astracore-ai/Astracore-Neo/09_synthesis/pnr_acc_bank.md

# pnr_acc_bank -- `acc_bank` placed and routed on ASAP7 through OpenROAD-flow-scripts

Generated by `07_ci/pnr/report.py` from the `pnr` job's logs (run 188 (workflow_dispatch on a3-physical at 2f2fb5b6f), started 2026-10-13 06:14:26 UTC; image `openroad/orfs:26Q4-124-g3451ca1f5`; make arguments `none`; ORFS targets `synth,floorplan,place,cts,route,do-finish`). Status: **complete**. The netlist is `synth.py`'s for the unit's subtree (acc_bank) at 1,250 ps on ASAP7 SS (ORFS CORNER = WC, the same NLDM files), the memory leaves as FakeRAM2.0 macros; ORFS's defaults otherwise (`07_ci/pnr/designs/neo_common.mk`, the block's `config.mk`). Timing is the final stage's: OpenRCX parasitics, the propagated clock tree. ASAP7 is a predictive academic PDK: the picoseconds and square microns are the library's, the ratios and the paths the design's.

| Figure | Value |
| --- | --- |
| die / core | 215.80 x 215.80 um / 213.73 x 213.57 um (46,571.4 / 45,646.7 um2) |
| utilization (cells and macros over the core, after routing) | 56.2 % |
| standard cells: synthesized (prep.py) / after placement / after routing | 19,220 / 24,323 / 24,729 (of these 4,898 timing-repair buffers, 173 tie cells, 2,880 taps; 82,987 fill cells beside them) |
| macros | 1 (22,822.5 um2) |
| cell area: synthesized / routed | 2,473.3 / 2,850.9 um2 |
| routed wire length / vias | 359,587 um / 246,356 |
| DRC violations after detailed routing (first iteration) / antenna-violating nets / diodes | 0 (5,607) / 0 / 0 |
| global-route congestion (usage, overflow H / V / total) | 13.49 %, 0 / 0 / 0 |
| setup WNS / TNS | **0.0 ps** / 0.0 ps (0 violating endpoints) |
| hold WNS / TNS | 34.8 / 0.0 ps (0 violating endpoints) |
| minimum period, register to register / with the I/O paths | 1,246.2 / 1,246.2 ps (802 MHz) |
| clock tree: sinks, buffers (TritonCTS), buffers on a path, levels | 2,286 (clk 1, clk_regs 2,285), 156, 2-5, 4; after routing 215 clock buffers + 65 clock inverters |
| clock skew, setup / hold (with the 8 % setup uncertainty in the setup figure) | 146.3 / 46.9 ps |
| power at the flow's default activity (internal / switching / leakage / total) | 5.680 / 1.680 / 0.1730 / **7.530 mW** |
| max slew / cap / fanout violations | 12 / 0 / 0 |

Power in this table: OpenSTA's default switching activity (0.1 transitions per cycle on the inputs, propagated; the flow sets none); the recorded activity's figure is in the section on power below when the block has one.

## Power: the default activity and the recorded activity

OpenSTA's report_power on the final database (OpenRCX parasitics, the propagated clock) at 1,250 ps, ASAP7 SS 0.63 V / 100 C (the WC corner's NLDM and power tables), in mW.

The recorded activity: `acc_bank.json.gz` -- cocotb core (16x8, NCHK = 4): C1 dense conv + C5 2:4 sparse conv, Verilator 5.020, scope `TOP.neo_core.u_dp.u_acc`, a window of 2,858 cycles at 500 ps in simulation (the activity is per cycle, applied at the period above); MAC utilization in the window 56.7 %. Of the block's 2,285 flops 622 took a recorded bit by name, 1,663 by the folded index (a wider unit than the one simulated: the bit of the same signal at the index modulo the recorded range), 0 kept the propagated default; input bits 87 / 2,057 / 0. Pins annotated in the database: 2285 of 2285, input ports 2144.

| activity | group | internal | switching | leakage | total |
| --- | --- | --- | --- | --- | --- |
| default | Sequential | 1.970 | 0.108 | 0.0145 | 2.090 |
| default | Combinational | 0.357 | 0.791 | 0.0272 | 1.180 |
| default | Clock | 1.210 | 0.776 | 0.0020 | 1.990 |
| default | Macro | 2.150 | 0.000 | 0.1290 | 2.280 |
| default | Total | 5.680 | 1.680 | 0.1730 | **7.530** |
| recorded | Sequential | 2.350 | 0.178 | 0.0147 | 2.550 |
| recorded | Combinational | 0.628 | 1.230 | 0.0294 | 1.890 |
| recorded | Clock | 1.210 | 0.776 | 0.0020 | 1.990 |
| recorded | Macro | 2.150 | 0.000 | 0.1290 | 2.280 |
| recorded | Total | 6.340 | 2.180 | 0.1750 | **8.700** |

Recorded / default: 1.155 (total), dynamic 1.158.

## The worst routed paths

Setup: `fwd1_reg` -> `u_mem/u_macro`, arrival 1,385.8 ps (launch clock latency included), required 1,389.6 ps, slack **3.8 ps**, 24 cells (`orfs/reports/6_finish.rpt`).

Hold: `idx1[8]_reg` -> `u_mem/u_macro`, slack 34.8 ps.

The ten worst endpoints (`orfs/reports/neo/paths_max.txt`): `u_mem/u_macro` 3.8, `u_mem/u_macro` 23.1, `u_mem/u_macro` 25.3, `u_mem/u_macro` 27.5, `new_q[95]_reg` 27.8, `new_q[863]_reg` 28.7, `u_mem/u_macro` 30.2, `u_abft.r_q[99]_reg` 30.6, `new_q[574]_reg` 31.9, `u_mem/u_macro` 32.6.

## Routed against synthesized

The synthesized estimate is the netlist ORFS placed (prep.py's) flat in OpenSTA with the same SDC, an ideal clock and no wires (`in/synth_sta/`); the routed figure is ORFS's final STA. A minimum period here is the period minus the worst slack of the paths named (the 8 % setup uncertainty and the setup time included on both sides). The routed netlist is not the synthesized one: the flow resizes and buffers it (timing repair in floorplan, CTS and global route), so the ratio carries both the wires and the repair.

| | synthesized | routed | routed / synthesized |
| --- | --- | --- | --- |
| setup WNS at 1,250 ps | 59.5 ps | 0.0 ps | |
| minimum period, register to register | 1,190.5 ps | 1,246.2 ps | 1.047 |
| minimum period with the I/O paths | 1,190.5 ps | 1,246.2 ps | 1.047 |

Setup WNS through the flow (repair_timing's own tables, before -> after its repair): CTS (placement parasitics, the propagated clock) -64.0 -> -9.0 ps; global route (its parasitics) -40.2 -> -15.1 ps; final (OpenRCX) 0.0 ps.

Synthesized worst path: `fwd1_reg` -> `u_mem/u_macro`, arrival 1,040.5 ps, slack 59.5 ps; register to register `fwd1_reg` -> `u_mem/u_macro`, slack 59.5 ps.

`synth.py`'s own figures for the units of the block (each unit with its children as extracted timing models, the synthesis job's per-unit view, 0.2 of the period on every unit's I/O):

| unit | instances in the block | cells (own) | WNS | minimum period | worst path |
| --- | --- | --- | --- | --- | --- |
| `acc_bank` | 1 | 18,131 | 59.5 ps | 1,190.5 ps | `fwd1_reg` -> `u_mem` |

The subtree's slowest unit by synth.py: `acc_bank` at 1,190.5 ps; routed register to register / that = 1.047.

## Macros (FakeRAM2.0, `07_ci/pnr/fakeram.py`)

| leaf (synth.py) | macro | words x bits, groups | pins | LEF size | LEF area | um2 / bit | synthesis model (memories.md) |
| --- | --- | --- | --- | --- | --- | --- | --- |
| `neo_mem_rf_w1056_d512_g1_rb1` | `fakeram7_512x1056_g1_1w1r` | 512 x 1056, G = 1 | 2133 | 136.99 x 166.60 um | 22,822.5 um2 | 0.0422 | 22,734.2 um2 (x1.0) |

Placed by ORFS's macro placer (lower-left corner, orientation): `u_mem/u_macro` at (1.1, 1.1) um R180.

## Runtime and peak memory

| ORFS step | elapsed | peak memory |
| --- | --- | --- |
| 1_1_yosys_canonicalize | 0.0 min | 27 MB |
| 1_2_yosys | 0.0 min | 26 MB |
| 1_synth | 0.0 min | 232 MB |
| 2_1_floorplan | 0.1 min | 286 MB |
| 2_2_floorplan_macro | 0.4 min | 264 MB |
| 2_3_floorplan_tapcell | 0.0 min | 205 MB |
| 2_4_floorplan_pdn | 0.0 min | 225 MB |
| 3_1_place_gp_skip_io | 0.1 min | 275 MB |
| 3_2_place_iop | 0.0 min | 219 MB |
| 3_3_place_gp | 1.6 min | 737 MB |
| 3_4_place_resized | 0.2 min | 304 MB |
| 3_5_place_dp | 0.2 min | 584 MB |
| 4_1_cts | 0.4 min | 598 MB |
| 5_1_grt | 2.4 min | 1,064 MB |
| 5_2_route | 13.9 min | 5,815 MB |
| 5_3_fillcell | 0.0 min | 502 MB |
| 6_1_fill | 0.0 min | 289 MB |
| 6_report | 0.5 min | 654 MB |
| 7_neo_report | 0.2 min | 477 MB |
| 4_rsz_lec (inside its stage's step) | 0.1 min | 159 MB |
| 6_final_lec (inside its stage's step) | 0.1 min | 158 MB |
| **all steps** | **20.3 min** | **5,815 MB** |

By stage: synth (netlist read) 0.0 min, 232 MB; floorplan 0.6 min, 286 MB; place 2.2 min, 737 MB; cts 0.4 min, 598 MB; route 16.4 min, 5,815 MB; finish 0.6 min, 654 MB; neo_report 0.2 min, 477 MB.

The job's own stages (`run.json`): fakeram exit 0 in 0.0 min; prep exit 0 in 0.0 min; synth_sta exit 0; activity exit 0 in 0.1 min; synth exit 0 in 0.1 min; floorplan exit 0 in 0.6 min; place exit 0 in 2.2 min; cts exit 0 in 0.4 min; route exit 0 in 16.4 min; do-finish exit 0 in 0.6 min; neo_report exit 0 in 0.2 min.
