astracore-ai/Astracore-Neo/09_synthesis/pnr_act_feeder.md

# pnr_act_feeder -- `act_feeder` placed and routed on ASAP7 through OpenROAD-flow-scripts

Generated by `07_ci/pnr/report.py` from the `pnr` job's logs (run 188 (workflow_dispatch on a3-physical at 2f2fb5b6f), started 2026-10-13 06:13:01 UTC; image `openroad/orfs:26Q4-124-g3451ca1f5`; make arguments `none`; ORFS targets `synth,floorplan,place,cts,route,do-finish`). Status: **complete**. The netlist is `synth.py`'s for the unit's subtree (act_feeder) at 1,250 ps on ASAP7 SS (ORFS CORNER = WC, the same NLDM files), the memory leaves as FakeRAM2.0 macros; ORFS's defaults otherwise (`07_ci/pnr/designs/neo_common.mk`, the block's `config.mk`). Timing is the final stage's: OpenRCX parasitics, the propagated clock tree. ASAP7 is a predictive academic PDK: the picoseconds and square microns are the library's, the ratios and the paths the design's.

| Figure | Value |
| --- | --- |
| die / core | 119.99 x 355.97 um / 117.94 x 353.70 um (42,712.1 / 41,714.0 um2) |
| utilization (cells and macros over the core, after routing) | 55.6 % |
| standard cells: synthesized (prep.py) / after placement / after routing | 9,084 / 13,183 / 13,245 (of these 1,856 timing-repair buffers, 435 tie cells, 3,389 taps; 67,358 fill cells beside them) |
| macros | 1 (22,064.7 um2) |
| cell area: synthesized / routed | 980.4 / 1,143.2 um2 |
| routed wire length / vias | 119,281 um / 91,446 |
| DRC violations after detailed routing (first iteration) / antenna-violating nets / diodes | 0 (2,048) / 0 / 0 |
| global-route congestion (usage, overflow H / V / total) | 5.08 %, 0 / 0 / 0 |
| setup WNS / TNS | **0.0 ps** / 0.0 ps (0 violating endpoints) |
| hold WNS / TNS | 73.6 / 0.0 ps (0 violating endpoints) |
| minimum period, register to register / with the I/O paths | 948.2 / 1,243.1 ps (804 MHz) |
| clock tree: sinks, buffers (TritonCTS), buffers on a path, levels | 436 (clk 1, clk_regs 435), 26, 2-3, 1; after routing 39 clock buffers + 12 clock inverters |
| clock skew, setup / hold (with the 8 % setup uncertainty in the setup figure) | 114.8 / 25.6 ps |
| power at the flow's default activity (internal / switching / leakage / total) | 4.850 / 2.340 / 0.1410 / **7.330 mW** |
| max slew / cap / fanout violations | 0 / 0 / 0 |

Power in this table: OpenSTA's default switching activity (0.1 transitions per cycle on the inputs, propagated; the flow sets none); the recorded activity's figure is in the section on power below when the block has one.

## Power: the default activity and the recorded activity

OpenSTA's report_power on the final database (OpenRCX parasitics, the propagated clock) at 1,250 ps, ASAP7 SS 0.63 V / 100 C (the WC corner's NLDM and power tables), in mW.

The recorded activity: `act_feeder.json.gz` -- cocotb core (16x8, NCHK = 4): C1 dense conv + C5 2:4 sparse conv, Verilator 5.020, scope `TOP.neo_core.u_dp.u_feeder`, a window of 2,858 cycles at 500 ps in simulation (the activity is per cycle, applied at the period above); MAC utilization in the window 56.7 %. Of the block's 435 flops 347 took a recorded bit by name, 66 by the folded index (a wider unit than the one simulated: the bit of the same signal at the index modulo the recorded range), 22 kept the propagated default; input bits 239 / 515 / 0. Pins annotated in the database: 413 of 413, input ports 754.

| activity | group | internal | switching | leakage | total |
| --- | --- | --- | --- | --- | --- |
| default | Sequential | 0.449 | 0.072 | 0.0010 | 0.522 |
| default | Combinational | 2.040 | 2.120 | 0.0108 | 4.180 |
| default | Clock | 0.210 | 0.139 | 0.0003 | 0.349 |
| default | Macro | 2.150 | 0.000 | 0.1290 | 2.280 |
| default | Total | 4.850 | 2.340 | 0.1410 | **7.330** |
| recorded | Sequential | 0.271 | 0.008 | 0.0012 | 0.280 |
| recorded | Combinational | 0.052 | 0.074 | 0.0149 | 0.141 |
| recorded | Clock | 0.210 | 0.139 | 0.0003 | 0.349 |
| recorded | Macro | 2.150 | 0.000 | 0.1290 | 2.280 |
| recorded | Total | 2.680 | 0.221 | 0.1450 | **3.050** |

Recorded / default: 0.416 (total), dynamic 0.403.

## The worst routed paths

Setup: `iy[16]_reg` -> `ctrl_err`, arrival 893.1 ps (launch clock latency included), required 900.0 ps, slack **6.9 ps**, 14 cells (`orfs/reports/6_finish.rpt`).

Register to register: `s2_d[4]_reg` -> `a_d[9]_reg`, slack 301.8 ps.

Hold: `m[8]_reg` -> `row_idx[8]_reg`, slack 73.6 ps.

The ten worst endpoints (`orfs/reports/neo/paths_max.txt`): `ctrl_err` 6.9, `x_vec[232]` 44.2, `x_vec[238]` 45.4, `x_vec[237]` 45.8, `x_vec[245]` 46.8, `x_vec[246]` 46.9, `x_vec[243]` 47.0, `x_vec[241]` 47.0, `x_vec[242]` 47.2, `x_vec[240]` 47.4.

## Routed against synthesized

The synthesized estimate is the netlist ORFS placed (prep.py's) flat in OpenSTA with the same SDC, an ideal clock and no wires (`in/synth_sta/`); the routed figure is ORFS's final STA. A minimum period here is the period minus the worst slack of the paths named (the 8 % setup uncertainty and the setup time included on both sides). The routed netlist is not the synthesized one: the flow resizes and buffers it (timing repair in floorplan, CTS and global route), so the ratio carries both the wires and the repair.

| | synthesized | routed | routed / synthesized |
| --- | --- | --- | --- |
| setup WNS at 1,250 ps | 146.9 ps | 0.0 ps | |
| minimum period, register to register | 892.0 ps | 948.2 ps | 1.063 |
| minimum period with the I/O paths | 1,103.1 ps | 1,243.1 ps | 1.127 |

Setup WNS through the flow (repair_timing's own tables, before -> after its repair): CTS (placement parasitics, the propagated clock) -74.1 -> -27.5 ps; global route (its parasitics) -49.8 -> -41.2 ps; final (OpenRCX) 0.0 ps.

Synthesized worst path: `cfg_ct[2]` -> `s1[10]_reg`, arrival 968.8 ps, slack 146.9 ps; register to register `c1_d[2]_reg` -> `a_d[9]_reg`, slack 358.0 ps.

`synth.py`'s own figures for the units of the block (each unit with its children as extracted timing models, the synthesis job's per-unit view, 0.2 of the period on every unit's I/O):

| unit | instances in the block | cells (own) | WNS | minimum period | worst path |
| --- | --- | --- | --- | --- | --- |
| `act_feeder` | 1 | 8,696 | 122.3 ps | 928.8 ps | `cfg_ct[2]` -> `s1[10]_reg` |

The subtree's slowest unit by synth.py: `act_feeder` at 928.8 ps; routed register to register / that = 1.021.

## Macros (FakeRAM2.0, `07_ci/pnr/fakeram.py`)

| leaf (synth.py) | macro | words x bits, groups | pins | LEF size | LEF area | um2 / bit | synthesis model (memories.md) |
| --- | --- | --- | --- | --- | --- | --- | --- |
| `neo_mem_rf_w512_d1024_g2_rb1` | `fakeram7_1024x512_g2_1w1r` | 1024 x 512, G = 2 | 1048 | 66.50 x 331.80 um | 22,064.7 um2 | 0.0421 | 22,045.3 um2 (x1.0) |

Placed by ORFS's macro placer (lower-left corner, orientation): `u_mem/u_macro` at (52.4, 1.1) um MX.

## Runtime and peak memory

| ORFS step | elapsed | peak memory |
| --- | --- | --- |
| 1_1_yosys_canonicalize | 0.0 min | 26 MB |
| 1_2_yosys | 0.0 min | 26 MB |
| 1_synth | 0.0 min | 202 MB |
| 2_1_floorplan | 0.0 min | 248 MB |
| 2_2_floorplan_macro | 0.2 min | 227 MB |
| 2_3_floorplan_tapcell | 0.0 min | 191 MB |
| 2_4_floorplan_pdn | 0.0 min | 209 MB |
| 3_1_place_gp_skip_io | 0.1 min | 256 MB |
| 3_2_place_iop | 0.0 min | 199 MB |
| 3_3_place_gp | 0.4 min | 715 MB |
| 3_4_place_resized | 0.1 min | 257 MB |
| 3_5_place_dp | 0.1 min | 398 MB |
| 4_1_cts | 0.1 min | 419 MB |
| 5_1_grt | 0.6 min | 851 MB |
| 5_2_route | 4.8 min | 4,116 MB |
| 5_3_fillcell | 0.0 min | 426 MB |
| 6_1_fill | 0.0 min | 247 MB |
| 6_report | 0.2 min | 412 MB |
| 7_neo_report | 0.1 min | 335 MB |
| 4_rsz_lec (inside its stage's step) | 0.0 min | 71 MB |
| 6_final_lec (inside its stage's step) | 0.0 min | 71 MB |
| **all steps** | **6.8 min** | **4,116 MB** |

By stage: synth (netlist read) 0.0 min, 202 MB; floorplan 0.2 min, 248 MB; place 0.7 min, 715 MB; cts 0.1 min, 419 MB; route 5.5 min, 4,116 MB; finish 0.2 min, 412 MB; neo_report 0.1 min, 335 MB.

The job's own stages (`run.json`): fakeram exit 0; prep exit 0 in 0.0 min; synth_sta exit 0; activity exit 0 in 0.1 min; synth exit 0 in 0.1 min; floorplan exit 0 in 0.3 min; place exit 0 in 0.8 min; cts exit 0 in 0.1 min; route exit 0 in 5.5 min; do-finish exit 0 in 0.2 min; neo_report exit 0 in 0.1 min.
