astracore-ai/Astracore-Neo/09_synthesis/pnr_bank_bist_wrap.md

# pnr_bank_bist_wrap -- `bank_bist_wrap` placed and routed on ASAP7 through OpenROAD-flow-scripts

Generated by `07_ci/pnr/report.py` from the `pnr` job's logs (run 194 (workflow_dispatch on a3-physical at 97c3b1c0e), started 2026-10-13 06:42:08 UTC; image `openroad/orfs:26Q4-124-g3451ca1f5`; make arguments `none`; ORFS targets `synth,floorplan,place,cts,route,do-finish`). Status: **complete**. The netlist is `synth.py`'s for the unit's subtree (sram_bank, mbist, bank_bist_wrap) at 1,250 ps on ASAP7 SS (ORFS CORNER = WC, the same NLDM files), the memory leaves as FakeRAM2.0 macros; ORFS's defaults otherwise (`07_ci/pnr/designs/neo_common.mk`, the block's `config.mk`). Timing is the final stage's: OpenRCX parasitics, the propagated clock tree. ASAP7 is a predictive academic PDK: the picoseconds and square microns are the library's, the ratios and the paths the design's.

| Figure | Value |
| --- | --- |
| die / core | 1201.53 x 1201.53 um / 1199.45 x 1199.34 um (1,443,660.0 / 1,438,550.0 um2) |
| utilization (cells and macros over the core, after routing) | 60.2 % |
| standard cells: synthesized (prep.py) / after placement / after routing | 7,205 / 75,407 / 76,204 (of these 4,398 timing-repair buffers, 135 tie cells, 65,000 taps; 1,754,792 fill cells beside them) |
| macros | 16 (862,508.0 um2) |
| cell area: synthesized / routed | 853.8 / 3,722.2 um2 |
| routed wire length / vias | 504,242 um / 163,613 |
| DRC violations after detailed routing (first iteration) / antenna-violating nets / diodes | 0 (9,130) / 0 / 0 |
| global-route congestion (usage, overflow H / V / total) | 0.69 %, 0 / 0 / 0 |
| setup WNS / TNS | **-1,756.6 ps** / -1,164,350.2 ps (1,570 violating endpoints) |
| hold WNS / TNS | 92.8 / 0.0 ps (0 violating endpoints) |
| minimum period, register to register / with the I/O paths | 2,838.6 / 3,006.6 ps (333 MHz) |
| clock tree: sinks, buffers (TritonCTS), buffers on a path, levels | 96 (clk 16, clk_regs 80), 36, 2-9, 3; after routing 93 clock buffers + 3 clock inverters |
| clock skew, setup / hold (with the 8 % setup uncertainty in the setup figure) | 290.6 / 201.1 ps |
| power at the flow's default activity (internal / switching / leakage / total) | 44.500 / 16.800 / 2.1000 / **63.500 mW** |
| max slew / cap / fanout violations | 415 / 0 / 0 |

Power in this table: OpenSTA's default switching activity (0.1 transitions per cycle on the inputs, propagated; the flow sets none); the recorded activity's figure is in the section on power below when the block has one.

## Power: the default activity and the recorded activity

OpenSTA's report_power on the final database (OpenRCX parasitics, the propagated clock) at 1,250 ps, ASAP7 SS 0.63 V / 100 C (the WC corner's NLDM and power tables), in mW.

The recorded activity: `bank_bist_wrap.json.gz` -- cocotb tile (2x2 mesh of 16x8 cores, 32 words per link flit): M1 + M18 + M19, tile (0,0), Verilator 5.020, scope `TOP.tile_mesh_cocotb.u_mesh.g_y[0].g_x[0].u_t.u_bank`, a window of 10,306 cycles at 500 ps in simulation (the activity is per cycle, applied at the period above); MAC utilization in the window 32.8 %. Of the block's 80 flops 45 took a recorded bit by name, 35 by the folded index (a wider unit than the one simulated: the bit of the same signal at the index modulo the recorded range), 0 kept the propagated default; input bits 652 / 28 / 0. Pins annotated in the database: 80 of 80, input ports 680.

| activity | group | internal | switching | leakage | total |
| --- | --- | --- | --- | --- | --- |
| default | Sequential | 0.088 | 0.037 | 0.0002 | 0.126 |
| default | Combinational | 9.170 | 16.400 | 0.0398 | 25.600 |
| default | Clock | 0.508 | 0.457 | 0.0008 | 0.966 |
| default | Macro | 34.800 | 0.000 | 2.0600 | 36.800 |
| default | Total | 44.500 | 16.800 | 2.1000 | **63.500** |
| recorded | Sequential | 0.051 | 0.000 | 0.0002 | 0.052 |
| recorded | Combinational | 0.029 | 0.043 | 0.0565 | 0.128 |
| recorded | Clock | 0.508 | 0.457 | 0.0008 | 0.966 |
| recorded | Macro | 34.400 | 0.000 | 2.0600 | 36.500 |
| recorded | Total | 35.000 | 0.499 | 2.1200 | **37.600** |

Recorded / default: 0.592 (total), dynamic 0.579.

## The worst routed paths

Setup: `u_bank/u_mem/u_lane7` -> `rdata[236]`, arrival 2,656.6 ps (launch clock latency included), required 900.0 ps, slack **-1,756.6 ps**, 15 cells (`orfs/reports/6_finish.rpt`).

Register to register: `u_bist/elem[1]_reg` -> `u_bank/u_mem/u_lane12`, slack -1,588.6 ps.

Hold: `u_bist/mism_q_reg` -> `u_bist/mism_q_reg`, slack 92.8 ps.

The ten worst endpoints (`orfs/reports/neo/paths_max.txt`): `rdata[236]` -1756.6, `u_bank/u_mem/u_lane12` -1588.6, `u_bank/u_mem/u_lane12` -1550.2, `rdata[336]` -1527.4, `u_bank/u_mem/u_lane13` -1523.6, `rdata[351]` -1522.3, `rdata[338]` -1494.5, `rdata[350]` -1490.5, `rdata[322]` -1485.9, `u_bank/u_mem/u_lane12` -1484.0.

## Routed against synthesized

The synthesized estimate is the netlist ORFS placed (prep.py's) flat in OpenSTA with the same SDC, an ideal clock and no wires (`in/synth_sta/`); the routed figure is ORFS's final STA. A minimum period here is the period minus the worst slack of the paths named (the 8 % setup uncertainty and the setup time included on both sides). The routed netlist is not the synthesized one: the flow resizes and buffers it (timing repair in floorplan, CTS and global route), so the ratio carries both the wires and the repair.

| | synthesized | routed | routed / synthesized |
| --- | --- | --- | --- |
| setup WNS at 1,250 ps | -188.6 ps | -1,756.6 ps | |
| minimum period, register to register | 1,438.6 ps | 2,838.6 ps | 1.973 |
| minimum period with the I/O paths | 1,438.6 ps | 3,006.6 ps | 2.090 |

Setup WNS through the flow (repair_timing's own tables, before -> after its repair): floorplan (no wires, ideal clock: the synthesized estimate, then gate sizing) -188.6 -> -39.4 ps; CTS (placement parasitics, the propagated clock) -2,525.3 -> -2,320.5 ps; global route (its parasitics) -1,971.0 -> -1,819.4 ps; final (OpenRCX) -1,756.6 ps.

Synthesized worst path: `u_bist/elem[1]_reg` -> `u_bank/u_mem/u_lane0`, arrival 1,288.6 ps, slack -188.6 ps; register to register `u_bist/elem[1]_reg` -> `u_bank/u_mem/u_lane0`, slack -188.6 ps.

`synth.py`'s own figures for the units of the block (each unit with its children as extracted timing models, the synthesis job's per-unit view, 0.2 of the period on every unit's I/O):

| unit | instances in the block | cells (own) | WNS | minimum period | worst path |
| --- | --- | --- | --- | --- | --- |
| `bank_bist_wrap` | 1 | 1,245 | 8.0 ps | 1,242.0 ps | `u_bist` -> `u_bank` |
| `mbist` | 1 | 1,025 | 138.8 ps | 1,111.2 ps | `elem[1]_reg` -> `state[1]_reg` |
| `sram_bank` | 1 | 3,742 | 198.6 ps | 826.8 ps | `u_mem` -> `rdata[46]` |

The subtree's slowest unit by synth.py: `bank_bist_wrap` at 1,242.0 ps; routed register to register / that = 2.285.

## Macros (FakeRAM2.0, `07_ci/pnr/fakeram.py`)

| leaf (synth.py) | macro | words x bits, groups | pins | LEF size | LEF area | um2 / bit | synthesis model (memories.md) |
| --- | --- | --- | --- | --- | --- | --- | --- |
| `neo_mem_sp_w624_d32768_g16` | `fakeram7_32768x39_cm64_1w1r` | 32768 x 624, G = 16 | 111 | 323.57 x 166.60 um | 862,508.2 um2 | 0.0422 | 859,765.2 um2 (x1.0) |

Placed by ORFS's macro placer (lower-left corner, orientation): `u_bank/u_mem/u_lane0` at (21.0, 3.1) um R0; `u_bank/u_mem/u_lane1` at (364.6, 3.1) um R0; `u_bank/u_mem/u_lane10` at (364.6, 514.9) um R0; `u_bank/u_mem/u_lane11` at (708.2, 514.9) um R0; `u_bank/u_mem/u_lane12` at (21.0, 685.5) um R0; `u_bank/u_mem/u_lane13` at (364.6, 685.5) um R0; `u_bank/u_mem/u_lane14` at (708.2, 685.5) um R0; `u_bank/u_mem/u_lane15` at (21.0, 856.1) um R0; `u_bank/u_mem/u_lane2` at (708.2, 3.1) um R0; `u_bank/u_mem/u_lane3` at (21.0, 173.7) um R0; `u_bank/u_mem/u_lane4` at (364.6, 173.7) um R0; `u_bank/u_mem/u_lane5` at (708.2, 173.7) um R0; `u_bank/u_mem/u_lane6` at (21.0, 344.3) um R0; `u_bank/u_mem/u_lane7` at (364.6, 344.3) um R0; `u_bank/u_mem/u_lane8` at (708.2, 344.3) um R0; `u_bank/u_mem/u_lane9` at (21.0, 514.9) um R0.

## Runtime and peak memory

| ORFS step | elapsed | peak memory |
| --- | --- | --- |
| 1_1_yosys_canonicalize | 0.0 min | 26 MB |
| 1_2_yosys | 0.0 min | 27 MB |
| 1_synth | 0.0 min | 198 MB |
| 2_1_floorplan | 0.1 min | 244 MB |
| 2_2_floorplan_macro | 0.0 min | 187 MB |
| 2_3_floorplan_tapcell | 0.0 min | 223 MB |
| 2_4_floorplan_pdn | 0.3 min | 574 MB |
| 3_1_place_gp_skip_io | 3.0 min | 947 MB |
| 3_2_place_iop | 0.1 min | 366 MB |
| 3_3_place_gp | 3.9 min | 978 MB |
| 3_4_place_resized | 0.1 min | 417 MB |
| 3_5_place_dp | 0.7 min | 5,460 MB |
| 4_1_cts | 0.6 min | 5,521 MB |
| 5_1_grt | 5.4 min | 13,442 MB |
| 5_2_route | 59.6 min | 11,107 MB |
| 5_3_fillcell | 0.3 min | 7,207 MB |
| 6_1_fill | 0.1 min | 1,482 MB |
| 6_report | 1.1 min | 2,453 MB |
| 7_neo_report | 0.5 min | 2,461 MB |
| 4_rsz_lec (inside its stage's step) | 0.0 min | 55 MB |
| 6_final_lec (inside its stage's step) | 0.0 min | 85 MB |
| **all steps** | **75.8 min** | **13,442 MB** |

By stage: synth (netlist read) 0.0 min, 198 MB; floorplan 0.5 min, 574 MB; place 7.7 min, 5,460 MB; cts 0.6 min, 5,521 MB; route 65.3 min, 13,442 MB; finish 1.1 min, 2,453 MB; neo_report 0.5 min, 2,461 MB.

The job's own stages (`run.json`): fakeram exit 0 in 0.0 min; prep exit 0 in 0.0 min; synth_sta exit 0; activity exit 0 in 0.1 min; synth exit 0 in 0.1 min; floorplan exit 0 in 0.5 min; place exit 0 in 7.8 min; cts exit 0 in 0.7 min; route exit 0 in 65.4 min; do-finish exit 0 in 1.2 min; neo_report exit 0 in 0.5 min.
