astracore-ai/Astracore-Neo/09_synthesis/pnr_link_unpacker.md

# pnr_link_unpacker -- `link_unpacker` placed and routed on ASAP7 through OpenROAD-flow-scripts

Generated by `07_ci/pnr/report.py` from the `pnr` job's logs (run 188 (workflow_dispatch on a3-physical at 2f2fb5b6f), started 2026-10-13 06:12:37 UTC; image `openroad/orfs:26Q4-124-g3451ca1f5`; make arguments `none`; ORFS targets `synth,floorplan,place,cts,route,do-finish`). Status: **complete**. The netlist is `synth.py`'s for the unit's subtree (link_unpacker) at 1,250 ps on ASAP7 SS (ORFS CORNER = WC, the same NLDM files), the memory leaves as FakeRAM2.0 macros; ORFS's defaults otherwise (`07_ci/pnr/designs/neo_common.mk`, the block's `config.mk`). Timing is the final stage's: OpenRCX parasitics, the propagated clock tree. ASAP7 is a predictive academic PDK: the picoseconds and square microns are the library's, the ratios and the paths the design's.

| Figure | Value |
| --- | --- |
| die / core | 33.12 x 33.12 um / 31.05 x 30.78 um (1,097.3 / 955.7 um2) |
| utilization (cells and macros over the core, after routing) | 47.9 % |
| standard cells: synthesized (prep.py) / after placement / after routing | 2,920 / 4,715 / 4,718 (of these 1,717 timing-repair buffers, 8 tie cells, 286 taps; 5,635 fill cells beside them) |
| macros | 0 (0.0 um2) |
| cell area: synthesized / routed | 339.1 / 457.9 um2 |
| routed wire length / vias | 16,293 um / 33,306 |
| DRC violations after detailed routing (first iteration) / antenna-violating nets / diodes | 0 (449) / 0 / 0 |
| global-route congestion (usage, overflow H / V / total) | 16.95 %, 0 / 0 / 0 |
| setup WNS / TNS | **0.0 ps** / 0.0 ps (0 violating endpoints) |
| hold WNS / TNS | 109.1 / 0.0 ps (0 violating endpoints) |
| minimum period, register to register / with the I/O paths | 608.7 / 1,171.2 ps (854 MHz) |
| clock tree: sinks, buffers (TritonCTS), buffers on a path, levels | 8, 3, 2-2, 1; after routing 3 clock buffers + n/a clock inverters |
| clock skew, setup / hold (with the 8 % setup uncertainty in the setup figure) | 101.1 / 2.8 ps |
| power at the flow's default activity (internal / switching / leakage / total) | 0.714 / 0.482 / 0.0053 / **1.200 mW** |
| max slew / cap / fanout violations | 0 / 0 / 0 |

Power in this table: OpenSTA's default switching activity (0.1 transitions per cycle on the inputs, propagated; the flow sets none); the recorded activity's figure is in the section on power below when the block has one.

## Power: the default activity and the recorded activity

OpenSTA's report_power on the final database (OpenRCX parasitics, the propagated clock) at 1,250 ps, ASAP7 SS 0.63 V / 100 C (the WC corner's NLDM and power tables), in mW.

The recorded activity: `link_unpacker.json.gz` -- cocotb tile (2x2 mesh of 16x8 cores, 32 words per link flit): M1 + M18 + M19, tile (0,0), Verilator 5.020, scope `TOP.tile_mesh_cocotb.u_mesh.g_y[0].g_x[0].u_t.u_unpack`, a window of 10,306 cycles at 500 ps in simulation (the activity is per cycle, applied at the period above); MAC utilization in the window 32.8 %. Of the block's 8 flops 8 took a recorded bit by name, 0 by the folded index (a wider unit than the one simulated: the bit of the same signal at the index modulo the recorded range), 0 kept the propagated default; input bits 1,071 / 8 / 0. Pins annotated in the database: 8 of 8, input ports 1079.

| activity | group | internal | switching | leakage | total |
| --- | --- | --- | --- | --- | --- |
| default | Sequential | 0.006 | 0.003 | 0.0000 | 0.009 |
| default | Combinational | 0.701 | 0.478 | 0.0052 | 1.180 |
| default | Clock | 0.006 | 0.002 | 0.0000 | 0.008 |
| default | Total | 0.714 | 0.482 | 0.0053 | **1.200** |
| recorded | Sequential | 0.005 | 0.000 | 0.0000 | 0.005 |
| recorded | Combinational | 0.050 | 0.041 | 0.0090 | 0.100 |
| recorded | Clock | 0.006 | 0.002 | 0.0000 | 0.008 |
| recorded | Total | 0.062 | 0.043 | 0.0091 | **0.114** |

Recorded / default: 0.095 (total), dynamic 0.087.

## The worst routed paths

Setup: `link_flit[273]` -> `core_flit[564]`, arrival 821.2 ps (launch clock latency included), required 900.0 ps, slack **78.8 ps**, 14 cells (`orfs/reports/6_finish.rpt`).

Register to register: `idx[0]_reg` -> `base[5]_reg`, slack 641.3 ps.

Hold: `idx[5]_reg` -> `idx[5]_reg`, slack 109.1 ps.

The ten worst endpoints (`orfs/reports/neo/paths_max.txt`): `core_flit[564]` 78.8, `core_flit[270]` 191.7, `core_flit[273]` 193.6, `core_flit[293]` 194.5, `core_flit[275]` 195.4, `core_flit[295]` 195.9, `core_flit[292]` 196.0, `core_flit[291]` 196.1, `core_flit[286]` 196.2, `core_flit[306]` 196.3.

## Routed against synthesized

The synthesized estimate is the netlist ORFS placed (prep.py's) flat in OpenSTA with the same SDC, an ideal clock and no wires (`in/synth_sta/`); the routed figure is ORFS's final STA. A minimum period here is the period minus the worst slack of the paths named (the 8 % setup uncertainty and the setup time included on both sides). The routed netlist is not the synthesized one: the flow resizes and buffers it (timing repair in floorplan, CTS and global route), so the ratio carries both the wires and the repair.

| | synthesized | routed | routed / synthesized |
| --- | --- | --- | --- |
| setup WNS at 1,250 ps | 152.9 ps | 0.0 ps | |
| minimum period, register to register | 542.0 ps | 608.7 ps | 1.123 |
| minimum period with the I/O paths | 1,097.1 ps | 1,171.2 ps | 1.068 |

Synthesized worst path: `link_flit[1029]` -> `core_flit[564]`, arrival 747.1 ps, slack 152.9 ps; register to register `idx[0]_reg` -> `idx[4]_reg`, slack 708.0 ps.

`synth.py`'s own figures for the units of the block (each unit with its children as extracted timing models, the synthesis job's per-unit view, 0.2 of the period on every unit's I/O):

| unit | instances in the block | cells (own) | WNS | minimum period | worst path |
| --- | --- | --- | --- | --- | --- |
| `link_unpacker` | 1 | 2,876 | 152.9 ps | n/a ps | `link_flit[1029]` -> `core_flit[564]` |

The subtree's slowest unit by synth.py: `link_unpacker` at 0.0 ps.

## Runtime and peak memory

| ORFS step | elapsed | peak memory |
| --- | --- | --- |
| 1_1_yosys_canonicalize | 0.0 min | 27 MB |
| 1_2_yosys | 0.0 min | 27 MB |
| 1_synth | 0.0 min | 187 MB |
| 2_1_floorplan | 0.0 min | 223 MB |
| 2_2_floorplan_macro | 0.0 min | 183 MB |
| 2_3_floorplan_tapcell | 0.0 min | 183 MB |
| 2_4_floorplan_pdn | 0.0 min | 184 MB |
| 3_1_place_gp_skip_io | 0.0 min | 189 MB |
| 3_2_place_iop | 0.0 min | 185 MB |
| 3_3_place_gp | 0.1 min | 368 MB |
| 3_4_place_resized | 0.1 min | 227 MB |
| 3_5_place_dp | 0.1 min | 211 MB |
| 4_1_cts | 0.1 min | 240 MB |
| 5_1_grt | 0.3 min | 389 MB |
| 5_2_route | 2.1 min | 1,285 MB |
| 5_3_fillcell | 0.0 min | 200 MB |
| 6_1_fill | 0.0 min | 191 MB |
| 6_report | 0.1 min | 272 MB |
| 7_neo_report | 0.0 min | 216 MB |
| 4_rsz_lec (inside its stage's step) | 0.0 min | 35 MB |
| 6_final_lec (inside its stage's step) | 0.0 min | 33 MB |
| **all steps** | **3.1 min** | **1,285 MB** |

By stage: synth (netlist read) 0.0 min, 187 MB; floorplan 0.1 min, 223 MB; place 0.3 min, 368 MB; cts 0.1 min, 240 MB; route 2.4 min, 1,285 MB; finish 0.1 min, 272 MB; neo_report 0.0 min, 216 MB.

The job's own stages (`run.json`): fakeram exit 0; prep exit 0 in 0.0 min; synth_sta exit 0; activity exit 0 in 0.1 min; synth exit 0 in 0.0 min; floorplan exit 0 in 0.1 min; place exit 0 in 0.3 min; cts exit 0 in 0.1 min; route exit 0 in 2.5 min; do-finish exit 0 in 0.2 min; neo_report exit 0 in 0.1 min.
