astracore-ai/Astracore-Neo/09_synthesis/pnr_noc_router.md

# pnr_noc_router -- `noc_router` placed and routed on ASAP7 through OpenROAD-flow-scripts

Generated by `07_ci/pnr/report.py` from the `pnr` job's logs (run 188 (workflow_dispatch on a3-physical at 2f2fb5b6f), started 2026-10-13 06:14:22 UTC; image `openroad/orfs:26Q4-124-g3451ca1f5`; make arguments `none`; ORFS targets `synth,floorplan,place,cts,route,do-finish`). Status: **complete**. The netlist is `synth.py`'s for the unit's subtree (noc_router) at 1,250 ps on ASAP7 SS (ORFS CORNER = WC, the same NLDM files), the memory leaves as FakeRAM2.0 macros; ORFS's defaults otherwise (`07_ci/pnr/designs/neo_common.mk`, the block's `config.mk`). Timing is the final stage's: OpenRCX parasitics, the propagated clock tree. ASAP7 is a predictive academic PDK: the picoseconds and square microns are the library's, the ratios and the paths the design's.

| Figure | Value |
| --- | --- |
| die / core | 196.82 x 196.82 um / 194.78 x 194.67 um (38,739.7 / 37,917.4 um2) |
| utilization (cells and macros over the core, after routing) | 39.1 % |
| standard cells: synthesized (prep.py) / after placement / after routing | 89,569 / 105,909 / 107,767 (of these 16,040 timing-repair buffers, 5,441 tie cells, 3,972 taps; 166,202 fill cells beside them) |
| macros | 0 (0.0 um2) |
| cell area: synthesized / routed | 13,284.9 / 14,826.7 um2 |
| routed wire length / vias | 892,923 um / 1,303,249 |
| DRC violations after detailed routing (first iteration) / antenna-violating nets / diodes | 0 (52,898) / 0 / 0 |
| global-route congestion (usage, overflow H / V / total) | 25.90 %, 0 / 0 / 0 |
| setup WNS / TNS | **0.0 ps** / 0.0 ps (0 violating endpoints) |
| hold WNS / TNS | 98.7 / 0.0 ps (0 violating endpoints) |
| minimum period, register to register / with the I/O paths | 1,216.9 / 1,216.9 ps (822 MHz) |
| clock tree: sinks, buffers (TritonCTS), buffers on a path, levels | 16,271, 982, 7-7, 6; after routing 1,393 clock buffers + 454 clock inverters |
| clock skew, setup / hold (with the 8 % setup uncertainty in the setup figure) | 141.4 / 51.7 ps |
| power at the flow's default activity (internal / switching / leakage / total) | 20.600 / 8.070 / 0.2330 / **29.000 mW** |
| max slew / cap / fanout violations | 480 / 0 / 0 |

Power in this table: OpenSTA's default switching activity (0.1 transitions per cycle on the inputs, propagated; the flow sets none); the recorded activity's figure is in the section on power below when the block has one.

## Power: the default activity and the recorded activity

OpenSTA's report_power on the final database (OpenRCX parasitics, the propagated clock) at 1,250 ps, ASAP7 SS 0.63 V / 100 C (the WC corner's NLDM and power tables), in mW.

The recorded activity: `noc_router.json.gz` -- cocotb tile (2x2 mesh of 16x8 cores, 32 words per link flit): M1 + M18 + M19, tile (0,0), Verilator 5.020, scope `TOP.tile_mesh_cocotb.u_mesh.g_y[0].g_x[0].u_t.u_router`, a window of 10,306 cycles at 500 ps in simulation (the activity is per cycle, applied at the period above); MAC utilization in the window 32.8 %. Of the block's 16,271 flops 28 took a recorded bit by name, 16,243 by the folded index (a wider unit than the one simulated: the bit of the same signal at the index modulo the recorded range), 0 kept the propagated default; input bits 1,087 / 5,397 / 0. Pins annotated in the database: 16271 of 16271, input ports 6484.

| activity | group | internal | switching | leakage | total |
| --- | --- | --- | --- | --- | --- |
| default | Sequential | 10.700 | 0.023 | 0.0842 | 10.800 |
| default | Combinational | 2.600 | 3.220 | 0.1370 | 5.960 |
| default | Clock | 7.390 | 4.830 | 0.0121 | 12.200 |
| default | Total | 20.600 | 8.070 | 0.2330 | **29.000** |
| recorded | Sequential | 11.600 | 0.002 | 0.0904 | 11.700 |
| recorded | Combinational | 0.102 | 0.316 | 0.1470 | 0.566 |
| recorded | Clock | 7.390 | 4.830 | 0.0121 | 12.200 |
| recorded | Total | 19.100 | 5.150 | 0.2490 | **24.500** |

Recorded / default: 0.845 (total), dynamic 0.846.

## The worst routed paths

Setup: `rd_a[4]_reg` -> `out_flit[4988]_reg`, arrival 1,405.7 ps (launch clock latency included), required 1,438.8 ps, slack **33.1 ps**, 17 cells (`orfs/reports/6_finish.rpt`).

Hold: `head_valid[2]_reg` -> `head_valid[2]_reg`, slack 98.7 ps.

The ten worst endpoints (`orfs/reports/neo/paths_max.txt`): `out_flit[4988]_reg` 33.1, `out_flit[4987]_reg` 33.7, `out_flit[4991]_reg` 34.6, `out_flit[4986]_reg` 35.7, `out_flit[4990]_reg` 38.1, `out_flit[4995]_reg` 39.4, `out_flit[5040]_reg` 40.0, `out_flit[4996]_reg` 40.9, `out_flit[5059]_reg` 42.2, `out_flit[4994]_reg` 42.7.

## Routed against synthesized

The synthesized estimate is the netlist ORFS placed (prep.py's) flat in OpenSTA with the same SDC, an ideal clock and no wires (`in/synth_sta/`); the routed figure is ORFS's final STA. A minimum period here is the period minus the worst slack of the paths named (the 8 % setup uncertainty and the setup time included on both sides). The routed netlist is not the synthesized one: the flow resizes and buffers it (timing repair in floorplan, CTS and global route), so the ratio carries both the wires and the repair.

| | synthesized | routed | routed / synthesized |
| --- | --- | --- | --- |
| setup WNS at 1,250 ps | 355.2 ps | 0.0 ps | |
| minimum period, register to register | 794.6 ps | 1,216.9 ps | 1.531 |
| minimum period with the I/O paths | 894.8 ps | 1,216.9 ps | 1.360 |

Synthesized worst path: `in_flit[2015]` -> `fbad[0][7]_reg`, arrival 775.3 ps, slack 355.2 ps; register to register `rd_a[0]_reg` -> `head_valid[4]_reg`, slack 455.4 ps.

`synth.py`'s own figures for the units of the block (each unit with its children as extracted timing models, the synthesis job's per-unit view, 0.2 of the period on every unit's I/O):

| unit | instances in the block | cells (own) | WNS | minimum period | worst path |
| --- | --- | --- | --- | --- | --- |
| `noc_router` | 1 | 89,608 | 355.2 ps | 794.6 ps | `in_flit[2015]` -> `fbad[0][7]_reg` |

The subtree's slowest unit by synth.py: `noc_router` at 794.6 ps; routed register to register / that = 1.531.

## Runtime and peak memory

| ORFS step | elapsed | peak memory |
| --- | --- | --- |
| 1_1_yosys_canonicalize | 0.0 min | 26 MB |
| 1_2_yosys | 0.0 min | 26 MB |
| 1_synth | 0.1 min | 397 MB |
| 2_1_floorplan | 0.4 min | 607 MB |
| 2_2_floorplan_macro | 0.0 min | 309 MB |
| 2_3_floorplan_tapcell | 0.0 min | 299 MB |
| 2_4_floorplan_pdn | 0.1 min | 328 MB |
| 3_1_place_gp_skip_io | 0.4 min | 507 MB |
| 3_2_place_iop | 0.1 min | 337 MB |
| 3_3_place_gp | 2.9 min | 1,455 MB |
| 3_4_place_resized | 1.1 min | 742 MB |
| 3_5_place_dp | 1.3 min | 1,080 MB |
| 4_1_cts | 1.6 min | 1,190 MB |
| 5_1_grt | 12.9 min | 2,220 MB |
| 5_2_route | 100.0 min | 15,147 MB |
| 5_3_fillcell | 0.1 min | 820 MB |
| 6_1_fill | 0.1 min | 541 MB |
| 6_report | 2.6 min | 2,212 MB |
| 7_neo_report | 1.0 min | 1,488 MB |
| 4_rsz_lec (inside its stage's step) | 0.2 min | 609 MB |
| 6_final_lec (inside its stage's step) | 0.6 min | 2,182 MB |
| **all steps** | **124.5 min** | **15,147 MB** |

By stage: synth (netlist read) 0.1 min, 397 MB; floorplan 0.6 min, 607 MB; place 5.6 min, 1,455 MB; cts 1.6 min, 1,190 MB; route 113.0 min, 15,147 MB; finish 2.6 min, 2,212 MB; neo_report 1.0 min, 1,488 MB.

The job's own stages (`run.json`): fakeram exit 0; prep exit 0 in 0.2 min; synth_sta exit 0; activity exit 0 in 0.1 min; synth exit 0 in 0.1 min; floorplan exit 0 in 0.6 min; place exit 0 in 5.7 min; cts exit 0 in 1.6 min; route exit 0 in 113.1 min; do-finish exit 0 in 2.7 min; neo_report exit 0 in 1.0 min.
