astracore-ai/Astracore-Neo/09_synthesis/pnr_prog_mem.md

# pnr_prog_mem -- `prog_mem` placed and routed on ASAP7 through OpenROAD-flow-scripts

Generated by `07_ci/pnr/report.py` from the `pnr` job's logs (run 188 (workflow_dispatch on a3-physical at 2f2fb5b6f), started 2026-10-13 06:13:56 UTC; image `openroad/orfs:26Q4-124-g3451ca1f5`; make arguments `none`; ORFS targets `synth,floorplan,place,cts,route,do-finish`). Status: **complete**. The netlist is `synth.py`'s for the unit's subtree (prog_mem) at 1,250 ps on ASAP7 SS (ORFS CORNER = WC, the same NLDM files), the memory leaves as FakeRAM2.0 macros; ORFS's defaults otherwise (`07_ci/pnr/designs/neo_common.mk`, the block's `config.mk`). Timing is the final stage's: OpenRCX parasitics, the propagated clock tree. ASAP7 is a predictive academic PDK: the picoseconds and square microns are the library's, the ratios and the paths the design's.

| Figure | Value |
| --- | --- |
| die / core | 61.53 x 61.53 um / 59.45 x 59.40 um (3,785.9 / 3,531.6 um2) |
| utilization (cells and macros over the core, after routing) | 58.0 % |
| standard cells: synthesized (prep.py) / after placement / after routing | 13,881 / 14,330 / 14,595 (of these 1,137 timing-repair buffers, 66 tie cells, 662 taps; 16,683 fill cells beside them) |
| macros | 0 (0.0 um2) |
| cell area: synthesized / routed | 1,949.1 / 2,046.7 um2 |
| routed wire length / vias | 64,235 um / 140,751 |
| DRC violations after detailed routing (first iteration) / antenna-violating nets / diodes | 0 (3,534) / 0 / 0 |
| global-route congestion (usage, overflow H / V / total) | 19.47 %, 0 / 0 / 0 |
| setup WNS / TNS | **0.0 ps** / 0.0 ps (0 violating endpoints) |
| hold WNS / TNS | 104.0 / 0.0 ps (0 violating endpoints) |
| minimum period, register to register / with the I/O paths | 980.8 / 1,193.9 ps (838 MHz) |
| clock tree: sinks, buffers (TritonCTS), buffers on a path, levels | 2,562, 154, 4-4, 4; after routing 247 clock buffers + 18 clock inverters |
| clock skew, setup / hold (with the 8 % setup uncertainty in the setup figure) | 113.5 / 24.3 ps |
| power at the flow's default activity (internal / switching / leakage / total) | 5.510 / 1.800 / 0.0328 / **7.340 mW** |
| max slew / cap / fanout violations | 80 / 0 / 0 |

Power in this table: OpenSTA's default switching activity (0.1 transitions per cycle on the inputs, propagated; the flow sets none); the recorded activity's figure is in the section on power below when the block has one.

## Power: the default activity and the recorded activity

OpenSTA's report_power on the final database (OpenRCX parasitics, the propagated clock) at 1,250 ps, ASAP7 SS 0.63 V / 100 C (the WC corner's NLDM and power tables), in mW.

The recorded activity: `prog_mem.json.gz` -- cocotb tile (2x2 mesh of 16x8 cores, 32 words per link flit): M1 + M18 + M19, tile (0,0), Verilator 5.020, scope `TOP.tile_mesh_cocotb.u_mesh.g_y[0].g_x[0].u_t.u_prog`, a window of 10,306 cycles at 500 ps in simulation (the activity is per cycle, applied at the period above); MAC utilization in the window 32.8 %. Of the block's 2,562 flops 66 took a recorded bit by name, 0 by the folded index (a wider unit than the one simulated: the bit of the same signal at the index modulo the recorded range), 2,496 kept the propagated default; input bits 121 / 0 / 0. Pins annotated in the database: 66 of 66, input ports 121.

| activity | group | internal | switching | leakage | total |
| --- | --- | --- | --- | --- | --- |
| default | Sequential | 3.400 | 0.257 | 0.0171 | 3.670 |
| default | Combinational | 0.988 | 0.871 | 0.0139 | 1.870 |
| default | Clock | 1.120 | 0.671 | 0.0018 | 1.790 |
| default | Total | 5.510 | 1.800 | 0.0328 | **7.340** |
| recorded | Sequential | 1.920 | 0.000 | 0.0172 | 1.940 |
| recorded | Combinational | 0.005 | 0.008 | 0.0171 | 0.030 |
| recorded | Clock | 1.120 | 0.671 | 0.0018 | 1.790 |
| recorded | Total | 3.040 | 0.679 | 0.0360 | **3.760** |

Recorded / default: 0.512 (total), dynamic 0.509.

## The worst routed paths

Setup: `raddr[0]` -> `rdata[10]_reg`, arrival 1,215.6 ps (launch clock latency included), required 1,271.7 ps, slack **56.1 ps**, 19 cells (`orfs/reports/6_finish.rpt`).

Register to register: `mem[17][62]_reg` -> `prog_ue_sticky_reg`, slack 269.2 ps.

Hold: `mem[3][3]_reg` -> `mem[3][3]_reg`, slack 104.0 ps.

The ten worst endpoints (`orfs/reports/neo/paths_max.txt`): `rdata[10]_reg` 56.1, `rdata[24]_reg` 56.6, `rdata[9]_reg` 56.7, `rdata[21]_reg` 57.8, `rdata[22]_reg` 57.8, `rdata[6]_reg` 58.9, `rdata[18]_reg` 59.3, `rdata[5]_reg` 59.4, `rdata[25]_reg` 59.8, `rdata[20]_reg` 61.7.

## Routed against synthesized

The synthesized estimate is the netlist ORFS placed (prep.py's) flat in OpenSTA with the same SDC, an ideal clock and no wires (`in/synth_sta/`); the routed figure is ORFS's final STA. A minimum period here is the period minus the worst slack of the paths named (the 8 % setup uncertainty and the setup time included on both sides). The routed netlist is not the synthesized one: the flow resizes and buffers it (timing repair in floorplan, CTS and global route), so the ratio carries both the wires and the repair.

| | synthesized | routed | routed / synthesized |
| --- | --- | --- | --- |
| setup WNS at 1,250 ps | 84.4 ps | 0.0 ps | |
| minimum period, register to register | 931.3 ps | 980.8 ps | 1.053 |
| minimum period with the I/O paths | 1,165.6 ps | 1,193.9 ps | 1.024 |

Synthesized worst path: `raddr[0]` -> `rdata[41]_reg`, arrival 1,027.7 ps, slack 84.4 ps; register to register `mem[13][62]_reg` -> `rdata[25]_reg`, slack 318.7 ps.

`synth.py`'s own figures for the units of the block (each unit with its children as extracted timing models, the synthesis job's per-unit view, 0.2 of the period on every unit's I/O):

| unit | instances in the block | cells (own) | WNS | minimum period | worst path |
| --- | --- | --- | --- | --- | --- |
| `prog_mem` | 1 | 13,880 | 84.4 ps | n/a ps | `raddr[0]` -> `rdata[41]_reg` |

The subtree's slowest unit by synth.py: `prog_mem` at 0.0 ps.

## Runtime and peak memory

| ORFS step | elapsed | peak memory |
| --- | --- | --- |
| 1_1_yosys_canonicalize | 0.0 min | 27 MB |
| 1_2_yosys | 0.0 min | 27 MB |
| 1_synth | 0.0 min | 206 MB |
| 2_1_floorplan | 0.1 min | 258 MB |
| 2_2_floorplan_macro | 0.0 min | 191 MB |
| 2_3_floorplan_tapcell | 0.0 min | 192 MB |
| 2_4_floorplan_pdn | 0.0 min | 197 MB |
| 3_1_place_gp_skip_io | 0.0 min | 215 MB |
| 3_2_place_iop | 0.0 min | 193 MB |
| 3_3_place_gp | 0.2 min | 537 MB |
| 3_4_place_resized | 0.1 min | 356 MB |
| 3_5_place_dp | 0.1 min | 273 MB |
| 4_1_cts | 0.2 min | 384 MB |
| 5_1_grt | 1.5 min | 549 MB |
| 5_2_route | 6.6 min | 2,444 MB |
| 5_3_fillcell | 0.0 min | 245 MB |
| 6_1_fill | 0.0 min | 215 MB |
| 6_report | 0.2 min | 464 MB |
| 7_neo_report | 0.1 min | 319 MB |
| 4_rsz_lec (inside its stage's step) | 0.0 min | 95 MB |
| 6_final_lec (inside its stage's step) | 0.0 min | 89 MB |
| **all steps** | **9.3 min** | **2,444 MB** |

By stage: synth (netlist read) 0.0 min, 206 MB; floorplan 0.1 min, 258 MB; place 0.5 min, 537 MB; cts 0.2 min, 384 MB; route 8.1 min, 2,444 MB; finish 0.3 min, 464 MB; neo_report 0.1 min, 319 MB.

The job's own stages (`run.json`): fakeram exit 0; prep exit 0 in 0.0 min; synth_sta exit 0; activity exit 0 in 0.1 min; synth exit 0 in 0.0 min; floorplan exit 0 in 0.2 min; place exit 0 in 0.6 min; cts exit 0 in 0.2 min; route exit 0 in 8.1 min; do-finish exit 0 in 0.3 min; neo_report exit 0 in 0.1 min.
