astracore-ai/Astracore-Neo/09_synthesis/pnr_requant.md

# pnr_requant -- `requant` placed and routed on ASAP7 through OpenROAD-flow-scripts

Generated by `07_ci/pnr/report.py` from the `pnr` job's logs (run 190 (workflow_dispatch on a3-physical at 2f2fb5b6f), started 2026-10-13 06:23:42 UTC; image `openroad/orfs:26Q4-124-g3451ca1f5`; make arguments `none`; ORFS targets `synth,floorplan,place,cts,route,do-finish`). Status: **complete**. The netlist is `synth.py`'s for the unit's subtree (requant) at 1,250 ps on ASAP7 SS (ORFS CORNER = WC, the same NLDM files), the memory leaves as FakeRAM2.0 macros; ORFS's defaults otherwise (`07_ci/pnr/designs/neo_common.mk`, the block's `config.mk`). Timing is the final stage's: OpenRCX parasitics, the propagated clock tree. ASAP7 is a predictive academic PDK: the picoseconds and square microns are the library's, the ratios and the paths the design's.

| Figure | Value |
| --- | --- |
| die / core | 150.98 x 150.98 um / 148.93 x 148.77 um (22,795.9 / 22,156.6 um2) |
| utilization (cells and macros over the core, after routing) | 57.3 % |
| standard cells: synthesized (prep.py) / after placement / after routing | 111,201 / 117,786 / 118,730 (of these 3,192 timing-repair buffers, 5,796 tie cells, 2,484 taps; 128,611 fill cells beside them) |
| macros | 0 (0.0 um2) |
| cell area: synthesized / routed | 12,207.8 / 12,699.2 um2 |
| routed wire length / vias | 289,651 um / 814,232 |
| DRC violations after detailed routing (first iteration) / antenna-violating nets / diodes | 0 (21,390) / 0 / 0 |
| global-route congestion (usage, overflow H / V / total) | 15.37 %, 0 / 0 / 0 |
| setup WNS / TNS | **0.0 ps** / 0.0 ps (0 violating endpoints) |
| hold WNS / TNS | 50.2 / 0.0 ps (0 violating endpoints) |
| minimum period, register to register / with the I/O paths | 1,073.2 / 1,073.2 ps (932 MHz) |
| clock tree: sinks, buffers (TritonCTS), buffers on a path, levels | 6,756, 446, 6-6, 5; after routing 591 clock buffers + 226 clock inverters |
| clock skew, setup / hold (with the 8 % setup uncertainty in the setup figure) | 120.3 / 35.1 ps |
| power at the flow's default activity (internal / switching / leakage / total) | 34.100 / 30.600 / 0.1320 / **64.900 mW** |
| max slew / cap / fanout violations | 20 / 0 / 0 |

Power in this table: OpenSTA's default switching activity (0.1 transitions per cycle on the inputs, propagated; the flow sets none); the recorded activity's figure is in the section on power below when the block has one.

## Power: the default activity and the recorded activity

OpenSTA's report_power on the final database (OpenRCX parasitics, the propagated clock) at 1,250 ps, ASAP7 SS 0.63 V / 100 C (the WC corner's NLDM and power tables), in mW.

The recorded activity: `requant.json.gz` -- cocotb core (16x8, NCHK = 4): C1 dense conv + C5 2:4 sparse conv, Verilator 5.020, scope `TOP.neo_core.u_rq`, a window of 2,858 cycles at 500 ps in simulation (the activity is per cycle, applied at the period above); MAC utilization in the window 56.7 %. Of the block's 6,756 flops 260 took a recorded bit by name, 6,464 by the folded index (a wider unit than the one simulated: the bit of the same signal at the index modulo the recorded range), 32 kept the propagated default; input bits 37 / 1,026 / 0. Pins annotated in the database: 6724 of 6724, input ports 1063.

| activity | group | internal | switching | leakage | total |
| --- | --- | --- | --- | --- | --- |
| default | Sequential | 9.070 | 1.740 | 0.0199 | 10.800 |
| default | Combinational | 21.700 | 27.000 | 0.1060 | 48.800 |
| default | Clock | 3.300 | 1.940 | 0.0055 | 5.250 |
| default | Total | 34.100 | 30.600 | 0.1320 | **64.900** |
| recorded | Sequential | 5.960 | 0.242 | 0.0208 | 6.220 |
| recorded | Combinational | 12.900 | 17.100 | 0.1130 | 30.000 |
| recorded | Clock | 3.300 | 1.940 | 0.0055 | 5.250 |
| recorded | Total | 22.100 | 19.200 | 0.1400 | **41.500** |

Recorded / default: 0.639 (total), dynamic 0.638.

## The worst routed paths

Setup: `rb1[267]_reg` -> `sum2[292]_reg`, arrival 1,209.3 ps (launch clock latency included), required 1,386.0 ps, slack **176.8 ps**, 16 cells (`orfs/reports/6_finish.rpt`).

Hold: `zp1[167]_reg` -> `zp2[167]_reg`, slack 50.2 ps.

The ten worst endpoints (`orfs/reports/neo/paths_max.txt`): `sum2[292]_reg` 176.8, `tbl_perr_sticky_reg` 181.8, `ra1[952]_reg` 213.0, `ra1[63]_reg` 214.5, `sum2[437]_reg` 215.3, `sum2[237]_reg` 216.3, `ra1[66]_reg` 216.9, `sum2[978]_reg` 217.0, `ra1[955]_reg` 217.9, `sum2[439]_reg` 219.7.

## Routed against synthesized

The synthesized estimate is the netlist ORFS placed (prep.py's) flat in OpenSTA with the same SDC, an ideal clock and no wires (`in/synth_sta/`); the routed figure is ORFS's final STA. A minimum period here is the period minus the worst slack of the paths named (the 8 % setup uncertainty and the setup time included on both sides). The routed netlist is not the synthesized one: the flow resizes and buffers it (timing repair in floorplan, CTS and global route), so the ratio carries both the wires and the repair.

| | synthesized | routed | routed / synthesized |
| --- | --- | --- | --- |
| setup WNS at 1,250 ps | 170.2 ps | 0.0 ps | |
| minimum period, register to register | 994.3 ps | 1,073.2 ps | 1.079 |
| minimum period with the I/O paths | 1,079.8 ps | 1,073.2 ps | 0.994 |

Synthesized worst path: `in_acc[255]` -> `ra1[375]_reg`, arrival 943.7 ps, slack 170.2 ps; register to register `ra1[261]_reg` -> `sum2[292]_reg`, slack 255.7 ps.

`synth.py`'s own figures for the units of the block (each unit with its children as extracted timing models, the synthesis job's per-unit view, 0.2 of the period on every unit's I/O):

| unit | instances in the block | cells (own) | WNS | minimum period | worst path |
| --- | --- | --- | --- | --- | --- |
| `requant` | 1 | 127,456 | 6.2 ps | 994.3 ps | `in_acc[383]` -> `ra1[571]_reg` |

The subtree's slowest unit by synth.py: `requant` at 994.3 ps; routed register to register / that = 1.079.

## Runtime and peak memory

| ORFS step | elapsed | peak memory |
| --- | --- | --- |
| 1_1_yosys_canonicalize | 0.0 min | 26 MB |
| 1_2_yosys | 0.0 min | 27 MB |
| 1_synth | 0.1 min | 412 MB |
| 2_1_floorplan | 0.7 min | 621 MB |
| 2_2_floorplan_macro | 0.0 min | 307 MB |
| 2_3_floorplan_tapcell | 0.0 min | 297 MB |
| 2_4_floorplan_pdn | 0.1 min | 325 MB |
| 3_1_place_gp_skip_io | 0.3 min | 501 MB |
| 3_2_place_iop | 0.0 min | 317 MB |
| 3_3_place_gp | 2.5 min | 1,402 MB |
| 3_4_place_resized | 1.4 min | 804 MB |
| 3_5_place_dp | 1.6 min | 912 MB |
| 4_1_cts | 1.6 min | 1,026 MB |
| 5_1_grt | 12.2 min | 1,947 MB |
| 5_2_route | 36.7 min | 11,782 MB |
| 5_3_fillcell | 0.1 min | 681 MB |
| 6_1_fill | 0.0 min | 465 MB |
| 6_report | 2.0 min | 1,609 MB |
| 7_neo_report | 1.2 min | 1,229 MB |
| 4_rsz_lec (inside its stage's step) | 0.2 min | 533 MB |
| 6_final_lec (inside its stage's step) | 0.3 min | 636 MB |
| **all steps** | **60.6 min** | **11,782 MB** |

By stage: synth (netlist read) 0.1 min, 412 MB; floorplan 0.8 min, 621 MB; place 5.9 min, 1,402 MB; cts 1.6 min, 1,026 MB; route 49.0 min, 11,782 MB; finish 2.1 min, 1,609 MB; neo_report 1.2 min, 1,229 MB.

The job's own stages (`run.json`): fakeram exit 0; prep exit 0 in 0.3 min; synth_sta exit 0; activity exit 0 in 0.1 min; synth exit 0 in 0.1 min; floorplan exit 0 in 0.9 min; place exit 0 in 5.9 min; cts exit 0 in 1.6 min; route exit 0 in 49.0 min; do-finish exit 0 in 2.1 min; neo_report exit 0 in 1.2 min.
