astracore-ai/Astracore-Neo/00_overview/spec_v2_1_summary.md

# AstraCore Neo — spec v2.1 at handoff (one page; status tags of drop 0.39, the synthesized proxy figures of drop 0.41)

Tags as in `spec_sheet_v2_1.md`: **RTL-proven** (in the RTL, tested at the stated scale), **planned** (a `ROADMAP.md` phase),
**IP** (licensed, outside the RTL by design), **model** (a model figure, not measured). The claims ledger is §0 of the spec sheet.

| Item | Value | Where it comes from | Status |
| --- | --- | --- | --- |
| Product | Gen 1: ADAS inference accelerator + ASIL-D safety island, host-attached over PCIe Gen5 x8; sold as Neo 262 / 196 / 131 bins of one die; gen 1.5 two-die package for L3; gen 2 Neo-L small die for the mandate segment | decisions 1, 9; product strategy | accelerator **RTL-proven**; island and PCIe **IP**; the bins **planned** (phase 2 tile-enable registers; fuse source IP) |
| Process, qualification | TSMC N5A; AEC-Q100 Grade 2 (Ta −40..+105 °C), Tj −40..+125 °C, 15-year profile | decision 3 | **model** (targets) |
| Compute | 64 tiles × 1,024 INT8 MACs (32×32 weight-stationary systolic + ABFT check column) = 65,536 MACs; 2.0 GHz worst-case corner; **262 TOPS dense INT8** | decision 2; model/neo_feasibility.py | MACs and mesh **RTL-proven** at 64 tiles (CI run 133); the clock **model** — its paths **synthesized, ASAP7 proxy** since drop 0.40 (the PE's product stage 1,031 ps on ASAP7 SS, five paths over the budget by design: requant, the NIC's beat CRC, the router's arbitration, the accumulator's ABFT sum, the feeder's address path; drops 0.41 / 0.42); 524 TOPS 2:4-sparse **planned** (phase 3) and INT4 / FP8 / BF16 **planned** (phase 4 / gen 2) — struck from the headline in drop 0.39 |
| Memory | 128 MB shared SRAM as 64 banks × 2 MB, one per tile on its router's local port, (39,32) SECDED per word, MBIST; per-core weight buffer with SECDED per lane and activation buffer with regions; 384-bit LPDDR5X-8533 (410 GB/s raw) with inline ECC — decision 5 still open against 256-bit | spec v2.1 (drop 0.6); decision 5 | banks, buffers, SECDED, MBIST **RTL-proven** at the silicon depths; macro areas **model**; LPDDR5X **IP**, its bridge into the banks **planned** (phase 2) |
| Interconnect | 2-D mesh of 64 tiles, 1024-bit links (128 B/cycle/direction), XY routing, flit parity, per-message end-to-end CRC with word count, fetch timeout; 2048-bit links as fallback | spec v2.1 (drops 0.6–0.12) | **RTL-proven** (the 8×8 mesh at WPF 32 in CI) |
| Tile | router + bank + network interface (fetch, serve, drain INT32/INT8, partial sums, RDY flow control) + DMA program engine (32 entries since drop 0.22) + host register interface + error-signaling module with watchdog + core | drops 0.7–0.13 | **RTL-proven** |
| Core | pipelined PE (2 stages), 2·ROWS+COLS latency, double-buffered weights with swap token, sliding-window activation feeder with duplicated control, local INT32 accumulator with ABFT at drain and a reduce port for K-split, lockstep sequencer, duplicated requantization with table parity | drops 0.3–0.12 | **RTL-proven** |
| Safety | ASIL-D systematic; island ASIL-D HW metrics; accelerator ASIL-B(D); item ASIL-D by decomposition with a diverse monitor (decision 4 open). FTTI budget: detect ≤ 10 ms, react ≤ 20 ms (item FTTI from the lead OEM). FMEDA v1: core SPFM 99.9 %, chip PMHF 62.3 FIT first-order, dominated by shared-SRAM SER pending foundry data | safety concept; safety/neo_fmeda_v1.xlsx | concept and FMEDA v1 **model** (FMEDA v2 from phase 6's fault campaign); island **IP** |
| Mechanisms proven on RTL | ABFT check column; ABFT at drain; duplicated feeder control; lockstep sequencer; duplicated requantization; weight-buffer ECC; requant table parity; link parity; end-to-end CRC; lost-flit word count; fetch timeout; bank ECC; MBIST; reduction flow control; ESM, error pin, watchdog, checker self-test | FMEDA v1 Evidence sheet (18 rows) | **RTL-proven**, every flag bin covered (53 / 53, run 133) |
| Not proven on RTL | LBIST (tool-inserted; hooks and FTTI-windowed schedule in place) | — | **IP** (DFT insertion); hooks RTL-proven |
| Workloads (perf model v3 with the RTL's endpoint rates) | YOLOv8-m 1280×736 one camera: 1.90 ms (39.6 % MAC utilization; 1.32 ms was the fabric's ceiling before the endpoint rates were calibrated); 640²: 0.99 ms; DMS 0.01 ms; BEV 6-camera 12.4 ms (first-order); ~~8B INT4 LLM decode 13 ms/token~~ struck (drop 0.39) | compiler/neo_perf_v3.py; feasibility model | **model** → phase 8 measures a layer group on the simulated mesh; the LLM figure returns with phase 4's INT4 path |
| Power (model) | ~56 W typical at 60 % utilization, Tj 105 °C; ~80 W peak; TDP SKUs 65 / 30 / 15 W; always-on island ≤ 2 W | model/neo_feasibility.py | **model**; clock / power gating and DVFS **planned** (phase 5), activity-based power (phase 7) |
| Physical (±30 %) | ~210 mm² in N5A; FCBGA ~45 × 45 mm, ~2,000 balls; unit cost ~$105–130 at volume | feasibility model | **model**; the tile **synthesized, ASAP7 proxy** (drop 0.41, run 162): 1.243 mm² = 0.225 mm² of cells (1.79 M cells, 186 k flops) + 1.018 mm² of macro model, the bank 69 % of it; every unit but the NIC at or near the array's own 1,031 ps stage on ASAP7 SS (spec §9) → stream A: the period sweep on two libraries and routed blocks |
| Compiler | lowering (conv → GEMM tiles → groups), K-split choice, LPT scheduler across the mesh, bank allocator, per-tile descriptor and DMA program emission with partial activation fetch and INT8 output; C host driver identical word for word | compiler/, sw/ | **RTL-proven** (bit-exact on the mesh: M6, M7, M18, M19); ONNX importer, quantization and runtime **planned** (phase 8) |
| Verification status | every block and the 2×2 tile mesh pass their regressions under neosim; under cocotb on Verilator in CI the 2×2 meshes of 16×8 and 32×32 cores, the 32×32 core and the 8×8 silicon mesh (run 133 all green, functional coverage 53 / 53, line / branch / toggle 97.7 / 96.3 / 97.4 %); Xcelium testbenches for the streaming core, the core and the tile mesh; assertion set and UVM skeleton | logs/, dv/, tb/, the ci-logs branches | **RTL-proven** as stated; formal proofs and the fault campaign **planned** (phase 6) |
