astracore-ai/Astracore-Neo/07_ci/synth/README.md

# `07_ci/synth` — the open-PDK synthesis job (drop 0.40; fix38: the tool install diagnosable and non-fatal; drop 0.42: the second library and the period sweep)

What the `synth` job of `regress.yml` runs: the RTL through **Yosys (slang front end) → OpenSTA** on the **ASAP7** 7.5-track
RVT library (SS corner, 0.63 V / 100 °C, 500 ps clock), unit by unit up to the silicon tile, with the memory leaves
black-boxed and priced by a macro model; then the same units on **Nangate45** (the typical corner, 1.1 V / 25 °C), the
second data point; each run ends with a **period sweep** (500 to 1,500 ps) and its verdict, the tile's period on the proxy.
Everything comes from GitHub (apt only for OpenSTA's build dependencies on the runner; the sandbox builds those from source
as well).

| File | Role |
| --- | --- |
| `tools.sh` | installs the pinned tools into `$NEO_SYNTH_TOOLS` (default `/opt/neo-synth`; the CI job sets `/home/runner/neo-synth`, no sudo): OSS CAD Suite nightly 2026-10-11 (Yosys 0.69+274 with the slang plugin, yosys-abc), OpenSTA f861c62 built from source with OpenSTA's own Ubuntu 24.04 recipe (the binary is cached as soon as it is built), the ASAP7 / Nangate45 liberty files, adder maps and the Kogge-Stone carry-lookahead map from OpenROAD-flow-scripts 3451ca1. Should OpenSTA not build, the script prints the cmake / make logs and exits 0 without `sta`: `synth.py` then synthesizes without timing, the synthesis gates run, the timing gate fails — the job is red for the right reason with the synthesis report published (`NEO_SYNTH_NO_APT=1` skips apt, `STA_CMAKE_EXTRA` adds cmake arguments: the sandbox) |
| `synth.py` | the flow (below): the units, the Yosys run per unit, the macro liberty, the repeater trees, the per-unit OpenSTA with the children as timing models, the gates, the period sweep and its verdict; `synth_results.json` |
| `abc_speed.script` | ORFS's `abc_speed.script` with the `{D}` delay target on the final mapping and sizing |
| `report.py` | `synth_report.md` (the verdict, the units, the worst paths, the sweep table, the tile's area) and the per-unit files for `ci_logs/synth/`; `--compare` the libraries side by side (`synth_report_libraries.md`) |

## Units

The design is synthesized as **units**: one Yosys run per module at its silicon parameters, every child module that is a
unit of its own black-boxed — so each module's logic is synthesized once and instantiated by name (the 32×32 array is
1,024 instances of the `mac_pe` unit and 128 of `mac_pe_chk`, not 1,152 copies through ABC) — while the small helpers
(delay lines, ECC, CRC, the checkers) flatten into their parents. The unit table is `UNITS` in `synth.py`: the tile's units
(`mac_pe`, `mac_pe_chk`, `systolic_array`, `neo_mac_core`, `act_feeder`, `acc_bank`, `neo_mac_core_v02`, `wbuf_mem`,
`requant`, `core_seq`, `neo_core`, `sram_bank`, `mbist`, `bank_bist_wrap`, `crc16_beat`, `ecc39_enc`, `ecc39_dec`,
`link_packer`, `link_unpacker`, `tile_nic`, `noc_router`, `tile_dma`, `prog_mem`, `host_if`, `esm`, `neo_tile`) and the
16×8 core's (`c16_*`, the configuration the small cocotb suites run). slang reads one module at its parameters in
seconds, where one read of the whole tile is beyond the sandbox's memory in Yosys's own front end; the black-box instances
are regrouped by their parameters after the read (`chtype` to the unit or macro name, `setparam -unset`), a memory leaf
becomes a macro cell named by its geometry (`neo_mem_sp_w624_d32768_g16`, `neo_mem_rf_w1056_d512_g1_rb1`, …), and the
**hierarchy check** of the job is that every parameterization of a child module has a unit with exactly those parameters.

Per unit: `synth -booth -noabc` with ORFS's Kogge-Stone carry-lookahead map, `extract_fa` onto the library's FA / HA cells,
the flops named after the registers they hold (`<net>_reg`, so the paths read in RTL terms), `dfflibmap`, ABC's speed
script at the period with the platform's driver and load; `stat`, `check`, the netlist and its JSON. A net with more than
32 loads gets a tree of the library's buffers in the netlist (`buffer_fanout`: the synthesis-stage stand-in for the
placer's repeaters — the per-unit synthesis cannot see the loads behind its black-box children, and the sequencer's
weight-load strobe reaches 1,059 PE inputs; clk and rst_n excepted), the netlist re-read for the stat.

## Timing

OpenSTA runs on every unit's own netlist with its **child units as extracted timing models**: each unit's run ends with
`write_timing_model` (setup / hold at the inputs, clock-to-output and input-to-output arcs, in a liberty file), and the
parent's run reads its children's models — the paths inside a child are the child's report, the paths between the units
the parent's, and a flat read of the tile's 2.5 M cells (more than 6 GB in OpenSTA) is never needed. The tile runs under
`09_synthesis/constraints.sdc` in the library's units (links at 0.4 of the period each side, host bus relaxed, the status
flags multicycle 4, `rst_n` and the coordinate straps false paths), a block under the clock and 0.2 of the period on
every input and output, a combinational block under a virtual clock; ideal clock, no wire load (synthesis-stage STA, as
ORFS's `synth` step). Since drop 0.41 the layer descriptor (`STATIC_CFG` in `synth.py`: the `cfg_*` fields of host_if's
window and `cfg_m`, written only between runs and held through the run) has multicycle 4 / hold 3, on every unit whose
inputs include it (`-from` those ports) and in the tile through the core's descriptor pins (`-through u_core/cfg_*`);
the run position `cfg_ct` / `cfg_ky` / `cfg_kx` (set by the sequencer one cycle before a run) and the requantization
tables (written by the DMA during a layer) stay single-cycle. Reported per unit: WNS / TNS, the minimum period
(`report_clock_min_period`: register-to-register paths of the clock, a child's clock-to-output and setup arcs included),
the worst ten paths with their stages
(`paths_max.txt`), the endpoint slack histogram; the macro ports carry the model's access time (218 ps ASAP7 / 435 ps
Nangate45: clock-to-Q on the registered read ports, address-to-data on the asynchronous port A of `neo_mem_rf`) and 50 ps
setup / hold. The minimum period is read from OpenSTA's fmax (its `period_min` has two decimals in the library's unit:
10 ps steps on Nangate45's ns).

**The period sweep** (drop 0.42; `--sweep default`, `make synth`'s default): after the timing runs, OpenSTA again on every
unit at each period of the library's list (500, 750, 1,000, 1,250, 1,500 ps on both libraries -- Nangate45's typical corner
is faster than ASAP7's SS, its PE 0.76 ns against 1.03 ns, so the same grid brackets it), one session per unit that reads
the netlist and the children's timing models once (they do not depend on the period) and each period's SDC in turn (the
clock, the I/O delays and the uncertainty of one period replace the previous one's: the same figures as a fresh run).
Per unit and period: WNS, TNS, violating endpoints of all, the minimum period, the worst path. The **verdict**, over the
silicon tile's units: the smallest swept period at which every unit except the PE-limited ones (`mac_pe`, `mac_pe_chk`,
`systolic_array`, `neo_mac_core` and their parents `neo_mac_core_v02`, `neo_core`, `neo_tile`) has no violating endpoint, the
PE's own stage (`mac_pe`'s minimum period), and the tile's period on the proxy, the larger of the two; the report gives it in
its first lines with the largest minimum period outside the PE-limited units (the sweep's grid is 250 ps, the minimum
periods are not).

## Area

**Cells and area** per unit from `stat -liberty`, summed through the tree (instances × unit); the macro area of the
black-boxed leaves from the macro model: ABKGroup FakeRAM2.0's 7 nm bit cell at ORFS's `asap7/fakeram.cfg` parameters
(0.042 µm² per bit) for ASAP7; for Nangate45 (drop 0.42) ORFS's FakeRAM45 macros as `tools.sh` installs them,
`fakeram45_2048x39` (0.569 µm² per bit, 0.435 ns clock to output) and `fakeram45_512x64` (0.528 µm² per bit, 0.305 ns):
the area per bit is the sum of their areas over the sum of their bits (0.557 µm²), the access time the slower one's
(0.435 ns), setup / hold 50 ps -- `derive_macro` reads them from the liberty files, the report names what it read. A leaf
is priced by the read ports it uses (drop 0.42): the registered read of `neo_mem_sp`, or of `neo_mem_rf` with its port A
tied off (the activation, weight and accumulator arrays since drop 0.41, the NIC's drain FIFO since 0.42) at 1 × the
single-port bit cell; an asynchronous read (port A: the NIC's partial-sum rows) at 1.5 ×; both read ports at 2 ×
(drop 0.40-0.41 priced every `neo_mem_rf` with RB = 1 at 2 ×, the three port-B-only arrays included). The arrays' real
figures come from a memory compiler on the target node; these keep the tile's area shares honest.

## Gates (the job fails on any)

Every unit synthesizes; no latch in the generic netlist; no multiply-driven net (`check`); the hierarchy check; the
`mac_pe` count equals ROWS × (COLS + NCHK) on the 16×8 core (192), the tile (1,152) and the chip top (73,728; NCHK = 4
throughout since drop 0.42, the chip top's since drop 0.43); at `DV_HOOKS = 0`, on the synthesized
netlists, no `dv_*` input of any unit drives logic and every `dv_*` output is a constant or a child's output — over the
whole tile tree; every OpenSTA run completes and writes its model; and (drop 0.43) the clock gates: every unit holds exactly
the `neo_icg` instances its definition declares (`U(..., icg=N)`: the core's datapath, each requantizer, the NIC's two halves,
the router's five output stages, each DMA engine, the tile's power domain), each mapped onto the library's integrated
clock-gating cell (`ICGx1_ASAP7_75t_R`, `CLKGATETST_X1`: a techmap of the black-boxed `neo_icg` after synthesis — its
behavioural latch never reaches the netlist, so the latch gate stands) and none left unmapped. The report adds per unit the
ICG cells and the clock-gated flops (the flops whose clock pin a gate drives, a child's all when the child's clk is a gated
net) with their fraction of the unit's flops. **Timing is reported, not gated**: ASAP7 is an academic
predictive 7 nm PDK without foundry data; its SS corner is slower than an N5A worst-case corner by a factor the report does
not know — the picoseconds are the library's, the *paths* and the *shares* are the design's. A path that is 3 × over 500 ps
here is a design item; one 20 % over is a question for the real library. Nangate45 (45 nm) is a second data point for the
ratios, not a 2 GHz node.

## Running it

CI: the `synth` job (`make synth`, `SYNTH_JOBS` from the runner's memory: 2 on 16 GB, 1 below 14 GB — the two largest units,
the NIC and the router, peak near 5 GB each in Yosys), then `make synth SYNTH_PDK=nangate45 SYNTH_CORNER=TT
SYNTH_OUT=synth_out_nangate45 SYNTH_LOGS=ci_logs/synth/nangate45 SYNTH_REPORT_ARGS=--lite` (the second library's report
without the timing models, which would double the published logs) and `make synth_compare`; both runs sweep. Locally,
from the flat layout: `bash synth/tools.sh && make synth`, or `python3 synth/synth.py --blocks mac_pe,requant --out
synth_out` for a subset (a unit's subtree is included; `--pdk nangate45 --corner TT`, `--period 625` for other points;
`--sweep default` or `--sweep 500,1000,1.5ns` for the sweep, none by default when synth.py is called directly; `--no-sta`,
`--sta-only` -- with `--sweep` the sweep on an existing output --, `--resume` to keep the units already synthesized in
`--out`). With `NEO_YOSYS`, `NEO_STA` and `NEO_PDK_LIB` set, `synth.py` uses those tools instead of `$NEO_SYNTH_TOOLS` (the
sandbox: Yosys from the same OSS CAD Suite tarball, OpenSTA built against a Tcl 8.6, SWIG, CUDD and Eigen built from GitHub,
since the sandbox has no apt; `--jobs 1` under 8 GB).

## The memory leaves

`01_rtl/neo_mem.sv` (drop 0.40) holds every array a memory compiler replaces: `neo_mem_sp` (one write port of G groups, a
registered read — the bank's 32,768 × 624-bit rows with a write group per lane) and `neo_mem_rf` (the same write port, an
asynchronous read port A and, with RB = 1, a registered port B — the weight buffer 512 × 702 and the activation buffer
1,024 × 512 as pairs of entries with a group per entry, and the accumulator 512 × 1,056, read on port B since drop 0.41;
the NIC's drain FIFO 512 × 1,068 (with its beats' parities), on port B since drop 0.42; the NIC's partial-sum rows 64 × 1,024,
on port A). The flow
black-boxes exactly these two module names;
`09_synthesis/memories.md` lists the instances. The behavioural arrays simulate everywhere; the testbench hooks (backdoor,
stuck-at, flip) are ports of the leaves under `DV_HOOKS`, which the silicon configuration ties off.
