astracore-ai/Astracore-Neo/00_overview/drop_log.md

# Drop log (2026-10-04 to 2026-10-20)

| Drop | What landed | Proof |
| --- | --- | --- |
| 0.1 | feasibility model; cycle-accurate systolic reference with ABFT tests; RTL v0.1 and Xcelium testbench; spec v2.0; development plan; product strategy | model T1–T5 |
| 0.2 | neosim SystemVerilog-subset simulator; RTL executed at 8×16 and 32×32; compiler lowering verified through cycle model and RTL; layer-level performance model; v0.2 requirements | T1–T3, compiler --verify |
| 0.3 | core v0.2 (double-buffered weights with swap token, activation feeder, accumulator with ABFT at drain); whole convolutions on RTL; FMEDA skeleton; safety concept draft | C1–C4 |
| 0.4 | sequencer RTL (one descriptor runs a layer); duplicated feeder control (R7); NoC router and 3×3 mesh with parity; Xcelium testbench for neo_core | C5, N1–N2 |
| 0.5 | pipelined PE (2.0 GHz contract); requantization and INT8 path; ct_free; 64-core event model; compiler group scheduling; findings R8 (K-split), R9 (banks) | C6, regress |
| 0.6 | cross-core K-split in RTL with ABFT travelling with partial sums; makespan-minimising split; bank layouts modelled; spec v2.1 memory system decided | K1–K2 |
| 0.7 | tile: bank, network interface (fetch, serve, writeback, partial sums, per-source state, end-to-end CRC), neo_tile, tile_mesh | M1–M3 |
| 0.8 | lockstep sequencer and duplicated requantization (R10); weight buffer split out; perf model v3 (dataflow across layers); affinity rejected with numbers; spec v2.1 applied | C7–C8 |
| 0.9 | DMA program engine per tile; activation regions refilled behind the core; reduction deadlock found and fixed with RDY flow control; (39,32) SECDED on banks | M4–M5, ecc39 |
| 0.10 | compiler backend emitting descriptors and programs executed as emitted; output-row range in descriptors; pipelined bank server; static compile of 83 layers; locality policies rejected | M6–M7 |
| 0.11 | host register interface; C host driver identical to the Python backend; assertion set with binds; UVM skeleton; CI; IP RFQ pack; assessor pack | host_if check, C driver check |
| 0.12 | weight-buffer ECC per lane; requant table parity; lost-flit detection and fetch timeout; ESM with watchdog and self-test registers; host_if and ESM inside the tile | C9–C10, M8–M9 |
| 0.13 | March C− MBIST integrated behind registers; INT8 drain and the first two-layer execution; backend LPT scheduler and INT8 output; FMEDA v1 with evidence; Xcelium testbench for tile_mesh | B1–B3, M10–M11 |
| 0.14 | full regression on the final RTL; this handoff package | logs/ |
| 0.15–0.19 | Verilator sign-off runs through GitHub Actions (see the engineering record): wbuf_mem/ecc39 multi-driver fix, portability fixes, program-memory SECDED and lockstep DMA, functional covergroups, cocotb mesh suite with the packed-port wrapper and bank backdoor | CI runs 1–29 |
| 0.20 | cocotb mesh suite made cycle-exact on Verilator: fetch watchdog at the RTL default (8192) for the whole suite (600 truncated every weight fetch), faults injected at the falling edge through wrapper ports (bank stuck-at, program memory, descriptor copy, DMA pc, router flit/valid, NIC serve_busy) with router observation ports, wrapper generalized to any NX×NY, diagnostics on mismatch; M10 (two-layer INT8 handoff) as the 8×8-core cocotb target; results checker fails the CI step on any failing test | CI run after fix17 |
| 0.21 | run 33 (fix17): cocotb mesh suite 11/12 + M10 on Verilator; M8's reload of the bank outran the 600-cycle watchdog window (test fixed: watchdog disabled across the reload). Silicon configuration on Verilator: `tile32` (2×2 mesh of 32×32 cores, ACC_ROWS 512, ABUF 2048, WBUF 1024, 2 MB banks) runs M1–M13, `core32` runs C1; three NIC width defects found by reading for the scaling and fixed in `tile_nic.sv` (fetch-entry staging 4 words vs 8/9 per entry at 32×32, 8-bit drain-FIFO pointers vs DFD 512, 4-bit PSUM column and drain word index vs 33 words per row). Backend: the instruction encoder now rejects a field that does not fit instead of overflowing into its neighbour; fetches are split at the 12-bit length field (Python and C driver alike, 16×8 output unchanged); `compile_network` reports what the static compile cannot emit at the silicon geometry: 588 of 23,885 YOLOv8-m tile programs exceed the 16-word program memory and 430 groups (3 layers) place a channel tile beyond the 20-bit bank address; the qualification kit checks both limits (120/122) | CI run after fix18 |
| 0.22 | run 41 (fix18): 12/12 at 16×8 (M8 fixed), C1 bit-exact on the 32×32 core with the silicon depths (`core32`); `tile32` did not build: the MBIST status register zero-extended the failing address to 16 bits, which is a negative replication at BAW = 19 (fixed: a 20-bit field at [31:12], the register map, the M11 readers in neosim and cocotb updated); `tile8` tripped on the suite's channel-count formula at 8 rows (fixed: CIN = 2.5·ROWS). DMA program memory 16 → 32 entries (decision after the drop 0.21 finding): `prog_mem` DEPTH 32, `tile_dma` pc and `host_if` PROG_ADDR 5 bits, all from `neo_tile` parameter PDEPTH; backend PROG_DEPTH and driver NEO_MAX_PROG 32; spec §6 and the datasheet updated; YOLOv8-m at the silicon geometry: 0 of 23,885 emitted programs exceed the memory (longest 24), qualification kit 122/122; neosim M11 and M12 pass on the new RTL | CI run after fix19 |
| 0.23 | run 50 (fix19): 24/26 — the silicon configuration runs: M1–M6, M9, M11–M13 bit-exact/flagged on the 2×2 mesh of 32×32 cores with 2 MB banks (M1 13,559 clocks), C1 at 32×32, 12/12 at 16×8, M10. M7 at 32×32 carried a fetch-timeout cause with a bit-exact result (two 4,095-word fetches queued at one bank exceed FETCH_TIMEOUT 8,192): the silicon configuration now uses 65,535, the timer's maximum, and the spec says how to size it; M8 at 32×32 hit the watchdog during the 1,152-clock result read-out (test: watchdog off for the read-out, re-enabled for the expiry check) | CI run after fix20 |
| 0.24 | Fetch-watchdog sizing as a hard constraint: FETCH_TIMEOUT ≥ NX·NY·(4,095 + H) met in hardware — timer width from the parameter, silicon default 2^20 − 1 (0.52 ms at 2 GHz) — rather than by a placement bound, so the compiler needs no queue accounting; spec rule written. The suite addresses tiles by coordinates (N00, N10, N01, N11) and runs on any NX×NY; M14 (bank contention: the build's maximum number of maximal fetches queued at one bank, all complete, no cause) added. `mesh8` target: the silicon mesh, 8×8 tiles of 32×32 cores with the silicon depths and 2 MB banks, mesh-level tests M1–M3, M5–M7, M9, M12–M14, in its own CI job hdl-mesh8 (ci-logs-hdl-mesh8). neosim M12/M13 pass on the new timer | CI run after fix21 |
| 0.25 | 1024-bit links (item 4): `link_pack.sv` — `link_packer`/`link_unpacker` between the tile interface and its router, WPF words per flit (32 = 1056-bit payload) with the interface unchanged at one word per cycle; wide payload {type, tag, hdr, words} with hdr[13:8] = words−1 and PSUM columns consecutive within a flit; WPF = 1 is wires, so every earlier build is bit-identical. neosim at WPF = 32: M3 (packed fetch, flipped bit caught by the CRC, parity clean) and M13 pass. tile32 and mesh8 build with WPF = 32; spec flit/payload rows and the delta table updated; new delta found: the bank port (4 B/cycle) vs the performance model's 64 B/cycle | CI run after fix22 |
| 0.26 | First coverage report (item 5): `make -C dv/cocotb coverage` rebuilds C1, the 16×8 mesh suite and M10 with Verilator line/toggle coverage and the functional covergroups on (own build directories), `coverage_report.py` merges the data into one Markdown report — line and toggle points per RTL file, the uncovered line points with their source, every covergroup with its percentage and empty bins; the hdl-sim job runs it after the suites and publishes `ci_logs/hdl-sim/coverage_report.md` with the raw data, no workflow change | CI run after fix22 |
| 0.27 | Run 64 read-out: 2×2 suites 25/26 with the 1024-bit links on tile32 (M7, M8 now pass; drain, partial sums, INT8, timeout, partitions all through the packer); first coverage report published (line 94.2 %, branch 92.5 %, toggle 92.9 % of the 16×8/8×8 builds; functional 58.5 % of bins from the mesh suite). Fixes: (1) M3 at 32 words per flit — the flip of word 0 landed after the NIC had taken it (a wide flit sits in the router register while its words are consumed one per cycle); the fault now hits the flit's last word, mask port as wide as the payload; neosim M3 at WPF 32 passes; (2) the 8×8 build: `--unroll-count 1024` (NIC reset loop over 64 sources); (3) `VCOV=1` instead of `COVERAGE=1` (cocotb reads COVERAGE as Python coverage); (4) the report merges functional coverage across builds | CI run after fix23 |
| 0.28 | The 512-bit bank, stage 1: `sram_bank` addressed by row with 16 (39,32) SECDED lanes (624-bit rows, lane write mask, all lanes decoded on read, `ce_lane`), `mbist` marching rows with every lane checked in parallel (16× fewer steps; first failing lane as a word address), `bank_bist_wrap` on row ports, `bank_word_port` giving the tile interface its one-word view unchanged until stage 2; backdoors by lane and row in the cocotb wrapper, the SV testbench and neosim. neosim: B1–B3 (64 words in 120 cycles, was 1,920), M3 at 32 words per flit, M11 (stuck lane found through the registers), M12 pass | CI run after fix24 |
| 0.29 | Run 74 (fix23 + fix24) read-out: python-regress green with the row MBIST (B1 120 cycles, B3 through the row port), tool_qual 122/122; hdl-sim 26/26 + 2 skipped (M3 at tile32 fixed, every suite on the 512-bit bank through the word adapter; coverage line 94.3 %, branch 91.9 %, toggle 92.5 %, functional 60.4 % merged); hdl-mesh8 (run 68, fix23) still stopped in the Verilator build — `%Error-BLKLOOPINIT` at the NIC's reset loop over NX·NY sources with `--unroll-count 1024` in place, so the raised limit was not the fix. The 512-bit bank, stage 2: `tile_nic` on the bank's row port — serves reads at 16 words per cycle (pipelined row reads, a partial first beat from the request's lane, full rows, a partial last beat; a 4,095-word serve is 257 beats), writes WRDATA beats as masked rows (two rows in two cycles when a beat crosses a row boundary), the receive CRC over a whole beat per cycle (`crc16_beat`, 16 chained word stages; count still per word), fetch-response and PSUM beats consumed one word per cycle inside the interface — fetch bandwidth is unchanged until stage 3 — `bank_word_port` removed; each source's receive state in its own generate block, so no procedural loop scales with the mesh (the mesh8 build error goes with it). `link_pack.sv` re-blocks between 16-word beats and WPF-word flits: WPF = 32 merges beats (a 32-word flit every second cycle; flits of 17–31 words after a partial first beat), WPF = 1 splits beats into the same single-word flits as before, so the 16×8 builds see the same flits but are no longer cycle-identical. A zero-length request is answered by its CRC flit alone (the requester completes it as a no-op); the dead-server fault of M9b now holds the server's transmit engine in X_SERVE_RD (wrapper fi_sel 7 and neosim alike) instead of `serve_busy`; `neo_backend.ins()` and the C driver's `emit()` refuse a zero-length fetch, tool_qual TQ5 added (123/123). New `sim/run_nic.py` (I1–I7: writeback of 200 words in 1..16-word beats from lane 3 with row crossings, serve of 77 words from lane 5 in beats 11/16/16/16/16/2 with the CRC vs a model, serve under back-pressure, packer→unpacker round trips at 32 and 1 words per flit, the zero-length answer, the dead-server hold), in `regress_ci`. neosim: I1–I7, M3 at 32 and at 1 word per flit, M9 (both halves), M11, M12, M13 pass; M1 at 1 word per flit not completed under neosim in the packaging window (M3 at 1 word per flit and I5 cover the split path; the tile suite in CI covers M1); M1 and M7 at 32 words per flit not completed under neosim in the packaging window (covered by the tile32 suite in CI) | CI run 85 (fix25): python-regress green (I1–I7 on the runner, C driver, tool_qual 123/123); **hdl-sim 26 passed / 0 failed / 2 skipped** (commit 87f2f5c) — the full 16×8 suite through the split packer and masked-row writeback, M10 at 8×8, the tile32 suite at 32 words per flit on the 512-bit bank (M1 14.8 s, M7 18.5 s, M9 43.1 s, M13 38.1 s wall), C1 at 32×32. 16×8 cycle counts **unchanged** from run 74 (M1 3,839, M2 3,343, M4 3,675, M6 3,343, M10 797 clocks): with one word per flit the builds turned out cycle-identical after all, the row-ahead serve and the row writeback hide behind the one-word link; tile32 counts down 3–5 % (M1 14,053 → 13,572, M2 13,865 → 13,142, M4 13,705 → 13,262, M6 13,865 → 13,142). Coverage: branch 92.7 %, line 95.0 %, toggle 92.0 % (was 91.9 / 94.3 / 92.5); tile_nic 91.7 / 96.1 / 96.1, link_pack 100 / 100 / 94.1, crc16_beat toggle 100 %; the two uncovered points of tile_nic are the resume of an open drain message after the FIFO ran empty (`if (drain_open)`) and the state-machine default; functional 60.4 % merged, unchanged. hdl-mesh8 never published (branch still at run 75, no commit after a4ca312, so not even the timeout publish ran); drop 0.30 adds `--build-jobs 4` and the workflow fix for the job is prepared |
| 0.30 | The 512-bit bank, stage 3: fetch receive at entry rate — each cycle one activation entry (WPA words) or weight entry (WPW words) is assembled from the words staged from earlier beats plus the current 16-word beat and written to its buffer, so a beat is taken in ceil(words / WPE) cycles (two at 32×32: 8 words per cycle for activations, 9 for weights; four and five at 16×8), leftovers staged for the next beat, entry address = base + entries written (the per-word division and modulo are gone), CRC over the whole beat; a response with no fetch outstanding is consumed one cycle per beat and stored nowhere; PSUM rows still one word per cycle. **Performance model re-run with the RTL's endpoint rates (`neo_perf_v2.Fabric` takes `--rx/--tx/--psum`, bytes per cycle at the receiving/sending tile; a transfer takes max(bytes/link, bytes/endpoint) cycles): the section-9 figures of 1.32 ms (1280×736) and 0.66 ms (640²) are superseded — they assumed every endpoint absorbs a full 128 B/cycle link. With the RTL as it is after this drop (rx 32, tx 4, psum 4 B/cycle, 2 GHz clock) the frame is 11.1 ms at 1280×736 (6.7 % MAC utilization) and 7.2 ms at 640² (4.5 %); the serial partial-sum receive alone accounts for 6.7 ms of the 640² figure, the entry-rate fetch alone takes it to 1.48 ms, the one-word-per-beat drain alone to 0.70 ms; with PSUM and drain at beat rate (64 B/cycle) 2.9 ms / 1.56 ms (the 1.8 ms first quoted for 640² was with the partial sums at 32 B/cycle). Next-drop order, by model impact: PSUM rows into the reduce port at beat rate, the drain in 16-word beats, then a second entry per cycle on the fetch; then the model again.** Fetch-timeout rule restated: FETCH_TIMEOUT ≥ NX·NY·(4,095 / R + H), R the per-flow rate in words per cycle (1 up to drop 0.29, 8 / 9 at 32×32 now: a maximal fetch in ~512 + H cycles, 64 queued in ~33,000 + 64·H); constants kept (2^20 − 1 silicon, a 16× margin; 65,535 / 8,192 on the sim builds). `--build-jobs 4` on the mesh8 build. `run_nic.py` I8–I10 (entry assembly from beats of random sizes at 16×8 and 32×32 with check values and cycles per beat; a response with no fetch outstanding). neosim: I1–I10 pass; M3, M11, M12, M13 pass at 32 and at 1 word per flit; M9 passes at 32 words per flit, M9 passes at 1 word per flit too (dropped flit flagged, dead server timed out) | CI run 90 (fix26): python-regress green (I1–I10 on the runner); **hdl-sim 26 passed / 0 failed / 2 skipped** (commit 1b29d48) — stage 3 verified. tile32 (32×32, 32 words per flit) cycle counts down 55–57 %: M1 13,572 → 5,904, M2 13,142 → 5,811, M4 13,262 → 5,846, M6 13,142 → 5,811 clocks (M1 wall 10.6 s, M7 10.6 s, M9 43.7 s, M13 38.8 s); 16×8 counts unchanged (one word per flit, one word per beat). Coverage branch 92.8 %, line 94.7 %, toggle 91.9 %; tile_nic 92.2 / 94.4 / 95.2 (the uncovered line is the stay-on-the-beat case `fx_more`, which no 2×2 test reaches with one-word beats; tile32 is not in the coverage build); functional 60.4 % merged. hdl-mesh8: run 86 (an intermediate commit, cancelled during setup) published its 'finished' line, so publishes do run on a cancel; run 90's job had not reported when drop 0.31 was packaged |
| 0.31 | **The drain in 16-word beats and partial sums at beat rate** (the two items the corrected model ranked first): the drain transmits beats of up to 16 words from the FIFO row (an INT32 row of COLS + 1 words as 16 + 16 + 1 at 32×32, an INT8 row as one beat; PSUM beats carry the row index as tag and the column of word 0; the CRC over the beat); an owner takes a PSUM beat whole — up to 16 columns per cycle into the row under assembly, the row handed to the reduce port in the cycle its check word arrives, that beat held only while the two-entry FIFO is full; the one-word serial receive path (rx_widx) is gone, every data type is now a beat. Model defaults `--tx 64 --psum 64`: **2.89 ms at 1280×736 (26.0 % MAC utilization), 1.56 ms at 640² (20.9 %)** at 2 GHz, from 11.1 / 7.2 ms after drop 0.30; the entry-rate fetch is what remains between that and the 1.31 / 0.65 ms of the old assumption, so a second entry per cycle on the fetch is the next item; fetch-timeout constants unchanged. `run_nic.py` I11 (PSUM rows in beats of random column counts with the FIFO-full stall on the check-word beat, 16×8 and 32×32), I12 (INT32, INT8 and PSUM drains as beats with tags, columns, WRHDR and CRC vs the model). CI housekeeping for the mesh8 job (prepared with drop 0.30's read-out): `cocotb_mesh8_build` / `cocotb_mesh8_run` halves, `--build-jobs 4`, and `regress.yml` with heartbeat publishes at start and after the build, the job's own concurrency group and a 300-minute limit. neosim: I1–I12 pass; mesh tests (words per flit) pass: M2 at 32, M3 at 32, M3 at 1, M9 at 32, M9 at 1, M11 at 32, M11 at 1, M12 at 32, M12 at 1, M13 at 32, M13 at 1; M2 at 1 not completed (cut off by the sandbox reset; covered by the tile suite in CI) | CI run 96 (fix27): python-regress green (I1–I12 on the runner); **hdl-sim 26 passed / 0 failed / 2 skipped** (commit 160f5c0, published 12:55 UTC). tile32 counts: M2 (K-split, the partial-sum path) 5,811 → 2,591 clocks (−55 %), M6 5,811 → 2,602, M1 5,904 → 4,878, M4 5,846 → 4,820; wall M1 8.2 s, M7 8.6 s, M9 35.3 s, M13 31.6 s (was 10.6 / 10.6 / 43.7 / 38.8); M10 at 8×8 797 clocks and the 16×8 counts unchanged (one word per flit = one word per beat). Coverage branch 92.5 %, line 94.7 %, toggle 91.8 %; tile_nic 90.9 / 94.7 / 95.1 (uncovered: `fx_more`, the resume of an open drain, the state default — the 32×32 paths, which `tile32_cov` measures from drop 0.32); link_pack 100 / 100 / 94.1; functional 60.4 % merged. hdl-mesh8 could not report a heartbeat: the pasted workflow had not been committed (the repository still runs the old job) |
| 0.32 | **Two entries per cycle on the fetch**: `act_feeder` and `wbuf_mem` organised in pairs of entries with one word-wide write port (`we` the entry at the address, `we2` the upper entry of the same pair at an even address; `wbuf_mem` with a second set of SECDED encoders) — one port, double width, not a second port; the interface assembles up to two entries per cycle from the staged words plus the beat and writes a pair at an even address or a single entry at an odd one (the first entry of a fetch at an odd base, the odd trailing entry), so a 16-word beat of two 8-word activation entries is taken in one cycle at 32×32 and the fetch moves at the 16-word beat like every other endpoint. Model `--rx 64` (every endpoint at the beat): **1.90 ms at 1280×736 (39.6 % MAC utilization), 0.99 ms at 640² (32.9 %)** at 2 GHz, from 2.89 / 1.56 ms; the gap to the superseded 1.31 / 0.65 ms is the per-flow ceiling of the 16-word beat against the 128 B/cycle link — the bank-port item is closed in the delta table. `tile32_cov` joins the coverage build (M1, M2, M3, M7, M9, M13 at 32×32 / 32 words per flit) so the beat paths are measured. mesh8 fallbacks prepared: `MESH8_BUILD_JOBS` / `MESH8_CFLAGS` knobs (`-O1`, two jobs one line away) and `mesh8s`, the 8×8 mesh on 16×8 cores with the silicon depths (mesh-level tests only). `run_nic.py` I8/I9 with pairs and odd bases, I8b/I9b rate tests (every 16-word beat of two activation entries taken in one cycle at 32×32, 8 pair writes for 16 entries). neosim: I1–I12 pass; C9 passes; mesh tests (words per flit) pass: M1 at 32, M3 at 32, M3 at 1, M9 at 32, M9 at 1, M11 at 32, M11 at 1, M12 at 32, M12 at 1, M13 at 32, M13 at 1; M1 at 1 not completed (cut off by the sandbox reset; covered by the tile suite in CI); the fault helpers of both harnesses now act on the first response flit (the old `n > 40` guard found nothing once a 16×8 response is consumed before cycle 40) | CI run 104 (fix28, workflow fe30449): python-regress green (I1–I12 with the pair writes); **hdl-sim 26 passed / 0 failed / 2 skipped** (commit fea999d, 17:52 UTC) — M3 and M9 at 16×8 pass on the guard-free fault helpers; tile32: M1 4,878 → 4,608 clocks, M2 2,591 → 2,365, M4 4,820 → 4,568, M6 2,602 → 2,376 (the pair writes take 6–9 % more off; the fetch is no longer the dominant phase), wall M1 6.9 s, M7 7.1 s, M9 30.6 s, M13 27.0 s; 16×8 counts unchanged. **First coverage with the tile32 build**: branch 93.4 %, line 95.3 %, toggle 92.8 % (was 92.5 / 94.7 / 91.8); tile_nic 93.2 / 96.5 / 98.8 — the stay-on-the-beat line is now covered, only the resume of an open drain and the state default remain; link_pack 100 / 100 / 100; wbuf_mem toggle 75.0 % (the pair port's upper lane pairs up rarely for 9-word weight entries); act_feeder 95.5 / 100 / 94.4. The merged functional figure fell to 49.1 % because tile32_cov overwrote tile_cov's funcov_tile_mesh.yml with its six-test subset — fixed in drop 0.33 (one export file per build). hdl-mesh8: the 'started' heartbeat published at 16:27:49 UTC; no 'built' heartbeat by 18:15 (1 h 48 min into the build on 4 jobs at -O2) |
| 0.33 | **The bank allocator in 16-word units** (`neo_alloc.py`, `neo_backend.py`): every bank (2 MB, 524,288 words) managed in bank rows of 16 words with a first-fit free list; activations placed per channel tile in bands of consecutive rows, each band one contiguous region of one bank, band boundaries aligned to the producing layer's output-row chunks so a group's output is one DRAIN_WR and a consuming window one FETCH_A per band it overlaps; weights resident per output tile round the banks; a layer's input released once compiled, its output the next layer's input when the shapes meet (else placed afresh: the image and the concat/skip inputs the chain model does not carry); owners by LPT with the band's own bank breaking ties; a tile-exclusion mask (`--exclude`) that takes tiles out of the owner pool and their banks out of the allocator. YOLOv8-m 640² on 8×8: **6,263 groups, every one placed** (430 could not be emitted before), 24,549 programs, longest 24 words, at most 12 FETCH_A per program, the image's 12.5 MB in 7 banks, weights 36.5 MB resident, peak occupancy 99.6 % of one bank, 36.7 MB in use at the end; with (3,3) — or (0,0), (3,3), (7,7) — excluded every group still places. `make backend_check` (`neo_backend.py --check`) in `regress_ci` and `regress`; tool_qual TQ6 (7 cases: band coverage, chunk alignment, release/reuse, the mask on banks and on the mesh compile, the whole network, the network with a tile excluded) → 130/130; the report lists per-layer bands/banks/MB and the per-bank peak map. `run_tiles.py` M6's stale descriptor poke (`mesh.cfg`) replaced by `set_cfg`. Fetch-timeout constants unchanged. neosim: M6 (the compiler-emitted program on the 2×2 mesh, owner + two contributors) bit-exact in 1,191 clocks; `--check` ALL PLACED, `--verify` ALL PASS, tool_qual 130/130 | CI run 111 (fix29 + fix29a + fix29b, workflow 251e669): **python-regress green** — `neo_backend.py --check` ALL PLACED (peak occupancy 99.6 % of bank (0,0), weights 36.5 MB resident, 36.7 MB in use at the end), tool_qual 130/130, C driver vs backend ALL PASS; **hdl-sim 26 passed / 0 failed / 2 skipped** (commit dfda03e, 05:57 UTC; 84 min) — tile32 M1 4,608 / M2 2,365 / M4 4,568 / M6 2,376 clocks, 16×8 M1 3,839 / M2 3,343 / M4 3,675 / M6 3,343, M9 30.5 s and M13 26.9 s at tile32, as run 104 (no RTL change in 0.33); coverage branch 93.4 / line 95.3 / toggle 92.8 % unchanged, and with the two functional exports (`funcov_tile_mesh.yml`, `funcov_tile_mesh32.yml`) the merged functional figure is **60.4 % (32 of 53 bins)**, back from run 104's 49.1 %; the job itself is red on the Actions page — "Process completed with exit code 2" from `make lint`: the strict `-Wall` pass on tile_mesh exits nonzero on its 102 warnings, made informational in drop 0.34; **hdl-mesh8 ended 3 min 51 s after it started with exit code 143** — the runner was shut down during the verilation, see drop 0.34 |
| 0.34 | **The mesh job measured and sized to the runner** (CI only; no RTL change). Finding: run 111's hdl-mesh8 job ended 3 min 51 s after it started with exit code 143 (SIGTERM to the step: the hosted runner itself was shut down), with only the 'started' heartbeat on the log branch — i.e. during the verilation of the 64-tile model of 32×32 cores, long before any C++ compile, so the drop-0.33 build knobs (2 jobs, -O1) never came into play; the runner is 4 cores, 16 GB, 145 GB disk (86 GB free — disk was never the constraint), and every mesh8 attempt since drop 0.24 (runs 74, 85, 90, 96, 104) left the same single line, so the same early death is the consistent reading of all of them (run 104's '1 h 48 min into the build' was an assumption; its run lasted 1 h 27 min in total). Changes: the hdl-mesh8 job builds `MESH8_VARIANT=mesh8s` by default — the 8×8 mesh on 16×8 cores with the silicon depths and links, the mesh-level tests (the 32×32 core and depths stay proven on tile32 in hdl-sim; the 32×32 mesh is `MESH8_VARIANT: mesh8` once it has somewhere to fit); GNU time around every cocotb build in both HDL jobs (`build_stats.txt`: wall time, peak resident set, exit status — the hdl-sim numbers for tile32 size the 64-tile builds); a memory sampler (one line every 20 s: memory used / available, swap, build-directory size, largest process) whose log is pushed to the branch every two minutes while the build runs, all publishes through one lock, so a runner that dies leaves its memory trajectory behind; the 16×8 suite built and run with and without `--public-flat-rw` first (`make tile_np`, `PUBLIC_ARGS` knob: the tests touch only the wrapper's ports, so the flag is a legacy of the pre-wrapper tests and a candidate for the memory the 64-tile build needs); with `MESH8_PROBE 1` (the default for this one run) a 30-minute bounded attempt at the 32×32 mesh after the variant's results are published, expected to end the job the way run 111 ended but with the trajectory on the branch. Lint: the fourth `make lint` pass — `-Wall` on the whole tile mesh with nothing waived — exits nonzero on any warning and had 102 in run 111 (50 WIDTHEXPAND, 19 WIDTHTRUNC, 24 UNUSEDSIGNAL, 5 UNUSEDPARAM, 2 UNSIGNED, 2 DECLFILENAME; 45 in `tile_nic.sv`, the beat-path arithmetic of drops 0.29–0.32), so the hdl-sim job's lint step, and the job, were red on every run while the simulations passed; the pass is informational now (prints every warning and a count), the three waived passes remain the gate, and clearing the width warnings is backlog for a session with Verilator at hand. Spec section 10: the core-geometry delta row states what is simulated at which size and what closes the 64-tile build (hierarchical verilation or a larger machine — the Xcelium runs at the Cadence team — not build knobs). Fetch-timeout constants unchanged | CI run 115 (fix30, workflow 21076e4): python-regress green; **hdl-sim 26 passed / 0 failed / 2 skipped** (commit da55e61, 08:18 UTC, 101 min; the strict pass informational at 102); its first `build_stats.txt`: `tile` 140 s / 890,756 KB, `tile8` 74 s / 865 MB, `tile32` 1,620 s / 1,890,288 KB (1.9 GB — times 16 tiles is the flat 64-tile model's need, 30 GB), `core32` 1,047 s / 1.4 GB, **`coverage` 2,398 s / 15,573,220 KB — 15.6 GB of the runner's 16, the toggle instrumentation of the flat 2×2 of 32×32 cores: the next build that cannot grow** (a candidate for the hierarchical build, or line coverage only on tile32_cov); the tile / tile_np A/B measured two identical builds — 138.47 s / 890,656 KB with the flag and 136.88 s / 890,648 KB 'without' — because cocotb's own Makefile.verilator passes `--vpi --public-flat-rw` on every build (the knob only removed a duplicate); **the mesh8s verilation peaked at 14,026 MB of the runner's 15,989** (verilator_bin, 06:41:32–06:44:40 UTC, 1 GB to spare) and wrote 791 MB of C++, which then compiled one file at a time (`make -f Vtop.mk` inherits no -j from `--build-jobs`); the mem.txt trajectory is the measurement drop 0.34 asked for: the flat model's cost is per tile instance, and the 32×32 mesh (its tile several times larger) has no place in 16 GB flat — see drop 0.35 for what fits |
| 0.35 | **The 64-tile mesh built hierarchically, and the RTL lint-clean.** The finding behind every dead mesh8 job: Verilator flattens the design per instance (V3Scope clones every block for every cell), so 64 tiles cost 64× one tile whatever the flags or parameters — measured with Verilator 5.020 in the sandbox, the 2×2 16×8 build takes 869 MB (CI: 870), the 4×4 silicon-depth build 3.4 GB with and without coordinates-as-ports alike, the 8×8 one dies past 6 GB; `--public-flat-rw` has no share (cocotb adds it itself). The one mechanism that shares a tile across instances is **hierarchical verilation**: `neo_tile` carries `/*verilator hier_block*/` and the mesh builds pass `--hierarchical` (`HIER_ARGS`, `MESH8_HIER` knobs), so the tile is verilated once as a library and instantiated NX·NY times. Its two conditions became RTL: (1) **the tile's mesh coordinates are ports** (`my_x`, `my_y`, strapped by `tile_mesh` / `noc_mesh` from the generate indices; `MY_X` / `MY_Y` parameters gone from `neo_tile`, `tile_nic`, `noc_router`, `neo_tile_axil`) — every tile is the same module, which is also how the silicon mesh will be built (one hard macro, coordinate straps); (2) **no hierarchical reference into the tile**: the cocotb wrapper's bank backdoor, fault injection (bank word OR, program memory XOR, cfg XOR, DMA pc XOR, router out_flit XOR / out_valid cleared, dead server) and router observation are now `dv_*` ports of `tile_mesh` and `neo_tile`, implemented inside `sram_bank`, `prog_mem`, `host_if`, `tile_dma`, `noc_router`, `tile_nic` under a `DV_HOOKS` parameter (1 on the testbench builds; 0, the default, leaves the silicon tile without them, ports tied off) with the wrapper's exact semantics (backdoor write at the rising edge, faults at the falling edge, reads combinational); the tile's link ports are packed vectors (unpacked arrays on a hierarchical block's boundary break Verilator 5.020's change detection once the block has 64 instances). Measured hierarchically in the sandbox (Verilator 5.020, 2 cores, 8 GB): **mesh8 — the silicon mesh, 8×8 of 32×32 cores — verilates in 36 s with 756 MB peak and 105 MB of C++** (flat: never, in 16 GB); mesh8s in 21 s / 438 MB (flat: 195 s / 14,026 MB); the 2×2 tile build 233 MB (flat 869). The hdl-mesh8 job builds `MESH8_VARIANT: mesh8` again, with `MESH8_BUILD_JOBS` reaching the C++ compile (`make -j`; the hdl-sim suites too), the probe off, the A/B step gone. **Lint:** the 102 strict-pass warnings cleared in the RTL — explicit widths on the beat-path arithmetic of `tile_nic` (`AVW`, `SRCW` source index, `CIW` column index, `LW`-wide beat indices, `FTW'`/`DFW'`/`IDXW'` compares), the router's arbitration in 3-bit arithmetic, `link_pack` chunk indices, `core_seq`'s load address at the buffer's width (`WW`/`WCW` parameters gone), `mbist`'s index width `IW`, requant's zero point at the product width, truncation casts on the request's coordinate and address fields (`tile_nic`, `tile_dma`, `host_if`), `unused_*` sinks for what a module deliberately does not read (Verilator's `--unused-regexp` default), `DECLFILENAME` waived in the two files that hold two modules by design, dead parameters (`DW` of neo_tile/tile_mesh, `IDXW` of tile_mesh, `AW` now used, `PE_LAT` localparam) removed — and `make lint` is four `-Wall` passes with nothing waived, every warning failing the step. neosim parses `always_ff @(negedge clk)` (the hooks) and runs it as the falling edge inside `tick()`. Fetch-timeout constants unchanged. **Verified in the sandbox with CI's tools** (Verilator 5.020 and cocotb 1.9.2 built from source): the cocotb 16×8 suite on the new RTL, flat and hierarchical builds, **12 passed / 0 failed / 1 skipped with the same 31317.01 ns of simulated time as run 115** (M1 3,839, M2 3,343 clocks); `make lint` 0 warnings; neosim `make regress_ci` (T1–T3 at two geometries, compiler --verify and ALL PLACED, N1–N2, Q1–Q3, B1–B3, I1–I12, the C driver) and M3 pass; **the silicon mesh simulated for the first time** — the hierarchical `mesh8` build in the sandbox (64 tiles of 32×32 cores, silicon depths, 1024-bit links): **10 of 10** (M1–M3, M5–M7, M9, M12–M14) in 92 min of CPU for 226,675 clocks: M1 bit-exact in 4,608 clocks, M2 2,365, M6 2,376 (tile32's counts: neighbouring tiles), M9's starved request timed out after 65,539 clocks and completed, M13's cross-partition fetch dropped and timed out, **M14 — the fetch-timeout rule at NX·NY = 64 (§5 item 4): 14 maximal fetches of 4,088 words queued at one bank, first done at 292 clocks, last at 3,697, 0.065 clocks per word (15.4 words per clock aggregate: the server at the beat with a per-request overhead H of about 9 cycles, not the 400 budgeted), no cause** — against FETCH_TIMEOUT 65,535 a 17.7× margin, and the rule NX·NY·(4,095 / R + H) evaluates to about 17,000 cycles at 64 tiles (65,535 on the simulation builds and 2^20 − 1 in silicon stand); the SV testbenches of the `verilator` step pass flat on the new RTL (T1–T3, C1, M1 in 3,802 clocks as run 111) | the next run: hdl-sim's lint step green on the full gate and 26/26 + 2 unchanged; hdl-mesh8's `mesh8 build:` stats line (expect well under 1 GB and minutes, not hours), then `mesh8.txt` with M1–M3, M5–M7, M9, M12–M14 at 8×8 of 32×32 cores — the first results of the silicon mesh — and M14's clocks per queued word against FETCH_TIMEOUT 65,535. **Run 126 (8 Oct, fix31 + fix32 on main):** hdl-mesh8 failed 9 s into the build — the first hierarchical verilation in CI relaunches the `verilator` wrapper for the tile block from the generated `Vtop_hier.mk`, and Ubuntu's packaged Verilator has no `verilator_bin` under its compiled-in root (`exec: /usr/share/verilator/verilator_bin: not found`, exit 2 after 5 s; the block was never verilated, the model never built). Drop 0.37 has the mechanism and the fix; the sandbox's figures above stand |
| 0.36 | **The coverage holes closed** — from the test side, plus one hook. Mesh suite: M15 register read-back (PROG_ADDR, PROG_LO, ERR_MASK, PARTITION, cfg_m, the 20-register descriptor window, STATUS / MBIST idle, an unmapped address reads zero — the six `host_if` read-back lines no test reached), M16 link parity (a flit corrupted in (0,1)'s router output register toward (0,0) is dropped at the parity check and flagged there; lost + crc at the CRC flit; the fetch completes), M17 double-bit bank error (ecc_ue on the serving tile, no ecc_ce, the run completes), M18 descriptor sweep ((k, s, ct_n) = (1,1,4), (1,2,1), (3,2,2), (5,1,1), (5,2,1), each bit-exact; weights fetched in entry-aligned chunks of at most 4,095 words), M19 INT8 drain (tables through the registers, packed rows against the requantization model, on 16×8 and 32×32; M4 and M19 join `TILE32_COV_TESTS`, M16 joins `MESH8_TESTS`); M6 / M7 sample the compiler-emitted descriptors (the partial-rows bin was exercised and never recorded), M8 samples the ABFT flag its self-test raises, the functional export is written by the last test of the file as well as by M13. Core suite: C1 as a helper with a loaded requantization table; C2 — the core's own fault hooks, one run each (`ctrl_fault_inject`, `seq_fault_inject` with the ABFT silent, `rq_fault_inject`, `rq_tbl_fault_inject`), each raising exactly its flag, every run finishing — the `ctrl`, `seq`, `rq`, `tbl_perr` bins the mesh suite cannot reach (the tile ties the hooks off) and `neo_core.sv`'s sticky-flag branches; C3 — the weight buffer's SECDED through a `DV_HOOKS` hook of `wbuf_mem` (`dv_fi_flip` / `addr` / `lane` / `mask`: a stored codeword's lane XOR a mask at the falling edge, the drop-0.35 pattern; `neo_core` carries the ports, `DV_HOOKS=1` on the core-level build only, the tile and the SV testbench tie them off): a data bit and a check bit flipped are corrected on read with the result bit-exact and `wbuf_ce`, a double-bit lane error is flagged `wbuf_ue` and the run completes — the last two flag bins. Spec section 12 lists the cocotb suites | sandbox (Verilator 5.020, cocotb 1.9.2): `tile` **18 tests, 17 passed, 1 skipped** (M1–M13 at their known counts; M18 k=1/s=1/4 tiles 1,539 clocks, k=1/s=2 393, k=5/s=1 3,255, k=5/s=2 2,985; M19 3,589; M16 165; M17 3,839); `core` C1 1,696 cycles bit-exact, C2 four hooks flagged, nothing else raised, C3 `wbuf_ce` with the result bit-exact and `wbuf_ue` on the double flip; `make lint` 0 warnings with the hook; `core_cov` + `tile_cov` + `tile8_cov` + report (before C3): **functional coverage merged 96.2 % (51 of 53 bins)** from 60.4 % — ct_n, k, k×s, partial rows, role, stride, DMA op and drain mode all 100 %, flags 17 / 19, and with C3's two bins every bin of the model is reachable (53 / 53 in the next CI report); `host_if.sv` line 100 % (from 77.8 %), `neo_core.sv` branch 100 % (from 50 %); line / branch / toggle 96.5 / 94.4 / 93.5 % over the three builds (tile32_cov, 15.6 GB, runs in CI only). **Runs 126 and 129 (8 Oct), hdl-sim:** the lint gate clean on the full `-Wall` set; `coverage_report.md` over the four coverage builds **functional coverage 53 of 53 bins, 100 %** (every descriptor, DMA-op, drain-mode and flag bin), line / branch / toggle 97.7 / 96.3 / 97.4 % over the RTL, `host_if.sv` 100 % line, `neo_core.sv` 100 % branch; the uncovered lines are five `default:` arms, the drain's `if (drain_open)` resume and the requantizer's negative saturation; tile 17 passed + M14 skipped at 46,282.52 ns, tile8 M10, the coverage builds 3 + 17 + 1 + 8 all passed, the SV testbenches all pass; builds tile 889 MB / 74 s, tile32 2.19 GB / 26 min, core32 1.50 GB / 14 min, coverage 15.5 GB / 39 min (4 jobs). **Two failures, both on the 32×32 builds and both fixed in drop 0.38:** M16 on tile32 (the corrupted flit raised no parity error: the hook's falling-edge write did not reach the neighbouring tile in time in the flat build) and C2's requantization fault on core32 (every column-0 output of the 32×32 run saturated at the test's table, so the input fault was invisible to the output comparator) |
| 0.37 | **The hierarchical build on a packaged Verilator** (CI tooling and the cocotb wrapper; no RTL change). Run 126 (fix31 + fix32 on main) read: hdl-mesh8 died 9 s into the first hierarchical build in CI — `--hierarchical` verilates each block in a child run, relaunching the `verilator` wrapper from the generated `Vtop_hier.mk`, and by then `VERILATOR_ROOT` is in the environment (the top-level `verilator_bin`, started without it, exports its compiled-in default), so the wrapper takes `verilator_bin` from `$VERILATOR_ROOT/bin` — which Ubuntu's package does not have: it installs `verilator_bin` in `/usr/bin` and `include/` with `verilator_includer` under `/usr/share/verilator`, the compiled-in root (`exec: /usr/share/verilator/verilator_bin: not found`, exit 127 in the block's make, exit 2 after 5 s; the block was never verilated). A flat build never relaunches, which is why 100 runs never met it, and a one-tree Verilator (the sandbox's) does not split, which is why the sandbox never did. Fix: `dv/cocotb/vroot.sh` prints a root that holds the programs and the include tree alike — the environment's when complete, else the compiled-in root when complete, else a directory of symbolic links next to the script (`sim_build_vroot`: `bin/` with every verilator program from both places, `include/`) — and the Makefile exports it as `VERILATOR_ROOT` for every build whose arguments carry `--hierarchical` (the mesh targets); flat builds never consult it. The wrapper's twelve per-tile sticky-flag ports, unconnected since the wrapper exists (twelve PINMISSING warnings on every tile build), are packed into a `flags` output (bits [n·12 +: 12] of tile n in the cause register's order from bit 2); the build logs are warning-free | sandbox, with Verilator 5.020 installed the way Ubuntu installs it (`bin/` and `share/verilator/` apart, `VERILATOR_ROOT` unset): a two-instance hier design fails with run 126's message and verilates, compiles and runs through the root; `make -C dv/cocotb tile HIER_ARGS=--hierarchical` **18 tests, 17 passed, 1 skipped (M14)** at 46,282.52 ns, the same simulated time as every flat and hierarchical run of the suite, 0 warnings; **`make cocotb_mesh8_build` — CI's command — builds the silicon mesh through the root: block and top verilated in about 40 s, compiled in 40 min on 2 cores** (one fast-path file of the block, 25 min and 1.6 GB alone), 489 MB on disk, the mesh tests then running on it (the same RTL ran them 10 of 10 the same morning). The next run: hdl-mesh8's `build.txt` with the block's relaunch succeeding and the g++ include paths under `sim_build_vroot`, the `mesh8 build:` stats line in minutes under 1 GB, `mesh8.txt` with M1–M3, M5–M7, M9, M12–M14, M16 on the silicon mesh. Run 126's hdl-sim read-out is in the 0.36 row. **Run 129 (8 Oct, fix33 on main), hdl-mesh8:** the fix held — the silicon mesh built hierarchically on the packaged Verilator through `sim_build_vroot` in **714.85 s wall with a 1,746 MB peak** (4 jobs; run 115's flat attempt at the 16×8-core variant had died past 14 GB), 489 MB on disk, and **the first CI results of the silicon mesh: 10 of 11** in 1,970 s of simulation (711 MB) — M1 bit-exact in 4,608 clocks, M2 2,365, M6 2,376, M3, M5, M7, M12 pass, M9's starved request timed out after 65,539 clocks and completed, M13's cross-partition fetch dropped and timed out, M14's 14 maximal fetches at one bank done at 292 … 3,697 clocks, 0.065 clocks per word, no cause — the sandbox's figures exactly; M16 failed as on tile32 (the 0.38 row) |
| 0.38 | **The two 32×32 failures of runs 126 / 129 closed** (one hook moved to the rising edge, one test table). **M16 on tile32 and mesh8 — the mechanism:** the router's two fault hooks wrote the output register at the falling edge (`out_flit[p] ^= mask`, `out_valid[p] <= 0`, the drop-0.35 pattern that serves the tile-internal hooks well), and the register's reader is the neighbouring tile's router. Reproduced in the sandbox on the flat tile32 build and traced in the generated model: the simulator copies a tile's output ports into its neighbour's input ports once per clock edge, in an order that reads the neighbour's inputs before the producer's outputs are updated, so a value written on a falling edge reaches the neighbour one edge too late — the flipped flit was sampled intact and the cleared valid was still seen (M9's valid-clear on the local port and every tile-internal hook are unaffected: no tile boundary between the write and its reader). neosim runs the same scenario at 32×32 and WPF 32 correctly (parity, lost, crc flagged), the 16×8 flat build passed by the same ordering taken the other way, the hierarchical mesh8 failed like tile32. **Fix:** the router hooks act on the flit the output register LOADS at a rising edge while the hook is high — `out_flit[i] <= head ^ (flip ? mask : 0)`, `out_valid[i] <= !clear` inside the register's own always block, an ordinary register update that every simulator orders the same way, zero terms when `DV_HOOKS = 0` (the generate branch is gone); the tests hold `fi_en` from before the response and release it in the cycle the flit shows in the register (`corrupt_local_response`, M16; M3 corrupts word 0 instead of aiming at the last word, since the whole flit is corrupted at its load). `make lint` 0 warnings, neosim N1–N2 pass on the new router. **C2's rq fault on core32 — the mechanism:** the duplicated-requantization comparator compares INT8 outputs, so an input fault is visible only where the output does not saturate; at the test's table (mult 30,000, shift 20) every column-0 value of the 32×32 run (80 input channels, accumulators in the 100,000s: traced, −128 / 127 on primary and duplicate alike for all 36 rows) saturated and nothing could differ. Fix: shift 26 — the outputs sit within ±128 and the flipped bit 12 moves each by 4,096 × 30,000 / 2^26 = 1.8, at least one LSB, in every row at both core sizes | sandbox: core32 (32×32 core, DV_HOOKS) **C2 passes with the new table: all four hooks flagged, nothing else raised, 3,640 cycles each**; the trace at shift 20 shows the saturation (every row ±128 on both copies, rq_err never 1). tile (16×8) **18 tests, 17 passed, 1 skipped at 46,282.52 ns** and core (16×8) C1–C3 pass — the known simulated times, the design's timing untouched; **tile32 (2×2 of 32×32, WPF 32) 18 tests, 17 passed, 1 skipped at 162,147.02 ns, run 129's exact total, M16 passing**: the flit corrupted on the (0,1)→(0,0) link dropped at (0,0)'s parity check and flagged, lost + crc at the requester, the fetch complete in 41 clocks; M3 and M9 through the load-time hooks. The hierarchical mesh8s (8×8 of 16×8 cores, 1024-bit links) runs M3 / M9 / M16 3 of 3 on the load-time hooks. **Run 133 (8 Oct, fix34 on main, 1 h 28 min) — the first fully green run of the new mesh:** hdl-mesh8 built the silicon mesh in 837.75 s at a 1,744 MB peak and ran **11 of 11** in 2,848 s (M16 on the silicon mesh: the flit corrupted on the (0,1)→(0,0) link dropped at (0,0)'s parity check and flagged, lost + crc at the requester, the fetch complete in 41 clocks; M14 unchanged at 0.065 clocks per queued word); hdl-sim lint clean, tile 17 + M14 skipped at 46,282.52 ns, tile8, **tile32 17 + M14 skipped at 162,147.02 ns, core32 3 of 3** (C2's four hooks flagged, 3,640 cycles each), the coverage builds 3 + 17 + 1 + 8 and the report at 53 / 53, the Verilator SV testbenches all pass; builds tile32 1.82 GB / 21 min, core32 1.50 GB / 13 min, coverage 15.5 GB / 32 min. Standing, not new, not gated: the two Icarus steps of hdl-sim print failures with every output X — Icarus does not execute an `always_comb` that reads no signal (ecc39's constant mask tables; the streaming core's inputs are X from the start), while the same testbenches pass bit-exactly on Verilator and neosim; a portable rewrite of the constant tables and a gated Icarus step are an item for a later drop |
| 0.39 | **The claims ledger: what the RTL backs, in the spec** (documents only; no RTL, no workflow change — the phase-0 drop of `ROADMAP.md`). `spec_sheet_v2_1.md`: four status tags defined at the top — **RTL-proven** (in `01_rtl/`, exercised by a named test at the stated scale: the 2×2 meshes of 16×8 and 32×32 cores and the 8×8 silicon mesh under cocotb on Verilator in CI, neosim, the SV testbenches), **planned** (not in the RTL; a design and a phase in `ROADMAP.md`), **IP** (licensed, outside the RTL by design) and **model** (a feasibility / performance-model figure or an analytical safety claim, not measured) — and a new §0, the ledger itself: 14 claims against what backs them today and what replaces them (262 TOPS dense = RTL-proven MAC count × model clock; **524 sparse TOPS planned, phase 3** — no sparse PE, index path, compressed weight format, packer or test exists; **the INT4 LLM figures struck** — INT8 datapath only, no external-memory endpoint in the RTL, back as measured numbers with phase 4's INT4 weight path and phase 2's bridges; 2.0 / 2.4 GHz model until phase 1's synthesized paths; ~56 W, TDP SKUs and the ≤ 2 W island model with the mechanisms planned in phase 5 and activity-based power in phase 7; the 262 / 196 / 131 / 65 family planned in phase 2 with the fuse source IP; LBIST IP with its hooks RTL-proven; PCIe, island, HSM, ISP, PHYs, controllers IP; the 128 MB SRAM RTL-proven at the silicon depth with the macro area model; links, safety mechanisms, compiler bit-exactness RTL-proven; FMEDA v1 and the YOLOv8-m figures model until phases 6 and 8). Every table of the spec carries a status column or line: §1 product rows (process, qualification and compliance tagged model / IP), **§2 reworded** — the throughput headline split into a dense row (RTL-proven × model) and a sparse row (planned), an 'other datatypes' row (INT4 / FP8 / BF16 planned), the 64-tile mesh and the 32×32 core listed as simulated; §3 / §6 / §7 / §11 status lines; §4, §5 and §8 status columns naming the tests; **§9 reworded** as a model section — each row names the phase that replaces it, the static compile the one RTL-proven entry, the LLM figures struck in place; §10 the sparsity / INT4 / vector-unit row and the LBIST and IP rows tagged; §12 names run 133 as the proof behind every RTL-proven tag. `spec_v2_1_summary.md` tagged the same way (the compute row now reads 262 TOPS dense only, the LLM figure struck, the workload row at the calibrated 1.90 / 0.99 ms). `08_ip_product/neo_npu_ip_datasheet.md` v0.16 aligned: the tag legend, the configurations table with its sparse column marked planned and its area / power columns model, a status column on the functional summary (operators: convolution, GEMM and ReLU RTL-proven; depthwise, pooling, softmax / layer-norm and attention planned in phase 4; the AXI bridges and control plane planned in phase 2; process row: no reference implementation yet), the status paragraph rewritten to run 133's state and the roadmap's phases; `neo_ip_ppa.txt` headed as model figures. `00_overview/ROADMAP.md` added — phases 0–9 with their drops and proofs, the designs of the sparsity engine (2:4 along K on PE pairs, two ABFT check columns, compressed entries), the vector unit, the chip top, the synthesis, formal and fault-campaign plans; the folder README lists it. The 0.38 row's proof column (run 133) is fix35's, folded into this package | the spec sheet, the summary, the datasheet and `ROADMAP.md` themselves; the run this upload triggers changes nothing (documents only) and is read as the baseline run of the next drops. Next: phase 1 — the open-PDK synthesis job (Yosys with the slang front end, OpenSTA, ASAP7 and Nangate45 from OpenROAD-flow-scripts; memories black-boxed per `09_synthesis/memories.md`), verified in the sandbox before it enters `regress.yml` |
| 0.40 | **The open-PDK synthesis job, and the memory arrays as leaf modules** (phase 1's first drop). `01_rtl/neo_mem.sv`: `neo_mem_sp` (G write groups, a registered read) and `neo_mem_rf` (the same write port, an asynchronous read port A, with RB = 1 a registered port B) — every array a memory compiler replaces is now one instance of these two: the bank's rows (32,768 × 624, a group per SECDED lane), the weight and activation buffers as pairs of entries (512 × 702 and 1,024 × 512, a group per entry), the accumulator (512 × 1,056, port A for the read-modify-write, B for the drain) and the NIC's drain FIFO (512 × 1,065 — found by the first synthesis as 545,280 flops); the testbench hooks (backdoor, stuck-at, flip) are ports of the leaves under `DV_HOOKS`, their decode in `sram_bank`, `wbuf_mem` and `neo_tile` under `generate if (DV_HOOKS != 0)` (the synthesis found the decode logic surviving at DV_HOOKS = 0 in all three); the cocotb wrapper, the SV testbench and neosim address the bank by row word (`u_mem.mem[a / 16][39 · (a % 16) +: 39]`), `bank_flip` for M5; `run_nic.py`'s file list gains the leaf. **`07_ci/synth/` + the `synth` job** (`07_ci/synth/README.md`): Yosys 0.69 with the slang front end and OpenSTA from GitHub (`tools.sh`, pinned; OpenSTA built once and cached), ASAP7 7.5T RVT SS at 500 ps (Nangate45 as a second library); the design synthesized as **units** — one Yosys run per module at its silicon parameters with the child units black-boxed and regrouped by parameters (the 32×32 array = 1,024 instances of the `mac_pe` unit + 32 of `mac_pe_chk`), the leaves as macro cells priced by a FakeRAM2.0 7 nm model (0.042 µm²/bit, 218 ps access), `synth -booth` with the Kogge-Stone LCU and `extract_fa`, flops named after their registers, ABC's speed script, repeater trees on nets above 32 loads (the sequencer's load strobe reaches 1,059 PE inputs); OpenSTA per unit with the children as extracted timing models (`write_timing_model`; a flat read of the tile's 2.5 M cells needs more than 6 GB); gates: every unit synthesizes, no latch, no multiply-driven net, the hierarchy consistent, PE count 1,056 / 144, no `dv_*` logic at DV_HOOKS = 0 over the tree, every timing run complete — timing reported, not gated. **First numbers (ASAP7 SS proxy):** the tile 1.283 mm² = 0.287 mm² of cells (2.31 M cells, 239 k flops) + 0.995 mm² of macro model (the bank 0.860 mm², 67 %); the PE 138 µm² (1,124 cells), the array 0.148 mm², the core 0.305 mm² with its arrays; the NIC 0.063 mm² of cells with 65,536 of its 72 k flops in `prow` (the per-source partial-sum row under assembly); requant 20 k µm² × 2. Minimum periods: PE 1,031 ps (the 8×8 product stage), check PE 1,093, array 1,411, sequencer 1,095, MBIST 1,030, bank 767, unpacker 756, DMA 558, ESM 540 — and over budget by design: **requant 3,039 ps** (the round / shift / zero-point / saturate stage; the 32×16 product stage 1.85 ns), **the NIC 7,662 ps** (the 16-word serial CRC behind the transmit beat; the bank's read data into it is the tile's worst path, 5.9 ns over; the receive CRC 5.5 ns), **the router 2,571 ps** (the `% 5` arithmetic of the round-robin grant), **the accumulator 1,732 ps** (the 33-operand ABFT sum), **the feeder 3.43 ns at the core level** (channel-tile register → address → asynchronous buffer read → array). The sandbox: 37 units, GATES all passed, 47 min; lint clean; cocotb core 3/3 at 7,890.00 ns and tile 17 + M14 skipped at 46,282.52 ns (run 133's figures); Icarus and Verilator SV testbenches ALL PASS; neosim `regress_ci`, `run_nic` I1–I12, M3 / M5 (`bank_flip`) / M11 ALL PASS. `09_synthesis/memories.md` the leaf table; spec §2 / §3 / §4 / §9 / §10 / §12 with the proxy figures; `ROADMAP.md` §5 the status and the 0.41 / 0.42 items (parallel beat CRC, `prow` as a leaf, requant in three stages, registered feeder address and buffer reads, pipelined ABFT sums, one-hot router arbitration, the descriptor fields constrained as static). | fix37 + fix38. Sandbox: synth GATES all passed (37 units), lint clean, cocotb core 3/3 + tile 17/18 (M14 skipped), the Verilator SV testbenches, neosim regress_ci + M3 / M5 / M11 (Icarus 14 passes both Icarus steps; CI's Icarus 12 keeps printing the standing X failures). **Run 146** (fix36 + fix37 on main, bfed160): python-regress green (regress_ci with the leaves and `run_nic`, tool_qual 130 / 130); hdl-mesh8 11 / 11 at 117,755.01 ns (build 691 s, 1.7 GB); hdl-sim green — lint clean, the Verilator SV testbenches ALL PASS (`tb_neo_core` on the repacked feeder), cocotb tile 17 + M14 skipped at 46,282.52 ns, tile8 1 / 1 at 1,441.00 ns, **tile32 17 + M14 skipped at 162,147.02 ns, core32 3 / 3 at 16,290.00 ns** (the silicon-depth leaves), the coverage builds with 53 / 53 functional bins — every figure of run 133; **synth red**: `tools.sh` stopped in the OpenSTA source build on the runner within a minute (cmake / make output was not in the log — fixed in fix38: the build prints its logs, a `tclsh` link and Debian's Tcl / flex / Eigen paths are passed to cmake, and a build failure no longer stops the job — synthesis and its gates run without timing and the timing gate fails; the binary is cached as soon as it is built). The proxy figures above are the sandbox run's until the job's first green run |
| 0.41 | **A1 — every path the 0.40 synthesis named, and the formal job** (four pull requests by four parallel streams, merged together; the first drop delivered as commits and PRs rather than a fixNN.zip). **The NIC (A1a, PR #1):** `crc16_beat` generated in matrix form (`02_dv/sim/gen_crc16_beat.py`: each CRC bit of the 16-word beat one XOR tree over 244–288 of 528 inputs, then one of 17 inverse matrices selected by the word count) — 4,723 → 733 ps, bit-identical on 69,792 vectors (exhaustive by linearity, `make crc16` under Verilator, Icarus 14 and 12, neosim I13) and by the formal job's equivalence proof against the frozen serial copy; `prow` (64 × 1,024 bits of per-source partial-sum rows) as a `neo_mem_rf` leaf without reset (a row's columns are always written before its check word reads them; a lost flit is caught by the count and the CRC) — `tile_nic` 7,662 → 2,324 ps, 477,805 → 104,987 cells, the tile 239,071 → 173,535 flops. **The arithmetic and the router (A1b, PR #3):** requant in three stages (the 32×16 product, the rounding bias and the zero point shifted up by `shift` as carry-save rows; one adder; shift / fits-in-8-bits / saturate; ReLU as 'zero point when the accumulator is negative') — 3,039 → 934 ps, 192,872 → 127,456 cells, bit-identical on 246 k rows and the boundary test Q4, latency 2 → 3; `abft_checker` in two stages with no carry-propagate adder (carry-save rows, then S + C == K tested as S ^ C ^ K == G << 1), the verdict two cycles after its row with a new `err_valid` routed to the core's ports — 1,447 → ~770 ps; `noc_router` with a one-hot rotating pointer and the flit's parity and route stored at FIFO entry, the grant order unchanged cycle for cycle (neosim N3: 9,365 grants against the 0.40 router, 0 differences) — 2,571 → 735 ps, 108,904 → 89,608 cells; `link_packer`'s link side registered (one cycle per hop on the 32-word links; neosim I14 against the 0.40 packer); the descriptor fields `cfg_*` as 4-cycle multicycle paths in the unit and tile SDCs (not `cfg_ct` / `cfg_ky` / `cfg_kx`, which the sequencer sets one cycle before a run). **The arrays' reads (A1c, PR #2):** the feeder's address generator incremental (adds only per pixel; the per-run constants in two multiplier-free cycles of radix-4 digit selects), the activation, weight and accumulator arrays read on the leaves' synchronous port B (an SRAM macro's read; port A tied off — three 1W1R synchronous macros), the accumulate a two-cycle read-modify-write with a one-stage forward (cocotb C4 / neosim K3: back-to-back rows to one address), the sequencer's counts re-derived (drain wait LAT + 4, one reduce-to-drain cycle `red_last`) — `neo_core` 3,430 → 1,331 ps in the merged tree; `run_conv_v02.py`'s descriptor driven (it hung on main). **The formal job (D1, PR #4):** SymbiYosys from the pinned OSS CAD Suite (`NEO_TOOLS_ONLY=oss`), nine full proofs on every push — ecc39 SECDED over all data and all single / double flips; `crc16_beat` equal to the frozen serial reference at BW 4 and 16 (BDD collapse + pdr — an all-XOR miter defeats SAT); packer → unpacker round trip word-exact and in order; router FIFO / XY / no-invention / one-token / fairness invariants; the two lockstep pairs equal from reset; requant table parity; the ABFT verdict — 19 planted bugs caught; `02_dv/formal/README.md`. Merge: the harnesses re-written for the merged RTL (the registered packer's proof needs bitwuzla, 94 s); A1b's 'drop 0.42' labels renamed; the two I13 tests of A1a / A1b kept as I13 / I14; `ROADMAP.md` rewritten to the four parallel streams; a documents-only push runs no CI. **Measured in the merged tree (run 162):** the tile 1,242,585 µm² (cells 224,510, macros 1,018,076), 1,793,461 cells, 185,614 flops, min period 3,145 ps set by the NIC's writeback-mask path (A2); requant 934, `neo_mac_core` 952, `act_feeder` 898, `acc_bank` 1,131, router 735, `neo_core` 1,331, the PE 1,031 unchanged. End times: +2 cycles per descriptor and +1 per registered hop — cocotb tile 46,282.52 → 46,298.52 ns, tile32 162,147.02 → 162,214.52, core32 16,290.00 → 17,473.50 (C4 added), tile8 1,441.00 → 1,451.50, mesh8 117,755.01 → 117,778.01; coverage 53 / 53 bins. **Carried to A2:** the packer's merge decision (−263 ps), the NIC's writeback mask and drain-FIFO head, the router's input-side parity against the link budget, the duplicated requant (2 × 127 k cells); the storage the synchronous reads added behind the R7 / R10 comparators (D2). | PRs #1 (run 156), #2 (157), #3 (161), #4 (160) each green; **run 162** on the merged main green on every job — python-regress (regress_ci, tool_qual 130 / 130), hdl-sim 65 min (lint clean; the three SV testbenches and `make crc16` ALL PASS; cocotb tile 17 + M14 skipped at 46,298.52 ns, tile8 1 / 1 at 1,451.50, tile32 17 + M14 skipped at 162,214.52, core 4 / 4 at 8,521.50, core32 4 / 4 at 17,473.50; coverage 53 / 53 bins, 15.6 GB peak; the standing Icarus 12 X failures unchanged), hdl-mesh8 11 / 11 at 117,778.01 ns, synth GATES all passed in 8.4 min (OpenSTA from the cache: the first green synth job was run 153 on the 0.40 RTL), formal 9 / 9 in 95 s. Sandbox on the merged tree: lint, Icarus core, Verilator testbenches (M1 3,804 clocks), neosim units / conv / K-split, the nine proofs |
| 0.42 | **A2a + A2b + B1 + C1 — two libraries and the period sweep, place and route in CI, the chip top, the 2:4 sparsity engine** (four PRs by four parallel streams, merged together on 13 Oct). **A2a (PR #8, run 175):** Nangate45 end to end as the second library (`make synth SYNTH_PDK=nangate45`, its FakeRAM45 macro model 0.557 µm²/bit, the report beside ASAP7's, `synth_report_libraries.md`); the period sweep (`--sweep`: OpenSTA at 500 / 750 / 1,000 / 1,250 / 1,500 ps per unit, a verdict per library = the smallest period at which every unit outside the PE-limited ones is clean); the macro model priced by the read ports a leaf uses (the tile's macro area 1,018,076 → 946,784 µm²); `tile_nic` with its incoming beats registered at the port and the drain FIFO's head on port B (2,324 → 1,172 ps, 104,987 → 77,587 cells; the next paths the receive / transmit CRCs); `link_packer` with an input register in front of the merge decision (571 → 795 ps min period, WNS positive) and `link_unpacker` without arithmetic in front of the word select (756 → 482 ps); the router left as A1 made it (clean from 1,000 ps on both libraries); the duplicated requant analysed (127,456 cells / 14,327 µm² per copy; a mod-7 residue check would cost 31 % of a copy and miss ~1 in 7 multi-bit errors — kept); verdict on ASAP7: every unit outside the PE-limited ones clean from 1,500 ps (at 1,250 only `bank_bist_wrap`, `prog_mem`, `core_seq`), the tile 1.243 → 1.170 mm²; `09_synthesis/synth_report_drop042.md`. **A2b (PR #5, run 179 + pnr dispatches 164–174):** the `pnr` job — OpenROAD-flow-scripts from the `openroad/orfs:26Q4-124-g3451ca1f5` image on the runner, started from `synth.py`'s netlists, the memory leaves as FakeRAM2.0 LEF / LIB macros (`07_ci/pnr/fakeram.py`), a 32 GB swap file because detailed routing fills the 16 GB runner, `workflow_dispatch` with a block list + a weekly schedule, reports by `07_ci/pnr/report.py`; five blocks routed with 0 DRC / 0 antenna violations: `mac_pe`, `c16_systolic_array`, `c16_neo_core` (3 h 10, 15.2 GB), `noc_router`, `tile_nic` — routed / synthesized minimum period 0.92–0.97 for the logic-bound blocks, 1.31 for the router's crossbar fan-out; the FakeRAM LEFs at about half the macro model's area for 1W1R leaves and 3.2 × for the pin-limited `prow`; `09_synthesis/pnr_*.md`, `07_ci/pnr/README.md`. **B1 (PR #6, run 171):** `neo_top` — the mesh plus a column of bridge nodes at x = NX (a router with a bridge on its local port, one per row; XW = 4, the tiles take NX + 1 for their source index), `noc_axi_bridge` with a memory role (AXI4 master: RDREQ → read bursts at `win_base + 4·addr` split at 4 KB, drains written beat by beat with the CRC checked as the NIC does, one burst in flight) and a host role (AXI4 slave over the banks: writes → WRHDR + WRDATA + CRC, reads → RDREQ with the beats returned as R data, SLVERR on `HOST_TIMEOUT`), `top_ctrl` (AXI4-Lite: tile windows at `0x400·n`, bridge windows at `0x1_0000`, globals at `0x2_0000` — ID / VERSION / CONFIG / SCRATCH, a 64-bit timer, the tile-enable map (a disabled tile is fenced at its router's inputs, not reset — the router sits on the tile's reset), DONE / ERR maps, IRQ status / mask, per-bridge window base and error bits; mirrored in `neo_host.h`), `mesh_ctrl` on the mesh clock, exactly three crossing structures (`cdc_fifo` gray-pointer FIFOs per bridge direction, `cdc_sync` handshake for the register bus, `cdc_bits` for levels), `aresetn` released before `rst_n`; the `top` cocotb suite T1–T5 (2 × 2 tiles of 16 × 8 cores + 2 bridge nodes, clk 1.0 / aclk 1.6 ns and aclk = clk: 6 of 6 each, 65,971.21 / 55,917.01 ns), lint of the top at the silicon parameters as two passes; `08_ip_product/neo_top_integration.md`; synthesis: `noc_axi_bridge` 65,466 cells 1,428 ps, `top_ctrl` 4,162 cells 661 ps; finding: a tile that computes while serving its own bank can deadlock (fixed in 0.43). **C1 (PR #7, run 169):** 2:4 structured sparsity along K — four-byte row buses in both modes with a one-hot byte select per PE (1,095 ps against 1,159 for a binary mux), PE pairs per channel group sharing one skew chain, NCHK = 4 check columns with fixed indices 0..3 (NCHK = 1 is today's dense core bit for bit), the weight entry {indices, four check weights, weights} = 376 bits in 12 SECDED lanes (the weight buffer 512 × 936), 64-channel sparse activation tiles as the feeder's pair word, the descriptor bit in the duplicated register 0x22, the model, the compiler's 2:4 validator / compressor / packer / layouts / perf model (640² YOLOv8-m 0.99 → 0.68 ms with every layer but the first sparse), the C driver; tests T6 / T7 (every check column), C11 (1,158 cycles against 2,238 dense, 1.93 ×), C5 on cocotb, M20 on a new `tile_sp` build, 59 / 59 coverage bins; area: data PE 138 → 159 µm², array +26.7 %, core +17.2 %, tile +4.3 %; the dense baselines unchanged. Merge: conflicts in the two Makefiles, `neo_backend.py`, `synth.py`, `memories.md`; the streams' labels 0.44 / 0.46 renamed 0.42. | PRs #8 (run 175), #5 (179), #6 (171), #7 (169) each green on every job. **Run 182** on the merged main: hdl-sim, hdl-mesh8, formal, python-regress green; **synth red** — the chip top's tile unit was synthesized at NCHK = 4 while `neo_top` instantiated `neo_tile` at its default NCHK = 1 (the hierarchy and PE-count gates): an integration fault of this merge, fixed in 0.43 (`neo_top` passes NCHK; the top's tile uses the silicon core unit) |
| 0.43 | **A3 + B2 + C2 + D2 — the tile at 800 MHz on the proxy, routed units and power, product mechanics, transformer readiness, the fault campaign and FMEDA v2** (four PRs, merged 13–14 Oct). **A3 (PR #10, run 206):** `bank_bist_wrap` 1,345 → 1,182 ps, `prog_mem` with a registered read and the DMA's `pc_out` one ahead (no cycle cost), `core_seq` 1,110 → 922 ps — every unit outside the PE-limited ones clean at 1,250 ps: **the tile's period on the ASAP7 SS proxy 1,500 → 1,250 ps = 800 MHz** (the PE's stage 1,031 / the check PE 1,057 ps after its 8 × 14 product in two parallel halves, the array 1,421 → 1,061 ps; exhaustively equivalent); 14 blocks routed at 1,250 ps (`requant`, `link_packer`, `prog_mem`, the 16 × 8 array and core, `act_feeder`, `noc_router`, `tile_nic`, `acc_bank`, `mac_pe`, `host_if`, `esm`, `tile_dma`, `mbist`, `link_unpacker`, `wbuf_mem`, `bank_bist_wrap` as 16 lane macros) — routed / synthesized cell area 1.03–1.33, the tile's routed-area estimate 1.233 mm² against the flow's 1.221 (ratio 1.010); the 32 × 32 core floorplanned and globally placed only (`repair_design` reached 89.5 % of 2.01 M nets at the job's 314-min limit — detailed routing of 1.5 M cells needs quadrant macros or a larger runner); power from recorded activity on the routed databases at 800 MHz: data PE 0.39 mW, 16 × 8 array 64 mW (1.10 pJ / MAC), 16 × 8 core 90 mW at 56.7 % utilization, the tile's other units 92 mW (NIC 19, router 25, bank 38) → the 32 × 32 core ≈ 485 mW, the tile ≈ 575 mW (`power_drop043.md`); the die sketch `09_synthesis/floorplan/`: tile 1,394 × 1,175 µm, 64 tiles 104.8 mm², die 14.15 × 10.76 = 152 mm² on the proxy against the spec's 210 mm² N5A — the two differ in opposite directions (the model's tile a fifth of its die, the proxy tile 2.6 × the model's), so the spec's non-tile area needs its own breakdown; `synth_report_drop043.md`, `pnr_drop043.md`. **B2 (PR #11, run 202):** one `neo_icg` clock-gate cell mapped onto the library's ICG in synthesis with an ICG gate and the gated-flop fraction in the report (`neo_top` 872 ICGs, 94.0 % of flops gated; the core's datapath off 20 % of C1's cycles, the requantizers 98 %, the tile's blocks 50–100 % per M-test); per-tile power-gating sequencers (iso → clock off → reset → off, and back; `neo_iso` clamps; `router_rst_n` so a fused tile's router forwards; no retention — a tile reloads) with `top` T6; 12 telemetry counters per tile behind `host_if` 0x40–0x4C plus bridge wait counters, validated exactly against the testbench's counts (M25) and feeding `neo_perf_v3` (measured MAC utilization 5–28 % on the test layers against the old model's 25–86 %: the model now takes the link width and pass spacing); two NoC priority classes with promotion after 8 grants (formal fairness bound a full proof; N4 measured 2 / 26 fires against bounds 5 / 44; N3 unchanged); dual-tile lockstep (each tile's last drain CRC and count compared by the control plane; T7); the memory bridge's read queue of 4 and write combining (four fetches 2,750 → 2,082 ns, a layer + drain 25 → 2 write bursts) and a command queue with completion records and an interrupt per completion (T8); the self-serve deadlock fixed with a loopback channel at the NIC's receive stage (M22); `synth.py` zeroes the ICG's clock-tree delay in the timing models (OpenSTA had counted it: `neo_core` 14,237 ps); timing: router 735 → 839 ps, `top_ctrl` 661 → 774, `requant` 934 → 893 (−12.5 % cells: the gate replaces the enable muxes), the sweep's verdict unchanged. **C2 (PR #9, run 210):** `vec_unit` on the drain path between the accumulator and the requantizer — 31-bit op words with odd parity, ops ADD_ROW / MUL_SCALE / CLAMP / LUT (256-entry interpolated tables: exp 15.7 LSB error against a 17 bound, GELU 2.1 / SiLU 1.7 against 3, 1/x 1.25 % against 1.6, 1/√x 0.47 % against 0.6, 1/x + a Newton step 0.099 %) / BSUB / RED (max, sum: log2(COLS)/2 + 2 cycles) / scalar ops / EMIT, two passes per row through a row buffer, bypass = program slot 0 END (dense layers unchanged), registers 0x38 VEC_ADDR / 0x39 VEC_DATA, 288,843 cells / 34,811 µm² / 1,082 ps at 32 lanes; INT4 weights (FETCH_W arg bit 0: nibbles widened on the way into the weight buffer, 5 words per 32 × 32 entry against 12, the per-channel scale in the requantizer or the unit's table); attention as the compiler emits it (Q / K / V projections, K drained transposed as weight entries, V as weight entries, max and exp rounds on the unit, P·V with 1/sum on the drain; 16 phases and 32 programs for T = 64, d = 32); the transformer operators (MatMul, Softmax, LayerNorm, GELU / SiLU, residual, transpose by DMA; `neo_xfmr.py`); tests V1 / V2, C12–C14, **M21 one attention head (5.74 LSB against float, 53,838 cycles; perf model 55,672), M23 a ViT block (1.94 LSB, 70,561), M24 an LLM layer with INT4 weights (2.36 LSB, 82,760)** — all bit-exact against the compiler's mesh model; hdl-sim 141 min (limit 200). **D2 (PR #12, run 203):** the nightly `faults` job (`02_dv/dv/cocotb/faults/`: Verilator `--public-flat-rw` injection of single-cycle flips and stuck-ats into flops and SRAM cells, seeded per-block sampling, classified detected / masked / dangerous / hang against the FTTI; 20 k + 5 k faults per build per night, published to `ci-logs-faults`) — run 192's 6,497 faults: diagnostic coverage 92.5 % on the core's flops, 97.7 % on the tile's, latencies within the FTTI; **201 dangerous-undetected faults: the activation buffer's cells (no error code — FMEDA v1 had credited it with SECDED), `neo_mac_core_v02`'s index / first delay lines, `skew_in`'s pipes, the NIC's drain-FIFO output register, MBIST state**; the comparator storage of 0.41 covered (`neo_mem_rf` exports `rb_addr_q`; `inb_q` / `a0_q` / `first_oq` / `w_load_q` / the read addresses / the accumulate's stage-0 compared; cocotb C6 flips each of the twelve and sees the flag); **FMEDA v2** (`05_safety/fmeda_v2.md`, `neo_fmeda_v2.xlsx`, `build_fmeda.py --v2`): core SPFM 99.904 → 95.946 %, chip PMHF 62.3 → **1,931 FIT against the 100 FIT ASIL-B(D) target — fails**, 28.5 of the core's 29.6 FIT the activation buffer; gate-level simulation of seven synthesized units against the RTL (0 mismatches over 2,992 cycles each); both Icarus steps gating (the `always_comb` tables rewritten; Icarus 12 passes). Integration: eleven conflicts of the C2 merge resolved on a branch by the C2 stream (host_if's register arms, neo_core's drain, tile_nic's loopback + drain format + INT4, the lint stub, synth.py); the chip top's tile uses the silicon core unit (D2's NCHK = 1 variant dropped); B2's telemetry test renumbered M25; B2's new memories connect `rb_addr_q`. | PRs #10 (run 206), #11 (202), #9 (210), #12 (203) each green on every job. **Run 184** on the merged main (a70ebdb, 13 Oct 19:21 UTC): hdl-sim green in 101 min, hdl-mesh8 11 / 11, formal 10 / 10, python-regress green, pnr `mac_pe` and `c16_systolic_array` routed; **synth red at its last step** — the gate-level simulation of `requant` did not elaborate (`Unknown module type: neo_icg`: the gated RTL's clock-gate model was missing from the GLS file list; fixed 20 Oct, `gls.py`); the synthesis itself and both libraries' gates passed; on the merged tree the sweep's verdict is back at 1,500 ps: `tile_nic` has one endpoint left at 1,250 ps (the merged NIC: the loopback channel, the INT4 unpack and the drain-format select together), the PE's own stage is 1,095 ps with C1's byte select (A3's 1,031 was the pre-C1 PE), `neo_core` has 63 endpoints at 1,250 ps on the requantizers' new input select (C2), and the chip-top bridges sit at ~1,500 ps outside the tile verdict — 0.44's timing items. The nightly `faults` job has run green since (runs 14–20 Oct) |
