astracore-ai/Astracore-Neo/09_synthesis/pnr_c16_neo_core.md

# pnr_c16_neo_core -- `c16_neo_core` placed and routed on ASAP7 through OpenROAD-flow-scripts

Generated by `07_ci/pnr/report.py` from the `pnr` job's logs (run 183 (workflow_dispatch on a3-physical at b44cf1e0f), started 2026-10-13 04:49:57 UTC; image `openroad/orfs:26Q4-124-g3451ca1f5`; make arguments `none`; ORFS targets `synth,floorplan,place,cts,route,do-finish`). Status: **complete**. The netlist is `synth.py`'s for the unit's subtree (c16_acc_bank, c16_mac_pe, c16_mac_pe_chk, c16_systolic_array, c16_neo_mac_core, c16_act_feeder, c16_neo_mac_core_v02, c16_requant, c16_core_seq, c16_wbuf_mem, c16_neo_core) at 1,250 ps on ASAP7 SS (ORFS CORNER = WC, the same NLDM files), the memory leaves as FakeRAM2.0 macros; ORFS's defaults otherwise (`07_ci/pnr/designs/neo_common.mk`, the block's `config.mk`). Timing is the final stage's: OpenRCX parasitics, the propagated clock tree. ASAP7 is a predictive academic PDK: the picoseconds and square microns are the library's, the ratios and the paths the design's.

| Figure | Value |
| --- | --- |
| die / core | 297.66 x 297.66 um / 295.60 x 295.38 um (88,599.7 / 87,313.1 um2) |
| utilization (cells and macros over the core, after routing) | 58.9 % |
| standard cells: synthesized (prep.py) / after placement / after routing | 334,395 / 373,783 / 379,179 (of these 16,636 timing-repair buffers, 35,799 tie cells, 8,852 taps; 439,693 fill cells beside them) |
| macros | 3 (6,758.3 um2) |
| cell area: synthesized / routed | 41,858.2 / 44,665.5 um2 |
| routed wire length / vias | 1,254,432 um / 3,011,137 |
| DRC violations after detailed routing (first iteration) / antenna-violating nets / diodes | 0 (82,845) / 0 / 0 |
| global-route congestion (usage, overflow H / V / total) | 17.36 %, 0 / 0 / 0 |
| setup WNS / TNS | **-104.4 ps** / -384.5 ps (8 violating endpoints) |
| hold WNS / TNS | 41.3 / 0.0 ps (0 violating endpoints) |
| minimum period, register to register / with the I/O paths | 1,354.4 / 1,354.4 ps (738 MHz) |
| clock tree: sinks, buffers (TritonCTS), buffers on a path, levels | 36,131 (clk 3, clk_regs 36,128), 2,324, 4-9, 8; after routing 3,123 clock buffers + 1,056 clock inverters |
| clock skew, setup / hold (with the 8 % setup uncertainty in the setup figure) | 181.3 / 87.6 ps |
| power at the flow's default activity (internal / switching / leakage / total) | 64.500 / 32.000 / 0.9190 / **97.400 mW** |
| max slew / cap / fanout violations | 59 / 0 / 0 |

Power in this table: OpenSTA's default switching activity (0.1 transitions per cycle on the inputs, propagated; the flow sets none); the recorded activity's figure is in the section on power below when the block has one.

## Power: the default activity and the recorded activity

OpenSTA's report_power on the final database (OpenRCX parasitics, the propagated clock) at 1,250 ps, ASAP7 SS 0.63 V / 100 C (the WC corner's NLDM and power tables), in mW.

The recorded activity: `c16_neo_core.json.gz` -- cocotb core (16x8, NCHK = 4): C1 dense conv + C5 2:4 sparse conv, Verilator 5.020, scope `TOP.neo_core`, a window of 2,858 cycles at 500 ps in simulation (the activity is per cycle, applied at the period above); MAC utilization in the window 56.7 %. Of the block's 36,739 flops 28,818 took a recorded bit by name, 0 by the folded index (a wider unit than the one simulated: the bit of the same signal at the index modulo the recorded range), 7,921 kept the propagated default; input bits 569 / 0 / 672. Pins annotated in the database: 28207 of 28818, input ports 569.

| activity | group | internal | switching | leakage | total |
| --- | --- | --- | --- | --- | --- |
| default | Sequential | 23.800 | 2.200 | 0.0819 | 26.100 |
| default | Combinational | 17.400 | 19.500 | 0.4220 | 37.300 |
| default | Clock | 16.900 | 10.300 | 0.0280 | 27.200 |
| default | Macro | 6.460 | 0.000 | 0.3870 | 6.840 |
| default | Total | 64.500 | 32.000 | 0.9190 | **97.400** |
| recorded | Sequential | 25.700 | 1.170 | 0.1050 | 27.000 |
| recorded | Combinational | 14.000 | 14.400 | 0.3410 | 28.700 |
| recorded | Clock | 16.900 | 10.300 | 0.0280 | 27.200 |
| recorded | Macro | 6.460 | 0.000 | 0.3870 | 6.840 |
| recorded | Total | 63.000 | 25.900 | 0.8610 | **89.800** |

Recorded / default: 0.922 (total), dynamic 0.921.

## The worst routed paths

Setup: `u_dp/u_feeder/a0_q_reg` -> `u_dp/u_core/u_array/g_row[0].g_col[0].g_data.u_pe/prod_q[15]_reg`, arrival 1,716.0 ps (launch clock latency included), required 1,611.6 ps, slack **-104.4 ps**, 31 cells (`orfs/reports/6_finish.rpt`).

Hold: `u_dp/u_core/u_skew.g_pairs.g_pair[5].g_next.u_da.pipe[547]_reg` -> `u_dp/u_core/u_skew.g_pairs.g_pair[5].g_next.u_da.pipe[515]_reg`, slack 41.3 ps.

The ten worst endpoints (`orfs/reports/neo/paths_max.txt`): `u_dp/u_core/u_array/g_row[0].g_col[0].g_data.u_pe/prod_q[15]_reg` -104.4, `u_dp/u_core/u_array/g_row[0].g_col[0].g_data.u_pe/prod_q[14]_reg` -74.7, `u_dp/u_core/u_array/g_row[0].g_col[0].g_data.u_pe/prod_q[12]_reg` -64.7, `u_dp/u_core/u_array/g_row[0].g_col[0].g_data.u_pe/prod_q[10]_reg` -58.4, `u_dp/u_core/u_array/g_row[0].g_col[0].g_data.u_pe/prod_q[13]_reg` -45.5, `u_dp/u_core/u_array/g_row[0].g_col[0].g_data.u_pe/prod_q[11]_reg` -24.7, `u_dp/u_core/u_array/g_row[0].g_col[0].g_data.u_pe/prod_q[9]_reg` -9.2, `ext_ready` -2.9, `u_dp/u_core/u_array/g_row[0].g_col[0].g_data.u_pe/prod_q[8]_reg` 4.7, `u_dp/u_core/u_array/g_row[0].g_col[9].g_check.u_pe/w_out[6]_reg` 18.5.

## Routed against synthesized

The synthesized estimate is the netlist ORFS placed (prep.py's) flat in OpenSTA with the same SDC, an ideal clock and no wires (`in/synth_sta/`); the routed figure is ORFS's final STA. A minimum period here is the period minus the worst slack of the paths named (the 8 % setup uncertainty and the setup time included on both sides). The routed netlist is not the synthesized one: the flow resizes and buffers it (timing repair in floorplan, CTS and global route), so the ratio carries both the wires and the repair.

| | synthesized | routed | routed / synthesized |
| --- | --- | --- | --- |
| setup WNS at 1,250 ps | -30.4 ps | -104.4 ps | |
| minimum period, register to register | 1,280.4 ps | 1,354.4 ps | 1.058 |
| minimum period with the I/O paths | 1,280.4 ps | 1,354.4 ps | 1.058 |

Setup WNS through the flow (repair_timing's own tables, before -> after its repair): floorplan (no wires, ideal clock: the synthesized estimate, then gate sizing) -30.4 -> -0.7 ps; CTS (placement parasitics, the propagated clock) -169.2 -> -107.8 ps; global route (its parasitics) -151.5 -> -137.9 ps; final (OpenRCX) -104.4 ps.

Synthesized worst path: `u_dp/u_feeder/u_mem/u_macro` -> `u_dp/u_core/u_array/g_row[0].g_col[0].g_data.u_pe/prod_q[14]_reg`, arrival 1,143.8 ps, slack -30.4 ps; register to register `u_dp/u_feeder/u_mem/u_macro` -> `u_dp/u_core/u_array/g_row[0].g_col[0].g_data.u_pe/prod_q[14]_reg`, slack -30.4 ps.

`synth.py`'s own figures for the units of the block (each unit with its children as extracted timing models, the synthesis job's per-unit view, 0.2 of the period on every unit's I/O):

| unit | instances in the block | cells (own) | WNS | minimum period | worst path |
| --- | --- | --- | --- | --- | --- |
| `c16_neo_core` | 1 | 230 | 21.2 ps | 1,228.8 ps | `u_dp` -> `u_seq` |
| `c16_wbuf_mem` | 1 | 2,685 | 75.4 ps | 894.8 ps | `u_mem` -> `rcdata[0]` |
| `c16_core_seq` | 2 | 2,687 | 148.6 ps | 782.3 ps | `ext_fire` -> `red_last_reg` |
| `c16_requant` | 2 | 31,947 | 5.6 ps | 935.6 ps | `in_acc[95]` -> `ra1[130]_reg` |
| `c16_neo_mac_core_v02` | 1 | 560 | -71.5 ps | 1,321.5 ps | `u_feeder` -> `u_core` |
| `c16_act_feeder` | 1 | 6,524 | 120.8 ps | 788.9 ps | `cfg_ct[2]` -> `s1_d[7]_reg` |
| `c16_neo_mac_core` | 1 | 13,448 | -10.0 ps | 1,110.0 ps | `x_in[12]` -> `u_array` |
| `c16_systolic_array` | 1 | 6 | -10.0 ps | 1,121.2 ps | `x_in[492]` -> `g_row[0].g_col[0].g_data.u_pe` |
| `c16_mac_pe_chk` | 64 | 1,634 | 13.6 ps | 922.7 ps | `x_in[7]` -> `prod_q[12]_reg` |
| `c16_mac_pe` | 128 | 1,253 | -10.0 ps | 829.0 ps | `x_in[12]` -> `prod_q[14]_reg` |
| `c16_acc_bank` | 1 | 5,205 | 107.8 ps | 1,142.2 ps | `fwd1_reg` -> `u_mem` |

The subtree's slowest unit by synth.py: `c16_neo_mac_core_v02` at 1,321.5 ps; routed register to register / that = 1.025.

## Macros (FakeRAM2.0, `07_ci/pnr/fakeram.py`)

| leaf (synth.py) | macro | words x bits, groups | pins | LEF size | LEF area | um2 / bit | synthesis model (memories.md) |
| --- | --- | --- | --- | --- | --- | --- | --- |
| `neo_mem_rf_w256_d128_g2_rb1` | `fakeram7_128x256_g2_1w1r` | 128 x 256, G = 2 | 530 | 33.25 x 42.00 um | 1,396.5 um2 | 0.0426 | 1,377.8 um2 (x1.0) |
| `neo_mem_rf_w288_d64_g1_rb1` | `fakeram7_64x288_g1_1w1r` | 64 x 288, G = 1 | 591 | 37.43 x 29.40 um (pin-limited) | 1,100.4 um2 | 0.0597 | 775.0 um2 (x1.0) |
| `neo_mem_rf_w390_d256_g2_rb1` | `fakeram7_256x390_g2_1w1r` | 256 x 390, G = 2 | 800 | 50.73 x 84.00 um | 4,261.3 um2 | 0.0427 | 4,198.1 um2 (x1.0) |

Placed by ORFS's macro placer (lower-left corner, orientation): `u_dp/u_acc/u_mem/u_macro` at (158.6, 1.1) um MY; `u_dp/u_feeder/u_mem/u_macro` at (11.0, 1.1) um MX; `u_wbuf/u_mem/u_macro` at (11.0, 212.4) um R0.

## Runtime and peak memory

| ORFS step | elapsed | peak memory |
| --- | --- | --- |
| 1_1_yosys_canonicalize | 0.0 min | 27 MB |
| 1_2_yosys | 0.0 min | 26 MB |
| 1_synth | 0.1 min | 916 MB |
| 2_1_floorplan | 1.3 min | 1,654 MB |
| 2_2_floorplan_macro | 0.6 min | 653 MB |
| 2_3_floorplan_tapcell | 0.0 min | 602 MB |
| 2_4_floorplan_pdn | 0.2 min | 690 MB |
| 3_1_place_gp_skip_io | 1.0 min | 1,265 MB |
| 3_2_place_iop | 0.0 min | 675 MB |
| 3_3_place_gp | 10.0 min | 3,758 MB |
| 3_4_place_resized | 2.8 min | 2,039 MB |
| 3_5_place_dp | 4.2 min | 2,679 MB |
| 4_1_cts | 4.6 min | 3,097 MB |
| 5_1_grt | 35.1 min | 5,952 MB |
| 5_2_route | 177.6 min | 15,166 MB |
| 5_3_fillcell | 0.1 min | 1,905 MB |
| 6_1_fill | 0.1 min | 1,198 MB |
| 6_report | 10.4 min | 6,645 MB |
| 7_neo_report | 3.3 min | 3,908 MB |
| 4_rsz_lec (inside its stage's step) | 0.6 min | 1,681 MB |
| 6_final_lec (inside its stage's step) | 5.1 min | 6,645 MB |
| **all steps** | **251.4 min** | **15,166 MB** |

By stage: synth (netlist read) 0.1 min, 916 MB; floorplan 2.1 min, 1,654 MB; place 18.0 min, 3,758 MB; cts 4.6 min, 3,097 MB; route 212.8 min, 15,166 MB; finish 10.5 min, 6,645 MB; neo_report 3.3 min, 3,908 MB.

The job's own stages (`run.json`): fakeram exit 0 in 0.0 min; prep exit 0 in 0.1 min; synth_sta exit 0; activity exit 0 in 0.1 min; synth exit 0 in 0.2 min; floorplan exit 0 in 2.2 min; place exit 0 in 18.0 min; cts exit 0 in 4.6 min; route exit 0 in 212.9 min; do-finish exit 0 in 10.6 min; neo_report exit 0 in 3.3 min.
