astracore-ai/Astracore-Neo/05_safety/neo_fmeda_v1.xlsx

Sheet: Assumptions
AstraCore Neo FMEDA skeleton, drop 0.3 (2026-10-04). Blue cells are inputs; yellow cells are assumptions to be replaced by foundry base-failure-rate and soft-error data (ISO 26262-11, SN 29500 or IEC 62380) before the phase-1 FMEDA v1.
Parameter | Value | Unit | Source / note
Die permanent base failure rate (whole 210 mm² die) | 200 | FIT | Assumption, order of magnitude for a large N5-class automotive die; replace with foundry data
Die area | 210 | mm² | Spec v2.0 physical estimate
MAC core area incl. buffers (one core) | 0.47 | mm² | 30 mm² for 64 cores from the die estimate
SRAM soft-error rate | 600 | FIT/Mbit | Assumption; replace with foundry SER at ground level, Grade 2 mission profile
Flip-flop soft-error rate | 100 | FIT/Mbit | Assumption; replace with foundry SER
Accumulator SRAM per core | 0.5 | Mbit | 512 rows × 32 columns × 32 bit = 64 KB
Activation buffer SRAM per core | 0.25 | Mbit | 4096 pixels × 32 channels × 8 bit = 32 KB
Weight registers per core (active + shadow) | 0.0176 | Mbit | 2 × 1056 PEs × 8.3 bit average incl. check column
Pipeline and control flops per core | 0.04 | Mbit | x/psum/token registers, skew and deskew, feeder, accumulator read registers
Mission lifetime | 131400 | h | 15 years × 8,760 h; vehicle operating hours are lower, kept conservative
ASIL-B(D) target SPFM | 90% |  | ISO 26262-5 Table 4
ASIL-B(D) target LFM | 60% |  | ISO 26262-5 Table 5
ASIL-B(D) target PMHF | 100 | FIT | ISO 26262-5 Table 6
ASIL-D target SPFM | 99% |  | ISO 26262-5 Table 4
ASIL-D target LFM | 90% |  | ISO 26262-5 Table 5
ASIL-D target PMHF | 10 | FIT | ISO 26262-5 Table 6
Derived (formulas)
Permanent failure rate of one MAC core | 0.448 | FIT
Transient failure rate, accumulator SRAM | 300.000 | FIT
Transient failure rate, activation buffer SRAM | 150.000 | FIT
Transient failure rate, weight registers | 1.760 | FIT
Transient failure rate, pipeline and control flops | 4.000 | FIT
Legend: blue = input you may edit; yellow = assumption to replace with sourced data; black = formula. Edit only blue cells.

Sheet: FMEDA_core
FMEDA v1 (drop 0.13), one MAC core (neo_mac_core_v02) as a safety element out of context. Safety goal assumed: no undetected wrong inference result leaves the core within the FTTI. Rows marked 'today' describe the v0.2 RTL; rows marked 'planned' name the mechanism the architecture commits to.
Block | Failure mode | Fault type | λ (FIT) | Safety related (1/0) | FMD (fraction) | SPF-relevant: violates SG alone (1/0) | Safety mechanism against violation | DC_RF | λ_SPF/RF (FIT) | MPF-relevant: latent if undetected (1/0) | Latent-fault mechanism | DC_L | λ_MPF,L (FIT) | Status / evidence
PE array datapath (1,056 MACs) | Wrong product or sum, single-point | permanent | 0.2462 | 1 | 0.9000 | 1 | ABFT check column: any single-point error in a row flips the row equality | 0.9900 | 0.0022 | 0 | n/a (detected faults lead to safe state) | 0.0000 | 0.0000 | v1: proven on RTL (T2, T3, C1-C10, K2, M-tests); self-test of the checker proven through registers (M8)
PE array datapath (1,056 MACs) | Dual faults that cancel in the checksum | permanent | 0.2462 | 1 | 0.1000 | 1 | Periodic in-field LBIST of the core | 0.9000 | 0.0025 | 0 | n/a | 0.0000 | 0.0000 | v1: LBIST is tool-inserted (Modus) and remains the one item with no RTL proof; the island carries the hooks and the FTTI-windowed schedule (M8 watchdog/self-test)
Weight registers (active + shadow) | Bit flip in a stored weight | transient | 1.7600 | 1 | 1.0000 | 1 | ABFT (corrupted weight flags every row) and reload per tile | 0.9900 | 0.0176 | 0 | n/a | 0.0000 | 0.0000 | today: proven (T4 weight bit-flip)
Weight registers (active + shadow) | Stuck bit in a weight register | permanent | 0.0224 | 1 | 1.0000 | 1 | ABFT | 0.9900 | 0.0002 | 0 | n/a | 0.0000 | 0.0000 | today: proven by construction (same mechanism as T4)
x / psum / token chains, skew, deskew | Bit flip in a pipeline register | transient | 2.8000 | 1 | 1.0000 | 1 | ABFT for data chains; token/valid parity | 0.9500 | 0.1400 | 0 | n/a | 0.0000 | 0.0000 | v1: ABFT proven; token/valid rule is an SVA property (dv/sva) for formal; parity on valid/token stays a fault-simulation item
x / psum / token chains, skew, deskew | Stuck pipeline register | permanent | 0.0448 | 1 | 1.0000 | 1 | ABFT; LBIST | 0.9700 | 0.0013 | 0 | n/a | 0.0000 | 0.0000 | v1: ABFT covers data (T2-T4); control is covered by the sequencer lockstep (C7) and the self-test (M8); LBIST see row 2
ABFT checker (array output) | Stuck at 'no error' (false negative) | permanent | 0.0090 | 1 | 0.5000 | 0 | none needed alone (does not violate SG by itself) | 0.0000 | 0.0000 | 1 | Periodic self-test: inject one known fault per FTTI via the fault hook, expect a flag | 0.9000 | 0.0004 | planned: fault hook kept as a test feature, sequenced by the safety island
ABFT checker (array output) | False positive (spurious error) | permanent | 0.0090 | 1 | 0.5000 | 0 | safe failure: leads to safe state | 0.0000 | 0.0000 | 0 | n/a | 0.0000 | 0.0000 | safe failure mode
Accumulator SRAM (64 KB) | Single-bit upset | transient | 291.0000 | 1 | 1.0000 | 1 | SECDED ECC (correct) and ABFT at drain (independent detection) | 0.9999 | 0.0291 | 0 | n/a | 0.0000 | 0.0000 | v1: ABFT at drain proven (C4); accumulator ECC not implemented: ABFT at drain detects any single-row corruption, so ECC would add correction, not detection
Accumulator SRAM (64 KB) | Multi-bit upset in one word | transient | 9.0000 | 1 | 1.0000 | 1 | SECDED detect + ABFT at drain | 0.9990 | 0.0090 | 0 | n/a | 0.0000 | 0.0000 | v1: argument only (interleaving is a memory-compiler choice); detection by ABFT at drain is proven (C4)
Accumulator SRAM (64 KB) | Stuck cell or decoder fault | permanent | 0.0358 | 1 | 1.0000 | 1 | ECC, ABFT at drain, MBIST at boot | 0.9990 | 3.580952381e-05 | 0 | n/a | 0.0000 | 0.0000 | v1: March C- MBIST implemented and proven (B1-B3 standalone, M11 through registers with ESM cause); ECC on banks proven (M5)
Activation buffer SRAM (32 KB) | Single-bit upset | transient | 145.5000 | 1 | 1.0000 | 1 | SECDED ECC; end-to-end CRC from the DMA (ABFT cannot see a wrong input) | 0.9990 | 0.1455 | 0 | n/a | 0.0000 | 0.0000 | v1: end-to-end CRC proven (M3); source-bank ECC proven (M5); MBIST proven (M11); the activation buffer itself is covered by the CRC at write and by the duplicated feeder control (C5)
Activation buffer SRAM (32 KB) | Multi-bit upset or stuck cell | both | 4.5224 | 1 | 1.0000 | 1 | SECDED detect, E2E CRC, MBIST | 0.9900 | 0.0452 | 0 | n/a | 0.0000 | 0.0000 | v1: proven for the bank path (M5, M9, M11); DC_L by periodic MBIST
Feeder address generator and run FSM | Wrong address, wrong sequence, early stop | permanent | 0.0269 | 1 | 1.0000 | 1 | Duplicated address generator with comparator (DCLS-style) | 0.9900 | 0.0003 | 0 | n/a | 0.0000 | 0.0000 | v1: duplicated feeder control proven (C5, drop 0.4)
Feeder address generator and run FSM | Bit flip in counters | transient | 0.6000 | 1 | 1.0000 | 1 | Duplicated address generator with comparator | 0.9900 | 0.0060 | 0 | n/a | 0.0000 | 0.0000 | v1: proven (C5)
Accumulator write/read control and index pipeline | Wrong row index or first flag | both | 0.6134 | 1 | 1.0000 | 1 | Parity on index/first delay lines; ABFT at drain catches mixed rows only partially | 0.9500 | 0.0307 | 0 | n/a | 0.0000 | 0.0000 | v1: coverage to be measured by fault simulation (Xcelium fault campaign); mechanism in place
Clock and reset distribution in the core | Clock stuck, glitch, reset glitch | permanent | 0.0090 | 1 | 1.0000 | 1 | Clock monitor and watchdog in the safety island | 0.9000 | 0.0009 | 0 | n/a | 0.0000 | 0.0000 | v1: windowed watchdog in the ESM proven (M8); clock monitor is a PLL/monitor IP item (RFQ 11)
NoC interface (requests, responses) | Corrupted packet, lost packet | both | 0.4179 | 1 | 1.0000 | 1 | Packet parity/CRC, timeout, sequence numbers | 0.9900 | 0.0042 | 0 | n/a | 0.0000 | 0.0000 | v1: router parity drop (N2), per-message end-to-end CRC (M3), word count per message for lost flits (M9a), fetch timeout (M9b); sequence numbers subsumed by the word count
Sequencer FSM, run counters, weight-buffer addressing | Wrong run order, wrong tile, early drain | both | 0.2134 | 1 | 1.0000 | 1 | Duplicated sequencer with comparator (lockstep), weight-buffer ECC | 0.9900 | 0.0021 | 0 | n/a | 0.0000 | 0.0000 | v1: lockstep sequencer proven (C7); weight-buffer ECC per lane proven (C9)
Requantization tables and datapath | Wrong scale, zero point or saturation | both | 0.1290 | 1 | 1.0000 | 1 | Table parity and a duplicated requant stage with comparator | 0.9900 | 0.0013 | 0 | n/a | 0.0000 | 0.0000 | v1: duplicated stage proven (C8); table parity proven (C10, including the fault the comparator cannot see)
Reduce port and partial-sum transfer (K-split) | Corrupted or lost partial-sum row | both | 0.0845 | 1 | 1.0000 | 1 | Check column travels with the partial sums; drain-time ABFT at the owner; row count in the sequencer | 0.9900 | 0.0008 | 0 | n/a | 0.0000 | 0.0000 | today: proven (K2 corrupted row flagged at the owner)
Totals |  |  | 457.2896 |  |  |  |  |  | 0.4390 |  |  |  | 0.0004
Safety-related λ_SR (Σ λ × SR × FMD) |  |  | 457.0345
Column guide: λ from Assumptions by area/bit share; FMD = share of the block's λ in this failure mode; DC_RF = diagnostic coverage against single-point violation; DC_L = coverage of latent faults in safety mechanisms. Blue cells are the inputs the safety team owns; coverage values here are engineering claims to be measured by fault simulation (Xcelium XFS / JasperGold FSV) in phase 2.

Sheet: Metrics
Hardware architectural metrics, one MAC core (formulas; ISO 26262-5 Annex C simplified, first-order PMHF)
Metric | Value | ASIL-B(D) target | ASIL-D target | Meets ASIL-B(D)?
Σ λ_SR, safety-related failure rate (FIT) | 457.0345
Σ λ_SPF/RF, residual (FIT) | 0.4390
Σ λ_MPF,L, latent (FIT) | 0.0004
SPFM = 1 − Σλ_SPF/RF / Σλ_SR | 99.90% | 90.00% | 99.00% | PASS
LFM = 1 − Σλ_MPF,L / (Σλ_SR − Σλ_SPF/RF) | 100.00% | 60.00% | 90.00% | PASS
PMHF, first order (FIT) = Σλ_RF + Σλ_MPF,L × Σλ_SR × T_life × 1e-9 | 0.4390 | 100 | 10 | PASS
Reading: the core's residual is dominated by the two findings in FMEDA_core (feeder control with no diagnostic today, activation-buffer corruption invisible to ABFT). The 'planned' coverages assume R7 duplication, ECC and E2E CRC are implemented; set those DC values to 0 to see the v0.2 RTL as it stands.

Sheet: Chip_rollup
Chip-level roll-up, accelerator die. Per element: λ_SR = safety-related failure rate of the element; DC_RF = coverage of its safety mechanism; λ_SM = failure rate of the mechanism's own logic; DC_L = coverage of the mechanism's latent faults by its self-test. The dual-point term pairs each mechanism's latent faults with the faults it covers (λ_MPF,L × λ_SR × T_life). Elements other than the MAC cores carry assumed values until their own FMEDA sheets exist. Blue = inputs.
Element | Count | λ_SR per instance (FIT) | DC_RF | λ_SM per instance (FIT) | DC_L | λ_SR total | λ_SPF/RF total | λ_MPF,L total | PMHF contribution (FIT) | Safety mechanism (summary)
MAC core (from FMEDA_core) | 64 | 457.034 | 0.9990 | 0.0004476190476 | 0.0000 | 29250.206 | 28.095 | 0.029 | 28.097 | ABFT, ECC, LBIST, duplicated feeder control (planned); residual and latent taken from FMEDA_core
Shared SRAM 128 MB, soft errors | 1 | 614400.000 | 1.0000 | 2.000 | 0.9900 | 614400.000 | 30.720 | 0.020 | 32.335 | SECDED (39,32) per word: proven on the tile mesh (M5, drop 0.9); + 4-way interleaving + scrubbing + ABFT credit at the consumer; λ_SM = ECC/scrubber logic; DC_L = periodic ECC error injection
Shared SRAM 128 MB, permanent | 1 | 61.905 | 0.9990 | 2.000 | 0.9900 | 61.905 | 0.062 | 0.020 | 0.062 | ECC, MBIST at boot, repair
NoC and DMA engines | 1 | 19.048 | 0.9900 | 1.000 | 0.9000 | 19.048 | 0.190 | 0.100 | 0.191 | Packet parity/CRC, timeouts, descriptor CRC; λ_SM = checkers
Safety island (lockstep R52+) | 1 | 4.762 | 0.9990 | 0.500 | 0.9500 | 4.762 | 0.005 | 0.025 | 0.005 | Dual-core lockstep, ECC, watchdogs, self-test
LPDDR5X controller and PHY | 1 | 22.857 | 0.9900 | 1.000 | 0.9000 | 22.857 | 0.229 | 0.100 | 0.229 | Inline ECC, link ECC, loopback test
PCIe, Ethernet, MIPI, ISP | 1 | 25.714 | 0.9800 | 1.500 | 0.9000 | 25.714 | 0.514 | 0.150 | 0.515 | CRC, end-to-end protection, frame counters
Clocks, resets, power management | 1 | 8.571 | 0.9000 | 0.500 | 0.9000 | 8.571 | 0.857 | 0.050 | 0.857 | Clock/voltage/temperature monitors
Totals |  |  |  |  |  | 643793.064 | 60.672 | 0.494 | 62.290
Chip SPFM | 99.991%
Chip LFM | 100.000%
Chip PMHF, first order (FIT) | 62.3
Meets ASIL-B(D) (SPFM ≥ 90 %, LFM ≥ 60 %, PMHF ≤ 100 FIT)? | PASS
Meets ASIL-D (SPFM ≥ 99 %, LFM ≥ 90 %, PMHF ≤ 10 FIT)? | FAIL
Reading: the shared SRAM's soft-error residual (DC_RF 99.995 %) and the dual-point term of its ECC logic dominate chip PMHF. Those two numbers (SRAM SER from the foundry, ECC-logic self-test coverage) decide whether the accelerator element meets ASIL-B(D) with margin; ASIL-D at chip level is not the target (decision 4). Elements other than the MAC cores are placeholders until their FMEDA sheets exist.

Sheet: Evidence
Mechanism evidence (v1): every coverage claim above points at the test that exercised the mechanism on the RTL
Mechanism | Fault injected | Test | Log | Drop
ABFT check column | +1 on one product in PE(0,0) for one cycle | T2 (model and 32x32 RTL), C4 | sim/neosim_mac_core_32x32.log, sim/neosim_conv_core.log | 0.1-0.3
ABFT at drain | bit flip in accumulator memory; corrupted partial-sum row in flight | C4, K2 | sim/neosim_conv_core.log, sim/neosim_ksplit.log | 0.3, 0.6
Duplicated feeder control (R7) | address generator corrupted for one valid cycle | C5 | sim/neosim_conv_core.log | 0.4
Lockstep sequencer (R10) | drain index bit 0 flipped | C7 | sim/neosim_conv_core.log | 0.8
Duplicated requantization (R10) | bit 12 of column 0 into the primary stage | C8 | sim/neosim_conv_core.log | 0.8
Weight-buffer ECC | data and check bits flipped in stored codewords | C9 | sim/neosim_conv_core_late.log | 0.12
Requant table parity | multiplier bit 0 flipped | C10 | sim/neosim_conv_core_late.log | 0.12
Link parity | flit bit flipped on a link | N2 | sim/neosim_noc.log | 0.4
End-to-end CRC | payload bit flipped past the last link check | M3 | sim/neosim_tiles.log | 0.7
Bank ECC | data and check bits flipped in the source bank | M5 | sim/neosim_tiles.log | 0.9
Lost-flit detection | a fetch-response flit dropped at the owner's port | M9a | sim/neosim_tiles.log | 0.12
Fetch timeout | request against a server held busy | M9b | sim/neosim_tiles.log | 0.12
Reduction flow control | contributor finishing before the owner (deadlock without RDY) | M2 | sim/neosim_tiles.log | 0.9
ESM, error pin, watchdog, checker self-test | self-test dummy run; watchdog not kicked | M8 | sim/neosim_tiles.log | 0.12
Bank MBIST (March C-) | stuck-at-1 bit; two stuck bits | B1-B3, M11 | sim/neosim_mbist.log, sim/neosim_tiles.log | 0.13
(39,32) SECDED code | all 39 single flips x 40 words; 400 double flips | ecc39 | sim/neosim_ecc39.log | 0.9
INT8 layer-to-layer path | none (functional) | M10 | sim/neosim_two_layer.log | 0.13
LBIST | none: tool-inserted (Modus), hooks and FTTI schedule in the island | - | - | handoff
