astracore-ai/Astracore-Neo/02_dv/formal/link_pack_fv.sv

// link_pack_fv.sv -- formal harness for the round trip rtl/link_packer -> rtl/link_unpacker (drop 0.41, the packer with the
//   registered link side; drop 0.42, the beat side registered too) at the silicon widths: BW = 16 words per beat, WPF = 32
//   words per link flit, XW = YW = 3. A free beat stream enters the packer, the packer's output register drives the
//   unpacker directly, a free sink takes the unpacker's beats.
//   Source assumptions (the tile interface's contract): nothing during reset; a beat is held, unchanged, until accepted;
//   a data beat (RDRSP, WRDATA, PSUM) carries 1..16 words with hdr[13:8] = words - 1; RDRSP / WRDATA carry hdr[7:0] = 0
//   as tile_nic sends them (on PSUM hdr[7:0] is the column of word 0, word i column + i); every other type is one word.
//   Scoreboard: the words are numbered in stream order on both sides (in_cnt, out_cnt); one word, number j, a free
//   constant, is captured when it is accepted -- its data and its stream fields (head, type, tag, hdr[19:14], its own
//   PSUM column, the whole hdr of a one-word type) -- and checked when the sink takes the word numbered j. j free makes
//   that every position: the beats out carry the same words, in the same order, with the same fields, none invented
//   or repeated.
//   Asserted as well: every link flit has even parity (stated as the XOR of its field and word parities, which is the
//   XOR of all its bits) and 1..WPF words, every beat out even parity and 1..BW words; a one-word type (the CRC that
//   closes every data stream) taken from the input register leaves only itself in flight besides the beat accepted
//   behind it -- every word accepted before it has been presented (drop 0.41: accepting it did that; before the link side
//   was registered, nothing at all was left); and with the sink ready a beat waits at most 2 cycles to be accepted -- the
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
