astracore-ai/Astracore-Neo/(commit log)

2026-10-12 crc16_beat in matrix form: 733 ps instead of 4,723 on ASAP7 SS, bit-identical
    Drop 0.40's synthesis put tile_nic at a 7,662 ps minimum period behind the
    transmit beat's CRC: crc16_beat chained 16 crc16_word stages, 512 serial XOR
    steps (the unit alone 4,723 ps, 3,275 cells). The step is linear over GF(2)
    with no constant term, so the module is now generated as matrices
    (02_dv/sim/gen_crc16_beat.py, committed): T = the CRC over the beat padded
    to MAXBW = 16 words with the words at positions >= n zeroed = A^(16-n) CRC_n,
    one reduction XOR per state bit over a fixed subset of the 528 input bits
    (244..288 of them), then CRC_n = (A^(16-n))^-1 T with the 17 inverses from
    Gaussian elimination, inde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
2026-10-12 tile_nic: prow, the partial-sum rows under assembly, as a neo_mem_rf leaf
    65,536 of the silicon NIC's 71,999 flops in drop 0.40's synthesis were
    prow -- logic [COLS*PW-1:0] prow [NSRC], 64 sources x 1,024 bits -- with a
    64:1 row mux behind them (~20 k of the NIC's 63 k um2 of cells). The rows
    are now one neo_mem_rf #(.W(COLS*PW), .D(NSRC), .G(COLS), .RB(0)) leaf,
    u_prow: a write group per column, prow_we[j] = rx_fire && PSUM && j in
    [ps_col0, ps_end), the beat's words at their column positions (the
    per-column mux of before as a flat vector), write address rx_src; the beat
    carrying the check word reads its source's row through the asynchronous
    port A in the cycle it arrives, where prow[rx_src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
2026-10-12 synth.py: the crc16_beat and tile_nic unit descriptions as drop 0.41 builds them
    The unit table, whose strings synth_results.json carries, still described
    crc16_beat as 16 chained word stages and tile_nic with the drain FIFO as
    its only leaf. Now the matrix form (an XOR tree per state bit, then the
    inverse for the word count) and both NIC leaves, the drain FIFO 512 x 1,065
    and the partial-sum rows 64 x 1,024. Description strings only: the 37
    units, their parameters and the flow are unchanged.
    Claude-Session: https://claude.ai/code/session_017rqMopCxSKbAjN1SDSoVsY
2026-10-12 act_feeder: incremental address generator, the activation read on the leaf's port B
    The address was a combinational function of the loop counters and the run --
    (ct & regions_m1)*tile_pixels + (oy*s + ky - p - iy0)*w + ox*s + kx - p, three 18-bit
    multipliers and an adder chain -- into the asynchronous port A, the entry select and the
    array's skew registers in one cycle: 3,005 ps from cfg_s[2] to x_vec at the unit, the
    core's cfg_s -> u_dp path (min period 3,430 ps), ASAP7 SS.
    Per pixel the generator now only adds: registers iy, ix (18 bits) and a / arow (AW bits,
    the brief's rowb + ix held as the pixel's address and its row's first address); per
    output pixel ix += s, a += s; at a row end ix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
2026-10-12 acc_bank: two-cycle read-modify-write with a one-stage forward; core_seq: the counts re-derived
    acc_bank read the written row asynchronously on port A, added and wrote in one cycle
    (wr_valid -> acc_idx -> u_mem -> 33 adders -> u_mem, 1,318 ps), with port B as the drain.
    The leaf is now a one-write-one-read synchronous SRAM -- every read on port B, port A
    tied off:
    stage 0: the operation is registered (v1, idx1, first1, the 33 addends as one 1,056-bit
    vector add1) and port B reads row acc_idx; fwd1 = v1 && (idx1 == acc_idx) is
    registered too: the operation in stage 1 writes that row at the edge this read is
    taken, so the read holds the row before that write;
    stage 1: old = fwd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
2026-10-12 memories.md: the activation, weight and accumulator arrays read on the leaves' port B
    The three rows' organisation and macro type now say what the RTL does since this drop:
    one registered read on port B per array, port A tied off -- one-write-one-read synchronous
    SRAMs (address at the edge, data the cycle after), the accumulator's read-modify-write in
    two cycles with a one-stage forward. The macro model is unchanged: it prices an RB = 1 leaf
    at 2.0x the bit cell whether port A is used or not, so the feeder's and the weight
    buffer's macro areas rise from 1.5x to 2.0x in the synthesis report (33,068 -> 44,091 and
    22,670 -> 30,226 um2) although the macro the RTL now asks for is the simpler one.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
2026-10-12 requant in three stages: carry-save product, one adder, shift and saturate (drop 0.42)
    Drop 0.40's requant had two stages, the 32 x 17 product (Yosys's Booth multiplier and
    its final adder) and the shift / round / offset / saturate behind it; the unit's min
    period was 3,039 ps on the ASAP7 SS proxy (sh1[113]_reg -> out_q[176]_reg, 2,966 ps).
    out_valid / out_q are now three cycles after in_valid / in_acc:
    1. s = acc * mult + c in carry-save form, with c = 2^(shift-1) + zp * 2^shift: the
    rounding bias and the zero point moved above the shift, which do not overlap, so c
    is two shifts and an OR. The rows are acc where mult[k] is set, shifted by k, each
    PW bits wide with its sign bit in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
2026-10-12 abft_checker: the row sum in two stages, the verdict marked by err_valid (drop 0.42)
    The checker summed the row's COLS columns and compared the sum with y_chk in one
    combinational path to the err output (drop 0.40: neo_mac_core y[962]_reg -> abft_err
    1,447 ps, acc_bank u_mem -> abft_err 1,644 ps, on the ASAP7 SS proxy). Stage 1 now
    registers NG = 4 partial sums of ceil(COLS / 4) consecutive columns with y_chk and
    valid; stage 2 adds the four, compares, and registers err. The row presented with
    valid in cycle t has its verdict on err in cycle t + 2, marked by err_valid (valid
    delayed by two); err_sticky rises at t + 3. Same function (sums wrapped to PW bits),
    two cycles of latency on the verd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
2026-10-12 noc_router: one-hot rotating arbitration, flit parity computed at FIFO entry (drop 0.42)
    Drop 0.40's critical path (rr[12]_reg -> count[5]_reg, 2,496 ps; min period 2,571 ps
    on the ASAP7 SS proxy) was the arbitration: a 1,077-bit parity reduce on each FIFO
    head, then a priority chain over (rr + 1 + k) % 5 comparing 3-bit request codes,
    then the pop decode back into the FIFO counters.
    - The parity is computed when a flit is pushed (^in_flit on the input side) and kept
    with the entry in fbad[5][2]; head_bad is a 2:1 mux of two stored bits.
    - The XY route is a one-hot request (req_oh: E/W from the x compares, N/S/local
    from the y compares when x matches); rq[o][i] = head i valid, parity go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
2026-10-12 link_packer: link side registered, merge decision off the data path (drop 0.42)
    Drop 0.40's packer drove link_valid / link_flit combinationally from core_flit: the
    merge compare (same / fits) chose emit_pend, which steered the 1,077-bit output mux
    and its parity (core_flit[520] -> link_flit[100], 1,041 ps input to output on the
    ASAP7 SS proxy; no register-to-register path at all).
    - link_valid / link_flit are registers, loaded whenever the stage is empty or
    draining (oready = !link_valid || link_ready); the pending logic sees oready where
    it saw link_ready. A data beat is taken when nothing is pending or the stage can
    take the pending flit, a single-word beat when nothing is pending a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
2026-10-12 synth: the layer descriptor as a 4-cycle multicycle path in the unit and tile SDC (drop 0.42)
    The descriptor fields (host_if's window 0x10-0x24 and cfg_m: STATIC_CFG in synth.py)
    are written by the host or the DMA only between runs, before go, and held for the
    whole run; the sequencer takes several cycles from go to its first f_start. The SDC
    gave their paths 0.2 of one period of input delay, so the units' worst paths were
    descriptor products (act_feeder cfg_s[2] -> x_vec 3,005 ps, core_seq cfg_m[3] ->
    rd_idx 1,982 ps, neo_core cfg_s -> u_dp) that the hardware never exercises in one
    cycle.
    write_sdc now adds set_multicycle_path 4 -setup / 3 -hold: on a block, -from the
    descriptor input port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
2026-10-12 formal: SymbiYosys proofs of the protection logic, nine tasks, all full proofs
    02_dv/formal holds one .sby and one harness per proof; the harnesses wrap the
    RTL of 01_rtl unchanged (read_slang -DFORMAL, immediate assertions, $past,
    free constants as self-holding unreset registers, hierarchical references for
    the inductive invariants). All nine pass on d69b862 as full proofs -- no task
    needed the bounded fallback:
    ecc39 every d, every single flip corrected, every double
    detected (ce/ue); ABC BDD collapse + pdr, 0.6 s
    crc16_beat bw4/16 rtl/crc16_beat == crc16_ref.sv (the serial chain of
    drops 0.29-0.40, frozen) for every crc_in, beat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
2026-10-12 formal job: run.py, make formal, NEO_TOOLS_ONLY=oss, the formal job in regress.yml
    07_ci/formal/run.py runs every task of every formal/*.sby (sby --dumptasks),
    one sby -f -d formal_out/<task> per task, --jobs at a time under --timeout
    seconds, reads sby's status file and log (PASS / FAIL / UNKNOWN / ERROR /
    TIMEOUT, mode, depth, engine, the k-induction length or bmc steps reached, the
    wall time, the failed assertions and their traces), writes
    formal_out/formal_report.md, copies it with every task log and trace to
    ci_logs/formal/, and exits 1 unless all PASS. sby is started as a session
    leader and the session is killed at the timeout and after every task: sby puts
    each engine in a process gro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
2026-10-12 abft_checker: carry-save first stage, carry-free compare in the second (drop 0.42)
    The first two-stage checker (four 8-column partial sums, then their sum and the
    compare) still set neo_mac_core's min period in this PR's synth job (run 158): 1,183
    ps, y[463]_reg -> u_abft.ps_q[63]_reg 1,109 ps -- each stage held a carry-propagate
    adder, ~600 ps in this flow on its own.
    Stage 1 now reduces each of NG = 2 groups of ceil(COLS / 2) columns to a sum row and
    a carry row with 3:2 compressors (rows taken three at a time, in order) and registers
    the four rows with y_chk and valid (128 flops, as before). Stage 2 reduces the four
    rows to S and C and compares S + C with y_chk without adding: S + C = K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
2026-10-12 noc_router: the route stored at FIFO entry too, thermometer occupancy (drop 0.42)
    After the one-hot arbitration the router's worst path (this PR's synth job, run 158:
    min period 1,242 ps) was rd[1]_reg -> count[9]_reg, 1,167 ps: the 1,077-bit head
    mux, the XY compares on the head's destination, the grant, the pop and a 2-bit
    increment / decrement of the FIFO count.
    - The route is computed at the push like the parity: the XY compares of in_flit's
    destination with the straps my_x / my_y (static: tied by the mesh, false paths in
    TILE_SDC), one-hot, stored with the entry (freq[5][2], 50 flops); the head's request
    is a 2:1 mux of stored bits, read through rd_a, a copy of the read pointer,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
2026-10-12 formal harnesses on the merged A1 tree: the two-stage ABFT verdict with err_valid, the three-stage requant's registers, the router's one-hot pointer and stored parity/route bits, the sequencer's red_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
2026-10-12 ROADMAP: the compressed plan -- four parallel streams, drop 0.41 = A1 + D1 done; documents-only pushes run no CI
    The plan table of 11 Oct regrouped into streams A (timing -> physical), B (chip top, power), C (sparsity, transformers),
    D (verification, software) with the merged steps marked done and the measured results of 0.41 in §5 (what each stream
    changed, the figures, what A2 carries forward); §6 the formal job's status. The workflow's push trigger ignores
    00_overview/** and *.md so a drop-log or spec commit does not start a 95-minute run (PR runs are unchanged).
    Claude-Session: https://claude.ai/code/session_017rqMopCxSKbAjN1SDS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
2026-10-12 pnr: place and route on ASAP7 through OpenROAD-flow-scripts -- the pnr job, FakeRAM2.0 macros for the memory leaves
    07_ci/pnr (new): synth.py's netlist of a unit's subtree through ORFS 3451ca1f5 (the commit synth/tools.sh
    pins for the liberty files) in its docker image openroad/orfs:26Q4-124-g3451ca1f5 -- no GitHub release
    ships an OpenROAD binary for it (OpenROAD's 26Q1-26Q4 releases are source only, Precision Innovations'
    .debs left GitHub in 26Q1, ORFS's GHCR images are `latest` only); tools.sh checks the image's
    flow/Makefile and scripts/variables.yaml against the pinned commit.
    fakeram.py one LEF + LIB per memory-leaf type from FakeRAM2.0's own classes (ORFS tools/FakeRAM2.0,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
2026-10-12 neo_top: the chip top -- bridge-node column at x = NX, NoC-to-AXI4 bridges, AXI4-Lite control plane, tile-enable fences, two clock domains (drop 0.44)
    The silicon configuration is neo_top's default: 8 x 8 tiles of 32 x 32 cores, 2 MB banks, 1024-bit links, a 512-bit AXI4
    memory bridge in every row, the host bridge in row 0. No tile RTL is changed (neo_tile.sv and below, tile_mesh.sv).
    - Geometry (neo_top.sv): (NX + 1) x NY nodes, tile_mesh's wiring rebuilt inside (tile_mesh and the mesh8 build are
    untouched). Column NX is one bridge node per row: a noc_router with no tile, its local port through the NIC's
    link_unpacker / link_packer pair and one cdc_fifo per direction into the bridge, o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
2026-10-12 08_ip_product: neo_top_integration.md -- what a licensee connects when Neo is the chip top (drop 0.44)
    The integration note the brief asks for, describing the RTL as built: geometry and parameters (the bridge column, why the
    tiles take NX + 1), the two clocks and resets and their order, the ports and their tie-offs, the control-plane map
    (mirrored by neo_host.h's NEO_TOP_*), the host window and the memory window, the bridge protocol per role with its
    throughput, ordering and head-of-line blocking, the three crossing structures with the constraint each needs in an
    implementation flow (set_max_delay -datapath_only on the gray pointers and the held payloads, false paths into the level
    synchroni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
2026-10-12 C1: 2:4 sparse layers in the compiler, the C driver and the suites -- validator, compressor, packer, layouts, perf; C11, C5, M20, coverage bins
    neo_backend.py: check_2_4() the validator (at most two nonzero weights in every group of four consecutive input
    channels, for every output channel and kernel position; the first offending group named), prune_2_4() the magnitude
    pruning a training flow applies (tests and examples only: pruning is training-side), compress_2_4() the compressor
    (group g of a 2*ROWS-channel run on the PE pair 2g / 2g + 1, the lower position on row 2g, a missing weight (0, index
    0) -- the model's rule), check_weights() the four check weights per row (the sum of the row's w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
2026-10-12 pnr: run 164's lessons -- swap for detailed routing's batch memory, the report from ORFS's final STA, noc_router / tile_nic
    Run 164 (dispatch, the three blocks at 1,000 ps): mac_pe routed in 1.4 min (WNS -8.4 ps, 0 DRC),
    c16_systolic_array in 70 min (WNS -187.6 ps, 0 DRC, 411,835 um of wire), c16_neo_core through
    floorplan (the macro placer placed the three macros in 21 s), place and CTS, then killed in its
    first detailed-routing iteration at 15.6 GB. The router keeps every finished worker of a batch --
    one colour of its 2 x 2 checkerboard, up to 1,024 workers, a quarter of the die -- until the
    batch ends: the array peaked at 15.3 GB of the runner's 16 GB, the core needs more.
    regress.yml: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
2026-10-12 tile_nic: the receive and transmit paths toward the PE's period (drop 0.42)
    The NIC was the tile's slowest unit after drop 0.41 (2.3 ns on the ASAP7 SS
    proxy). Probe: tile_nic at 16 sources (a 4 x 4 mesh), the silicon widths
    otherwise -- the silicon NIC's Yosys run is CI's -- on main 5eb76ec:
    86,923 cells, 9,626 um2, 2,352 ps register to register, -2,069 ps at
    500 ps with 0.2 of the period on the I/O (rx_flit -> wr_ptr[src] -> the
    WRDATA lane mask). After: 63,784 cells, 8,600 um2, 1,133 ps register to
    register, no violating endpoint from 1,250 ps on (the sweep: 652 at
    1,000 ps, worst -178 ps).
    RX stage the beat is registered at the port with its source's receive
    state (wr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
2026-10-12 link_unpacker: the beat's parity and count without arithmetic behind the select (drop 0.42)
    The first CI sweep (run 170) left one endpoint violating at every period on
    ASAP7 and Nangate45: link_unpacker's beat parity bit, -43 ps at 1,500 ps on
    ASAP7 SS -- the count field through the count arithmetic (words + 1, minus
    b BW, the compare, minus 1 again: half-adder chains) into the beat header,
    then the 564-bit XOR tree after the beat's selects, input to output with
    0.2 of the period on each side. It blocked the per-library verdict.
    count with BW a power of two, beat b holds the flit's last word iff
    the count field's bits above the lane bits are at most b, and
    its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
2026-10-12 pnr: the first routed blocks -- mac_pe, c16_systolic_array, noc_router at 1,000 ps on ASAP7 SS (run 168); step times without the nested LEC; tile_nic's layer adjustment; a pnr dispatch's group per bl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
    Run 168 (dispatch at 6eb9165, five blocks in parallel, one job each), all three with 0 DRC and 0 antenna after detailed
    routing, OpenRCX timing on the propagated clock tree:
    - mac_pe: 1,454 cells (1,054 synthesized), 17.4 x 17.4 um, 66.1 %, WNS -8.4 ps -> 1,008.4 ps register to register
    against 1,047.5 ps synthesized flat (routed / synthesized 0.963), 0.84 mW; 4 min of job, 1.3 min of ORFS.
    - c16_systolic_array: 185,892 cells (156,518), 189 x 189 um, 61.2 %, 411,835 um of wire, WNS -18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
2026-10-12 09_synthesis: stream A2a's drop 0.42 report -- two libraries, the sweep verdicts, the end times traced (drop 0.42)
    synth_report_drop042.md, from CI runs 162 (main), 170 and 172 (this PR):
    units every unit of the silicon tile on ASAP7 SS (run 162 -> 172)
    and Nangate45 TT: tile_nic 2,324 -> 1,172 ps, 104,987 ->
    77,587 cells; link_unpacker 756 -> 482 ps; link_packer 571 ->
    795 ps (the input register; the tile no longer sees the NIC's
    transmit logic behind it); neo_tile 3,145 -> 1,319 ps, 1.243
    -> 1.170 mm^2 (macros priced by the ports they use)
    verdicts ASAP7: every unit outside the PE-limited ones clean from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
2026-10-12 pnr: c16_neo_core routed (run 168) -- 281,253 cells and the three FakeRAM2.0 macros in 251 x 251 um, 0 DRC, 1,281.7 ps against 1,387.3 ps synthesized; report.py: CTS over its trees, the setup WNS thr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
    c16_neo_core at 1,000 ps on ASAP7 SS: 238,996 cells synthesized -> 281,253 routed (22,311 repair buffers, 23,417 tie
    cells, 6,849 taps) and the three macros (acc 64 x 288 pin-limited 37.4 x 29.4 um, wbuf 256 x 234 30.4 x 84.0 um, feeder
    128 x 256 33.3 x 42.0 um; 5,050.5 um2), which rtl_macro_placer put at the core's edges (wbuf and feeder in the bottom
    corners, acc on the left edge); 60.2 % after routing, 931,724 um of wire, 2.26 M vias. Detailed routing: pin access
    18.5 min, 56,924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
2026-10-13 pnr: tile_nic routed (run 174) -- 140,261 cells and its two FakeRAM2.0 register files in 330 x 330 um, 0 DRC at the 10 % layer adjustment; 2,165 ps against 2,308 ps synthesized
    Run 174 (tile_nic alone, at c31fe61, in flight beside run 168 under the per-block-list concurrency group): with
    ROUTING_LAYER_ADJUSTMENT 0.10 global routing ends without overflow (14.3 % usage; run 168 stopped at overflow 20 with the
    platform's 25 %). 109,207 cells synthesized -> 140,261 routed (32,386 repair buffers, 6,474 tie cells, 7,330 taps); the
    drain FIFO 512 x 1,065 (138.1 x 166.6 um) and the psum rows 64 x 1,024 (132.8 x 100.8 um, pin-limited: 2,093 pins on
    one edge) on the core's left edge with their pins fa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
2026-10-13 pnr/README: the report's setup-WNS-through-the-flow line among the outputs
    report.py writes repair_timing's before / after WNS at floorplan (its first row is the flat synthesized estimate), CTS
    and global route beside the final figure; the outputs paragraph names it.
    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
2026-10-13 Icarus 12 clean-up: unpacked-port receivers as nets, ecc39's masks as constants, both Icarus steps of hdl-sim gating
    The standing X failures of CI's Icarus 12 (make iverilog: T1 / T2 with 2,112 mismatches, y = x on every column) were not
    the always_comb tables: Icarus 12 does not drive a variable array from a child's unpacked-array output port, whether the
    receiver is a logic array or an output logic port that passes it on (a net receiver works; inputs and packed ports into
    array elements work) -- skew_in's x_row / s_row arrived as X in neo_mac_core. The receivers become wire, no functional
    change: neo_mac_core x_row, s_row, p_arr, p_algn; neo_mac_core_v02 y and the rd_data port; neo_core w_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
2026-10-13 A3 §1: the three units A2a's sweep left at 1,250 ps -- the MBIST's check registered, prog_mem's decoded word registered behind the DMA's next pc, the sequencer's ct - cfg_ct0 kept as a register
    Run 180 (main c7ad80a) swept every unit of the tile: at 1,250 ps all but three outside the PE-limited ones are clean --
    bank_bist_wrap 403 endpoints (-155 ps), prog_mem 64 (-122), core_seq 1 (-122). The fixes, unit synthesis in the sandbox
    (the same flow and tools as CI; unchanged units reproduce run 180 to the picosecond):
    - mbist.sv: the read data reaches the engine through the bank's 16 SECDED decoders (u_bank clk -> rdata 683 ps of its
    timing model) and the compare against the background, the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
2026-10-13 A3 §2: the check PE at the data PE's stage -- the 14-bit check weight as two 7-bit halves multiplied side by side, summed in the add stage
    mac_pe_chk (the ABFT check columns' PE, WW = WCW = 14 at 32 rows, 13 at 16; NB = 1) multiplied x by the 14-bit check
    weight in one 8 x 14 product: 1,093 ps register to register, and 1,240 ps from the x pin (the Booth rows one level
    deeper than the data PE's 8 x 8, the select lines fanned across 14-bit rows) -- the systolic array's worst path, the
    last data PE's x_out into the check PE: 1,421 ps on the 32 x 32 array (run 180), 1,236 ps on the 16 x 8.
    mac_pe.sv, WW > XW only (the data PE's always block of drop 0.42 is unchanged, its netlist identical: 1,2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
2026-10-13 A3 §3 / §4: the pnr job for the tile's remaining units and the 32x32 core, the bank as 16 lane macros, power from recorded activity
    The job's blocks (07_ci/pnr/designs/<block>/config.mk), dispatched with pnr_blocks: requant (127 k cells), link_packer,
    link_unpacker, acc_bank, act_feeder, wbuf_mem (each with its FakeRAM2.0 macro at the silicon size), prog_mem, host_if,
    tile_dma, esm, mbist, bank_bist_wrap, and neo_core -- the 32 x 32 core placed and globally routed only. The small,
    pin-heavy blocks take a utilization that lets the die hold their pins one track apart (link_unpacker 35 %, mbist 30 %)
    and stay above two pitches of the platform's power straps (tile_dma 30 %, esm 15 %); act_feed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
2026-10-13 A3 §4: the core's recorded activity -- C1 + C5 on the 16x8 core (NCHK = 4) through Verilator's VCD, 2,858 cycles at 56.7 % MAC utilization
    bash pnr/activity.sh core in the sandbox (Verilator 5.020, cocotb 1.9.2; C1 and C5 PASS at their usual end times): the
    window is the core busy, 2,858 clock cycles, the array's input valid high 56.7 % of it. One file per block the pnr job
    routes from the core: c16_neo_core, c16_systolic_array, mac_pe (the mean over the 128 data PEs), requant, acc_bank,
    act_feeder, wbuf_mem, and neo_core -- the 32x32 silicon core takes the same recording as c16_neo_core (the scope
    TOP.neo_core; power.py folds the larger array's indices into the recorded range); activity.sh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
2026-10-13 A3 §3: wbuf_mem's macro against the core's right edge with its pin edge inward, the core at 45 %
    Run 183 routed acc_bank, act_feeder and mac_pe at 1,250 ps (setup WNS 0.0 / 0.0 / clean) and stopped wbuf_mem in global
    routing: GRT-0116, overflow on M6 (4,875 in all). ORFS's macro placer put fakeram7_512x936_g2_1w1r at the core's left
    edge mirrored (MX), so its pin edge -- FakeRAM2.0 puts every signal pin on the left edge: 936 write and 936 read data
    bits, the addresses -- faced the die boundary 11 um away, in a 195 um core at 55 %. acc_bank's macro (R180) and
    act_feeder's (MX at the right edge) had their pin edges inward and routed clean.
    designs/wbuf_mem/macro_place.tcl places the macro R0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
2026-10-13 C2 (drop 0.43): the vector unit on the drain path, INT4 weight fetch, the drain's INT8 layouts, multi-run DMA programs
    vec_unit.sv (new: vec_ctrl + vec_unit) between neo_core's accumulator drain and its requantizer pair. Program slot 0 =
    END (reset) is the bypass: the requantizers take rd_data / rd_valid as before, dense rows and cycles unchanged. With a
    program loaded (vec_on, latched at go) the sequencer's drain runs with rd_valid held low, then the unit re-reads rows
    0 .. cfg_m - 1 through the drain port, runs up to 16 micro-ops per row on the row held in X (two passes possible) and
    feeds the requantizers with the rows its EMITs produce; done is the unit's. Ops: END EMIT ADD_ROW MUL_SCALE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
2026-10-13 C2 (drop 0.43): transformer operators in the compiler, an attention head / a ViT block / an LLM layer on the 2x2 mesh
    compiler/neo_xfmr.py (new): MatMul as a 1x1 convolution over the tokens with the drain layouts of 745b528 (Q / P as
    padded activation entries, K drained transposed as the scores' weight entries, V as P V's weight entries, group strides
    into the consumer's weight tiles); one DMA program runs a layer's output tiles as GO / WAIT_DONE pairs when their
    epilogues agree (INT8: per-tensor scales), one per output tile when they do not (INT4: per-output-channel scales in the
    requantizer / SC tables). The INT4 packer (w4_entry, per-column quant_sym). Epilogues on the vector unit (plain,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
2026-10-13 The comparator storage of drop 0.41 compared: inb_q, a0_q, first_oq, w_load_q, the accumulate's stage-0 control and the three port-B address latches behind R7 / R10
    Drop 0.41's synchronous reads put state between the generation cycle and the use that the comparators did not see. Each
    of these registers, upset, presents a consistent wrong row -- a zeroed row, the other entry of the pair, an overwrite
    instead of an accumulate, a weight row from another entry or a cycle off, a partial sum added to the wrong row, another
    row drained -- which the ABFT check column and the SECDED lanes pass by construction. C6 (new, cocotb core) flips each of
    them through the model's VPI in a cycle it is used: bef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
2026-10-13 The fault campaign: faults injected through the VPI of the cocotb builds, classified against the fault-free run; the faults job (nightly 02:30 UTC and on demand) in both workflow copies
    02_dv/dv/cocotb/faults/:
    - flops.py: the population from the RTL itself -- neosim elaborates the build's toplevel at its parameters (the scope
    names Verilator gives the model) and every signal a rising-edge always_ff writes is a flop, labelled with its block
    (the innermost enclosing instance of the report's modules); the memory leaves' arrays are listed apart (block
    <parent>.sram, sampled with a quota of their own), the leaves' output registers and port-B latches as <parent>.macro.
    Core build (neo_cor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
2026-10-13 A3 §4: the tile's recorded activity -- M1 + M18 + M19 on the 2x2 mesh at 32 words per flit, 10,306 cycles at 32.8 % MAC utilization; power.py maps flattened arrays
    bash pnr/activity.sh tile in the sandbox (Verilator 5.020, cocotb 1.9.2; the three tests PASS): the window is tile
    (0,0)'s DMA running a program, 10,306 clock cycles, its core's array input valid 32.8 % of them. One file per routed
    block of the tile: tile_nic, noc_router, link_packer, link_unpacker, bank_bist_wrap, mbist, prog_mem, tile_dma,
    host_if, esm. As with the core's files, the window's clock period field is corrected to the window's time over its
    clock rises (this run's activity.py started before that fix: 902 ps for the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
2026-10-13 A3 §3: fakeram.py's synthesis-model figure by the synthesis results' own class -- a port-B-only neo_mem_rf is x1.0
    fakeram.py priced every neo_mem_rf leaf with RB = 1 at the two-read-port factor (x2.0) for the comparison it prints and
    writes to macros.json; synth.py has classed by the ports an instance uses since drop 0.42 (a leaf read only on its
    registered port B is neo_mem_rf_b, x1.0: the core's three arrays, the NIC's drain FIFO). Run 183's reports showed
    acc_bank's macro at 22,823 um2 of LEF against a 45,468 um2 model; the synthesis job's model is 22,734 (LEF / model
    1.004). fakeram.py now takes the class from the synthesis results' record (the old rule for a leaf given by name), and
    t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
2026-10-13 faults: the probe indexes every array's first element, unresolved faults logged; the faults job builds FMEDA v2 from its campaign
    An unpacked array of single bits with no packed dimension (requant's wrt / par / n1 / n2, the router's valid bits) is one
    GPI register of its element count on Verilator 5.020 with no element to index, so its faults ended unresolved (one in
    the local run, u_rq.wrt[2]); the fault-free run's probe now indexes each array's first element and run_faults.py leaves
    the arrays it cannot reach out of the sample (core build: the eight requant arrays, 64 bits). A fault that does not
    resolve is logged with the reason; a generate scope cocotb cannot map is asked once. The fault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
2026-10-13 B2 tile: clock gating, telemetry counters, router priority classes, the self-serve fix, the power-domain hooks and lockstep outputs (drop 0.43)
    Clock gating: neo_icg (01_rtl/neo_icg.sv), the latch-based ICG in behavioural form (enable latched while clk is low,
    gclk = clk & latched), is the one clock gate. Gated: the core's datapath (busy and the drain tail), each requantizer
    (a row in any stage, a table write, a clear), the NIC's receive and transmit halves (clk_rx / clk_tx: a beat at or in
    the stage, the write-back, a fetch outstanding, a command; the engine not idle, a drain row readable, ...), the router's
    five output stages (a fire into or out of the stage), each DMA engine (busy or a co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
2026-10-13 B2 chip top: the power map and its sequencing, dual-tile lockstep, the bridges' request queue and posted combined writes, the command queue, the bridges' wait counters (drop 0.43)
    Power map (mesh_ctrl.sv): TILE_EN, applied while a tile is idle as before, now drives a sequencer per tile in the mesh
    clock -- a gray-code cycle of eight states, each step DWELL = 4 clk (power-on PWR_DWELL = 16): ON, ISO (isolation on),
    CLKOFF (the domain's clock gated), RST (its reset), OFF (tile_pwr_en low, a new neo_top port for the power switches);
    PWRON (power, reset held), RSTREL (reset released with the clock off), CLKON (clock on, still isolated), ON (isolation
    off). The four outputs are flops (tile_rst_n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
2026-10-13 B2 synthesis: neo_icg mapped onto the library's ICG cell, the ICG gate and the clock-gated flop fraction per unit; the new leaves and units (drop 0.43)
    synth.py black-boxes neo_icg in every unit (slang) and maps each instance after synthesis onto the library's integrated
    clock gate -- ICGx1_ASAP7_75t_R (CLK, ENA, SE, GCLK), Nangate45 CLKGATETST_X1 (CK, E, SE, GCK) -- so the behavioural
    latch never reaches the netlist and the latch gate stands; a gated clock net is a clock (no repeater tree). Gate: every
    unit holds exactly the ICG cells its definition declares (U(..., icg=N): requant 1, neo_core 1, tile_nic 2, noc_router 5,
    tile_dma 1, neo_tile 1 -- the power domain's), none left unmapped. re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
2026-10-13 B2 documents: the integration note (the power map, retention, lockstep, the bridges' queues, the command queue, telemetry, priority) and the formal README (drop 0.43)
    08_ip_product/neo_top_integration.md: tile_pwr_en among the ports; the register map's drop-0.43 rows (PRIO, LS_PAIR,
    LS_ERR, PWR_STATE, the command queue, TEL_CTRL / TEL_CYCLES, the bridges' RD_WAIT / WR_WAIT / STATUS, the command
    memory) and a tile's PRIO / telemetry window; 4.4, the command queue's formats and rules; 5, the memory role's queue (one
    AXI ID: the note), the posted combined writes, the read-after-write order, the measured throughput, the priority classes
    and their bounds; 6, the new level crossings; 7, the power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
2026-10-13 faults: every flop of the build put back before each run -- the registers without a reset carried a fault into the next run
    The first dispatched campaign (run 187: 3,750 faults per build, 4 workers, 40 minutes) showed it on the tile build: rq_err
    was the first cause of 3,300 of 3,750 faults, a bank-cell flip included. Reset does not reach requant's tables, and M1
    (an INT32 drain) does not rewrite them, so the first table fault a worker ran left u_rq and u_rq_dup different for every
    later run of that worker. The drivers now keep every flop element of the build (run_faults.py writes them, state_<build>.json,
    FAULTS_STATE) and put back what differs from its value at the test's start before each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
2026-10-13 A3 §3: bank_bist_wrap placed wire-length driven, the step coefficient at 1.03 -- run 188's global placement diverged
    GPL-0307 in 3_3_place_gp: the overflow low and rising, the wire length doubled within ten iterations, at the iteration
    where timing-driven placement inflated the block's 877 um2 of cells by 57 % -- 7 k cells (the 16 lanes' encoders and
    decoders, the MBIST, the port mux) spread over a 1.2 mm core that is 99.9 % macro. GPL_TIMING_DRIVEN and
    GPL_ROUTABILITY_DRIVEN off (timing is still repaired after placement: CTS, global routing), MAX_PLACE_STEP_COEF 1.03
    against ORFS's 1.05, as the error advises.
    Claude-Session: https://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
2026-10-13 A3 §3: tile_nic's macros stacked at the core's left edge with their pin edges inward; synth/README's PE counts at four check columns
    Run 188 stopped tile_nic in global routing (GRT-0116, overflow 2,025, 1,557 of it on M6): the macro placer put the
    partial-sum rows' macro (2,093 pins on its 100.8 um left edge) at the core's left edge mirrored (MX), its pin edge 11 um
    from the die boundary -- wbuf_mem's failure of run 183. designs/tile_nic/macro_place.tcl stacks both macros against the
    left edge mirrored about Y (MY), their pin edges toward the core, as run 174 had them when tile_nic routed clean (a macro
    that would not fit the column goes against the right edge, R0, pins inward too). place_m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
2026-10-13 B2 synthesis: the dv_* hooks outside the tile's isolation cell (run 191's DV_HOOKS gate), the timing models' clock tree paths at 0 behind the clock gates (drop 0.43)
    Run 191's synthesis job failed one gate: neo_tile / top_neo_tile "dv_bd_rdata is driven by logic" -- the drop-0.43
    status isolation cell clamped dv_bd_rdata and dv_obs with the domain's flags. The hooks are testbench ports (at
    DV_HOOKS = 0 the bank's tied-off pins and a constant) and pass straight out now; the cell holds the 81 status bits.
    The same run's timing was wrong wherever a clock gate sits in a unit: write_timing_model prices the clock tree from the
    unit's clk pin through the ICG to its flops, unbuffered (requant: one I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
2026-10-13 C2: the vector unit pipelined -- one adder or comparator a cycle, its control copied per lane -- 2,667 -> 995 ps at 8 lanes
    Run 196 timed vec_unit at 3,170 ps (32 lanes) / 2,667 ps (8 lanes): sh's buffer chain into every lane's shifters, then
    round / shift / BI / saturate behind a 64-bit add in one cycle; the LUT interpolation's 26 x 26 multiply behind the leaf's
    access time; two compare levels per RED stage; the scalar operand muxes in front of SALU / RSST / SMUL. The unit stays
    a sequential engine (an op runs alone; X and S are written in its last cycle, every stage register is loaded every
    cycle), the ops take more cycles:
    - vec_mul (new, requant's structure): the 16 partial products of X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
2026-10-13 C2: the NIC's formatted drain in three stages -- the source select and the check weight's adder tree out of one cycle
    Run 196 (f63c666) timed tile_nic at 1,640 ps (main 1,179): drain_tr's select between the block buffer's row and the
    requantized row, fanned out to 256 bits, then the WCW-bit sum of the row's 32 bytes (an eight-level compressor tree and
    its carry chain) into fa_chk, in one cycle. A formatted row (DRAIN_WR base [15:13]) now passes three registers: f1 the
    source row (the select, registered -- the old trq stage, now for every format), f2 the row and its partial sums in
    groups of eight bytes (11 bits each), f3 the row and the check weight (the sum of the partials), pushed with f3_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
2026-10-13 B2 timing: the NIC's stage registers load on lb_valid, lb_csel keeps the decode and the control alone (drop 0.43)
    Run 200's synthesis (every gate passed; neo_core 1,365 ps, neo_tile 1,337, top_neo_tile 2,357 with the models' clock
    trees at 0) still had tile_nic at 1,225 ps (run 180: 1,179) and top_tile_nic at 1,228 (1,156), both from lb_csel: the
    previous commit moved i_take onto it, and i_take is the load enable of the stage's registers (q_flit's 1,077 bits and the
    decoded fields), so lb_csel carried the fanout lb_valid had shed -- its buffer tree (423 ps) again in front of the
    header decode, here into q_pschk (the PSUM check word's column test). i_load = lb_valid || (link beat not held) no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
2026-10-13 fakeram: the RBQ = 1 macros' rb_addr_q pins written to the LEF, and rb_addr_q in --leaf's pin list
    The pnr job does not run on a pull request, so 3924941's macro change had not run. Running fakeram.py --leaf locally
    against the pinned ORFS commit's FakeRAM2.0 showed that the _1w1r macros' liberty had the rb_addr_q bus with its
    clock-to-Q arc, and the wrapper connected .rb_addr_q, but the LEF had no rb_addr_q pin. FakeRAM2.0's LefExporter writes
    only the pins of the read/write port groups and the memory's misc busses / ports, and rb_addr_q (deliberately not a
    data output of the read group) was in neither. That would have failed the link of every pnr unit containing a core.
    The macro now regis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
2026-10-13 memories.md: the RB = 1 macros' rb_addr_q (the c16 table's pin counts with it, the footprints unchanged)
    The macro paragraph now lists rb_addr_q among the 1-write-1-read macro's functional ports: the port-B address readback
    of drop 0.43, AW clocked outputs, left open by an RBQ = 0 user such as the NIC's drain FIFO. The c16 table's pin counts
    come from fakeram.py --leaf with 9d47d53: 488 -> 496, 530 -> 537, 591 -> 597. The LEF sizes, areas and µm² per bit are
    the same as before. The paragraph is reflowed to 120 columns.
    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
2026-10-13 A3 §3: tile_table.py -- the cell area without taps, the newest stage a run reached, the 32x32 core at its 16x8 counterpart's ratio when unplaced
    - The routed cell area compared is the standard cells without the tap cells: taps follow the core area a block was
    given, not its logic (65,000 of the standalone bank's 76,204 routed cells in its 1.2 mm core of macros).
    - A block's figures come from the newest stage its run reached -- the final one, global routing, CTS, detailed
    placement or the floorplan -- and the stage is named in the table (a run the job's time stops reports on the newest
    database there is).
    - A unit without placed figures in the tile estimate takes its 16 x 8 counterpart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
2026-10-13 A3: synth_report_drop043.md -- the sweep verdict 1,500 -> 1,250 ps, the three units, the DMA's two options, the check PE, the end times
    The synthesis report of drop 0.43 from CI run 186 (both libraries, the sweep; RTL and synth.py as every later commit)
    against run 180 (main): every unit outside the PE-limited ones clean from 1,250 ps on ASAP7 SS (1,500 before), the
    tile at 1,250 ps = 800 MHz; bank_bist_wrap 1,345 -> 1,182 ps, prog_mem 64 -> 0 violating, core_seq 1,110 -> 922 ps
    (neo_core 1,331 -> 1,180); the check PE 1,093 -> 1,057 ps and the array 1,421 -> 1,061 ps under the data PE's 1,095;
    Nangate45 bank_bist_wrap 1,589 -> 1,509 ps, still above its 1,500 grid step; the DMA's options meas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
2026-10-13 C2: the plans' perf model calibrated against the 136 phases of M21 / M23 / M24 on the RTL
    The first guess (3 cycles an instruction, 24 a fetch's request, 40 a run's fill, 12 a drain's tail) predicted M21 / M23
    / M24 at 37,836 / 51,632 / 57,826 cycles against 53,838 / 70,561 / 82,760 measured on the 2 x 2 mesh of 16x8 cores
    (cocotb tile, this branch's RTL): 30 % low. A non-negative least-squares fit over the 136 phases, with the array's
    M x runs and the unit's cycles (vec_ref's count) held exact, gives 21 cycles an instruction (issue plus a fetch's request
    and first word, a drain's set-up, WAIT_DONE's poll), 2.0 a fetched word at WPF = 1 (the pair's two tiles interleaved on
    the one bank that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
2026-10-13 C2: the vector unit's datapath out of Verilator's line / toggle coverage -- the coverage builds back under the runner's memory
    Run 201's hdl-sim ended with exit 143 in `make verilator` after tile, tile8, tile32, core32 and tile_sp had run (55 min):
    the coverage step builds core_cov / tile_cov / tile8_cov / tile32_cov in parallel (make -j4), which already peaked at
    15.6 GB of the runner's 16 GB in run 196 (build_stats.txt), and the pipelined unit's compressor rows, tree levels and
    stage registers add toggle points in every tile (a 32-lane unit verilated alone with --coverage-line / --coverage-toggle:
    11.5 MB of C++ and 509 MB in Verilator, against 8.6 MB / 195 MB for f63c666's unit). `/* veri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
2026-10-13 A3 §3: report.py and tile_table.py for a run the budget stopped early -- the newest stage's figures, the database the power ran on, how far the cut-off step got; the 32x32 core from its own global pl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
    report.py: a run that did not reach routing (neo_core in run 182: the placement's
    repair_design still buffering when run.py's 314-minute budget ran out) now reports
    the newest stage it reached -- utilization, cells and cell area, macros from the
    global placement or the floorplan, named as such -- says it has no timing instead
    of claiming the global route's, names the database neo_report's power ran on (the
    floorplan's: cells only), leaves out the routed-against-synthesized table when
    nei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
2026-10-13 A3 §4: power_drop043.md -- the routed blocks at the default activity and with the cocotb runs' recorded activity, 800 MHz on ASAP7 SS 0.63 V / 100 C; 0.86 pJ per MAC for the PE, 1.10 for the 16x8 arr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
    The conditions, the two recordings (the core's: C1 + C5 on the 16x8 core, 2,858
    cycles at 56.7 % MAC utilization; the tile's: M1 + M18 + M19 on the 2x2 mesh at 32
    words per flit, 10,306 cycles at 32.8 %), the table of every block (dynamic +
    leakage at both activities, the flops that took a recorded bit) and the figures for
    the spec's power line with their conditions: the data PE 0.390 mW (0.86 pJ per MAC),
    the 16x8 array 64.0 mW (1.10 pJ per data MAC, the check columns and the clock
    included)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
2026-10-13 A3 §5: the chip-level floorplan sketch -- floorplan.py draws the 8x8 tiles at their placed area, the bridge column and the licensed-IP placeholders: 14.15 x 10.76 mm = 152.2 mm2 on the proxy, 0.72 of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
    09_synthesis/floorplan/floorplan.py reads tile_routed.json (tile_table.py --json over
    the pnr runs 182-197 and synthesis run 198) and writes floorplan.svg: per tile the
    bank's 16 lane macros packed four across with their 20 um pin channels (1,394.3 x
    686.4 um) and below them the 32x32 core, the NIC, the router, the link pair, the
    bank's logic and the tile's control at the core areas their routed blocks occupied --
    1,394 x 1,175 um = 1.638 mm2 per tile, 104.8 mm2 for the 64;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
2026-10-13 C2: out_row from a copy of X of its own -- the unit's rows reach the requantizers from a flop's output alone
    Run 205 (525a7a3: the tile's sweep clean from 1,500 ps as main, the gates passing) left neo_core at 65 violating
    endpoints at 1,250 ps (main: 3), all on one path: vec_unit's out_row -- X's flops behind the fanout of every lane's
    adders, comparators, tree and LUT shifter, 292 ps to the port in the unit's timing model -- through the requantizer
    input mux into the requantizers' carry-save stage (883 ps of setup), 1,278 ps. out_row is now a third copy of X (xo,
    loaded with X's next value through its own output as xm is): a flop driving the port alone. Rows, cycles and every
    other path unc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
2026-10-13 C2: X a fourth time, for ADD_ROW's and BSUB's adders -- the 32-lane unit from 1,143 to 1,082 ps
    Run 209 (5fcf1f6, every job green) put the 32-lane vec_unit at 1,143.0 ps on X -> ADD_ROW's sum: X's flops (an
    asynchronous reset: ASAP7's x1 flop with its QN output) behind about twenty loads -- the comparators, the tree's first
    level, the LUT's shifter, X's hold, ADD_ROW's and BSUB's adders -- 230 ps before the 35-bit adder starts (run 205's netlist
    had the same 230 ps, its adder mapped shorter: 1,104 ps). ADD_ROW's and BSUB's adders now read a copy of X of their own (xa,
    loaded through its own output as xm and xo are). Locally (the flow reproduces CI to the cell: run 205's unit, 278,631
    cells,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
2026-10-13 Integration: the command memory and the bridge's write buffer connect neo_mem_rf's rb_addr_q -- make lint clean again
    D2 (PR #12) gave neo_mem_rf a port-B address-latch output, rb_addr_q (0 at RBQ = 0); B2 (PR #11) added two leaves after it
    was written -- top_ctrl's command memory u_cmem and noc_axi_bridge's write buffer u_wbuf -- without the pin, and the
    merged main (c024d465) fails `make lint` in its neo_top pass: two PINMISSING warnings. Both now connect it to an unused
    net in their unused-bits sinks, as tile_nic's leaves do; RBQ stays 0, nothing else changes. make lint: ten passes, 0
    warnings.
    Claude-Session: https://claude.ai/cod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
2026-10-20 HANDOFF-5: the state at drop 0.43 for Claude Code -- CLAUDE.md, the stream briefs in the repository, drops 0.42 / 0.43 documented, the GLS clock-gate fix
    HANDOFF-5.md (what is proven, measured and modelled; the open items S1 / A4 / D3 / F1; the method), CLAUDE.md (layout,
    commands, rules, CI reading), 00_overview/streams/ (COMMON.md for Claude Code, the twelve delivered briefs, four new ones),
    the drop log's 0.42 and 0.43 rows with their runs, the spec's ledger / §3 / §8 / §9 / §12 for both drops, the ROADMAP's
    status. 07_ci/synth/gls.py: a gated unit's RTL side gets neo_icg.sv (run 184's requant GLS: "Unknown module type: neo_icg").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
2026-10-20 D3: the ONNX importer (neo_onnx.py) and the post-training quantizer (neo_quant.py) with their tests
    neo_onnx.py: an opset-17 ModelProto to the compiler's layer list -- Conv (bias as an input or an Add, ReLU, SiLU as
    Sigmoid + Mul fused), MaxPool, Concat, Split, Resize (nearest, integer scales), MatMul / Gemm (bias, the Erf form of GELU
    and the contrib operator, SiLU), activation MatMuls with their scalar scale, Softmax with an additive mask,
    LayerNormalization, the Pow / ReduceMean / Sqrt / Div / Mul form of an RMS norm, Add, Transpose, Reshape, Flatten;
    shapes by execution checked against onnx.shape_inference; unsupported operators named with their node (strict) or
    listed (lenient). A float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
2026-10-20 D3: the scheduler (neo_sched.py), the runtime in C and Python over the command queue, the driver's register map
    neo_backend.compile_group gains the runtime's forms: drain_fmt (DR_P: INT8 rows padded to activation entries on a core
    with COLS < ROWS), int4 (WP4 words per entry, FETCH_W arg 1), rbuf (the owner's FETCH_A arg 1 of the residual rows);
    cfg_m = 0 refused (review finding 13) in compile_group and cq_image, and by neo_compile_group (-3) / neo_cq_image.
    neo_sched.py: a quantized network's tensors placed (padded channel tiles of min(ROWS, COLS) real channels; concat and
    split as views at channel-tile offsets; the memory window or a bank per tensor), every conv as groups (output tile x
    ro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
2026-10-20 D3: top T9 / T10 -- the runtime's two-layer network and the YOLOv8-m group replayed on the chip top
    T9: conv 20 -> 8 3x3 (bias, SiLU on the vector unit) then conv 8 -> 7 1x1 (bias) through importer, PTQ and scheduler,
    driven by the Python runtime's recorded transactions (the C runtime's trace compared identical in the test when a C
    compiler is at hand): the input into tile 3's bank through the host bridge with the fence, the weights in the memory
    window, two commands of the queue with their completion records and interrupts, the telemetry per step, the result
    read back through the host bridge bit-exact against the integer executor. 12.5 us of simulation.
    T10: the YOLOv8-m group (b0 3 -> 48 s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
2026-10-20 D3: the virtual device -- neo_perf_v3 calibrated against the measured cycles, tool_qual TQ7 / TQ8
    neo_perf_v3.py: the conv step model of the runtime's schedule on the chip top (per tile the instructions, every fetch a
    bridge request with its round trip and its words at the bridge's rate, the K-passes at the sequencer's pass spacing
    LAT + ROWS + 4, the vector unit's rows, the drained words, a contributor's partial sums and the owner's reduce; the
    step the slowest tile plus the bridge's serving of the other tiles' fetches and the host's part of the window);
    --collect builds perf_measured_044.json from a top T10 run (measured_t10.json) and a tile run's M21 / M23 / M24 / M25
    lines; --calibrate p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
2026-10-20 D3: make onnx / vdev, cdriver with the register-map and runtime checks, regress_ci extended; the ONNX packages in python-regress
    07_ci/Makefile: cdriver builds test_runtime and runs sim/check_regmap.py and sim/check_c_runtime.py after the backend
    check; onnx = test_neo_onnx.py, neo_quant.py and the two runtime builds' summaries; vdev = neo_perf_v3 --calibrate;
    regress_ci runs cdriver, onnx, vdev (about a minute more). Both workflow copies: pip install onnx onnxruntime in the
    python-regress job (byte-identical).
2026-10-20 D3: 04_software/README.md and 08_ip_product/evaluation.md -- the mechanisms and the evaluator's steps with the measured figures
    README: the pipeline's commands, the importer's operator coverage table, the PTQ mechanisms and accuracies, the
    runtime's sequence and trace format, T9 / T10's results with the measured cycles per layer and the utilization at the
    crop, the virtual device's error table and gaps. evaluation.md: seven steps an evaluator follows (set-up, importer,
    quantizer, the C driver / runtime checks, the chip-top suite, the virtual device, the reference networks), each with
    its command and the output it must give, the scale that ran and what did not, the open items.
    Co-Authored-By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
2026-10-20 D3: neo_quant's self-check takes the INT4 variant at the tests' bar (cos > 0.98; 0.999 for INT8)
    The self-check (make onnx) failed its own INT4 case at the INT8 bar of 0.99 (the C2f convs at 4-bit weights reach
    cos 0.987 / 15.8 dB, as test_neo_onnx.py Q5 and tool_qual TQ8 bound them).
2026-10-20 D3: the top suite's runtime tests renumbered T12 / T13 (R1's stream takes T9-T11), measured_t13.json
    The two tests, their log tags, the measured file the YOLOv8-m test writes, the perf model's collector and calibration
    keys, the Makefile's comment and both documents; nothing else changes (T12 / T13 rerun locally 2/2, the calibration
    table unchanged).
